appletonN/FYP/documents/Final Report/Gloss.tex

\usepackage{glossaries}

\glstoctrue
\makenoidxglossaries

\newglossaryentry{BlueLight}
{
    name=blue light,
    description={Short wavelength, high-energy - usually below 550nm}
}

\newglossaryentry{flux}
{
	name=luminous flux,
	description={the perceived power of a light source, measured in lumen}
}

\newglossaryentry{lux}
{
	name=lux,
	description={the SI unit of illuminance, measured by \gls{flux} per unit area. Equivalent to $lumens/m^2$}
}

\newglossaryentry{solar}
{
	name=solar irradiance spectrum,
	description={the spectrum output by the sun as measured from the surface of the earth}
}

\newacronym{pcbs}{PCBs}{Printed Circuit Boards} 

\newacronym{cfl}{CFL}{Compact Fluorescent Lamp} 

\newacronym{morning}{DY}{Daytime}

\newacronym{afternoon}{ST}{Sunset}

\newacronym{evening}{TW}{Twilight}

\newacronym{night}{NX}{Night}

\newacronym{spd}{SPD}{Spectral Power Density}

\newacronym{sam}{SAM}{Spectral Angle Mapper}

\newacronym{cri}{CRI}{Colour Rendering Index}

\newacronym{s}{S}{Short-Wavelength}

\newacronym{m}{M}{Medium-Wavelength}

\newacronym{l}{L}{Long-Wavelength}

\newacronym{iprgc}{ipRGC}{intrinsically photosensitive Retinal Ganglion Cells}

\newacronym{rtc}{RTC}{Real Time Clock}

\newacronym{ic}{IC}{Integrated Circuit}

\newacronym{esd}{ESD}{Electro-static Discharge}

\newacronym{cct}{CCT}{Correlated Colour Temperature}

\newacronym{car}{CAR}{Cortisol Awakening Response}

\newacronym{sad}{SAD}{Seasonal Affective Disorder}
