appletonN/FYP/documents/Final Report/PDFs/VI2.pdf

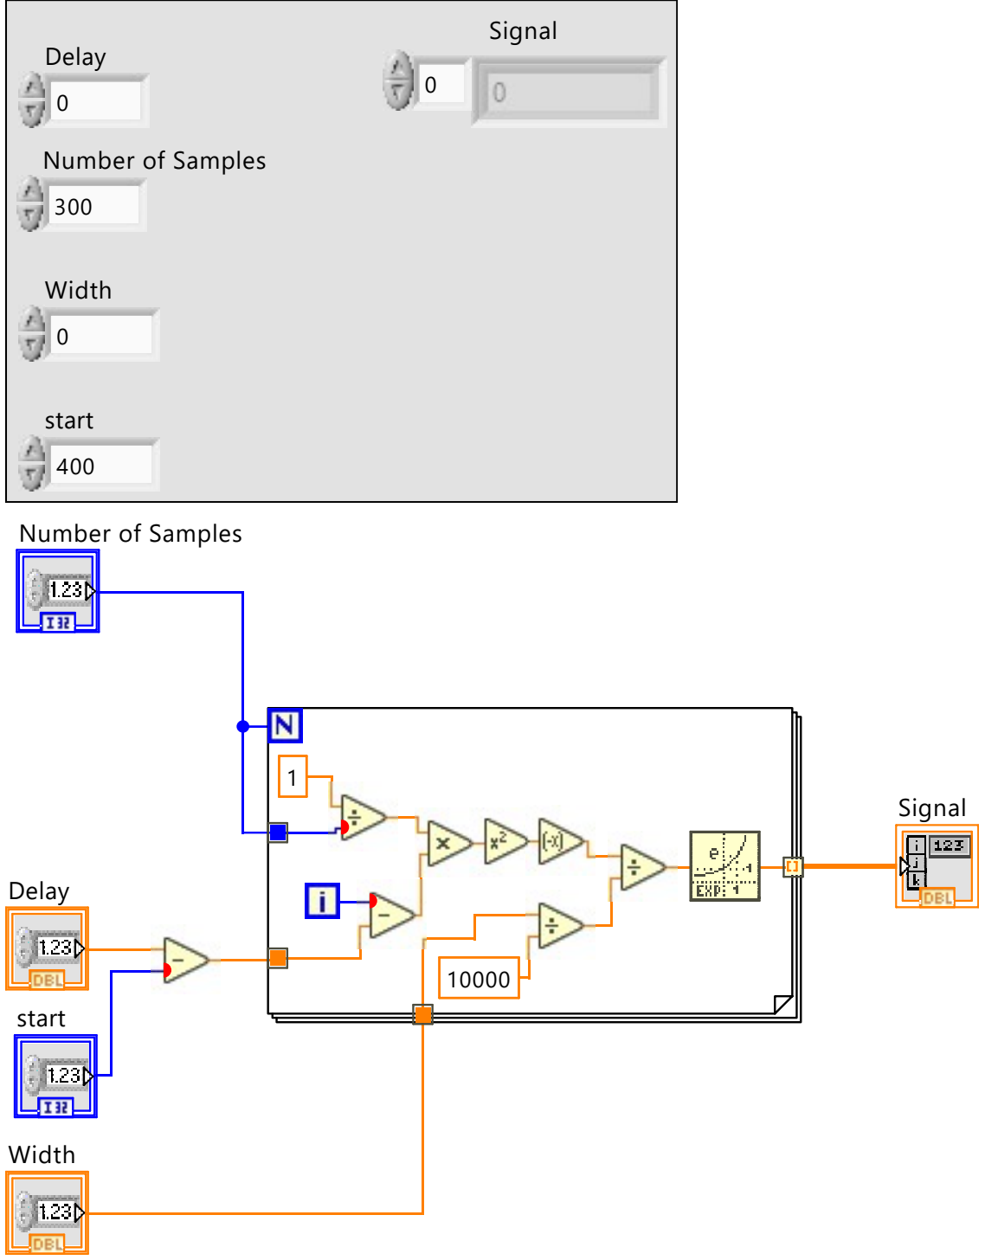
[picture p1: figure]
Delay; Signal; Number of Samples; Width; start
