appletonN/FYP/documents/Final Report/PDFs/VI3.pdf

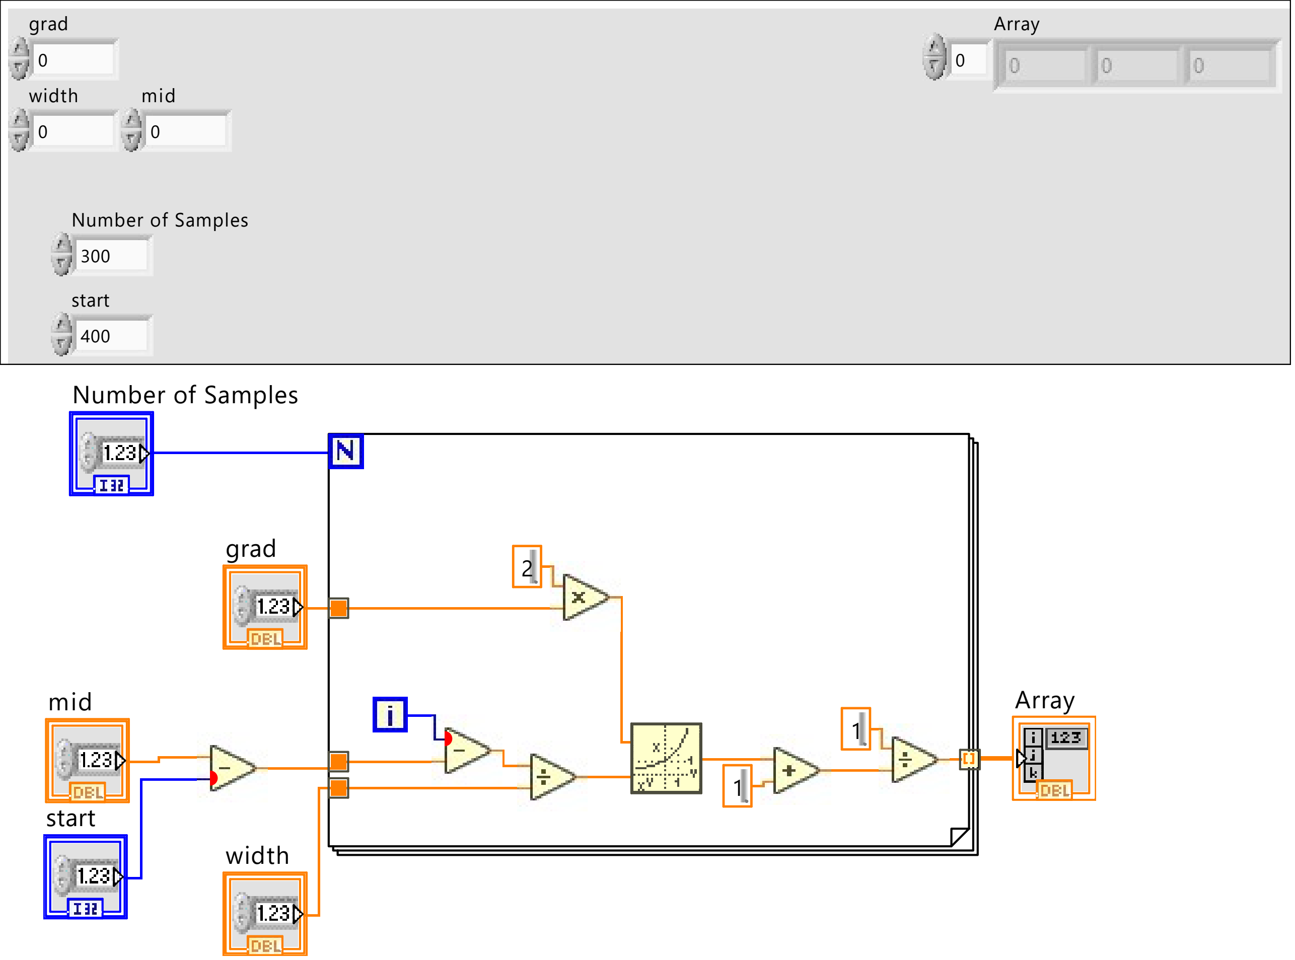
[picture p2: figure]
grad; width; mid; Number of Samples; Array; start
