appletonN/FYP/documents/Interim Proposal/Main/Interim Preposal.pdf

# Parting the Clouds: working towards an affordable natural-lighting solution

N. Appleton

16019243
nicholas2.appleton@live.uwe.ac.uk

### December 8, 2020

I. Introduction and Aims
F

or the past 100 years, the primary use of artificial light has been to allow people to operate beyond the scope of daylight hours. The foremost consideration, therefore, has been directed at the visual (Webb, 2006). However, since the turn of the 21st century, we have known that there are many non-visual effects of light, including the fact that it plays a central role in the sleep-wake cycle (or circadian rhythm) (Provencio et al., 2000; Berson et al., 2002). There is an extensive body of research showing that bright light can delay sleep onset and have negative ramifications on sleep quality. Not only does light affect our sleep, but it also affects our waking experience: mood is affected largely by light exposure, as are focus, attentiveness and even cognitive performance. All these factors are influenced by the environmental light conditions to which most people don not give a second thought. We can find the optimal light exposure for any time of day simply by looking outside: our bodies are naturally and precisely tuned to the cycles of the sun, and only in the past few hundred years have we forsaken these rhythms with large-scale artificial lighting.
The aims of this project are twofold: ’To produce a device that can replicate the visual output of the sun as closely as possible’ and ’To validate the design by measuring the spectral output and validating the efficacy’. Further aims would be to develop the device as a product: improving the user interface and expanding its functionality. The production of the device will be split between me and Vojtˇech Halenka. The completion of these goals will be made against a Product Requirements document (see appendix D).
The objectives of the project, which will help achieve the aims, are to work with Vojtˇech to produce a schematic that can be tested and turned into a PCB that we can get printed. With these first PCBs we can fully test our design, make any relevant changes and produce a second design from that. Once we know we have a working unit, I will be able to test the spectral output and assess the effect of the device on sleep (the research phase will be conducted independent of Vojtˇech). If This is completed in a timely manner, I would also like to implement an improved UI and extra features to make the device more complete and user-friendly.

II. Justification

The device we are producing will have the fundamental purpose of improving the health of its users. There is a wealth of knowledge demonstrating how important exposure to natural lighting patterns is on our well-being, but none of the devices currently on the market are appropriate for the problem we are trying to solve. Through a competitor review (Appleton, 2020), I found that the majority of

1

Interim Report • December 8, 2020• 16019243

circadian lighting is for industrial (office and warehouse) use, rendering it almost pointless if the workers go home to a house equipped with standard LED lighting technologies. The few consumer grade circadian lights on the market are extortionately expensive: upwards of $200 for a single bulb. Moreover, these can only be used in places with existing bulb fittings and therefore are not feasible for many environments. There are other devices on the market that claim to respect circadian rhythms, but many of these devices are designed either for use at specific times of day, or for ‘mood lighting’ with circadian regulation as an option only if you “hack” them - ‘entertainment, not entrainment’ as I like to say - therefore they are not equipped with appropriate lighting for the evening hours. By creating a standalone, 12-Volt, expandable and affordable solution, we will be bringing this essential technology to many more people to whom it is not currently available.
If we look at the United Nations’ Sustainable Development Goals (UN-DESA, 2016), we can see that ‘Ensuring healthy lives and promoting well-being for all at all ages’ is one of the goals, as is ‘Making cities and human settlements inclusive, safe, resilient and sustainable’. My project will try to encompass both of these goals by creating a more healthpromoting, human-centric built environment that cares for the health of those exposed to its outputs. It will also be helping to reduce energy consumption by replacing outdated technologies such as incandescent and fluorescent bulbs that are both inefficient and polluting to produce and dispose of.
By making the device modular - consisting of many mix-and-match components - the user will be able to customise their device to fit their space, requiring fewer unique module designs to be produced, while still providing a scalable solution to the problem.

### III. Scope

This project aims to deliver a works-like prototype that can be used to assess the validity of the design for use as an all-day lighting system. The design considerations for a final product, as well as user safety, will be observed throughout the design process. Ideally, the final outcome will be a looks-like, works-like prototype in the form of a demonstrable unit. There are 3 main milestones for the development: completion of a functional unit, testing and validation of said unit, and furthering the design and usability once the functionality has been validated.
Doing a human trial of the effects on sleep is Out-Of-Scope of this project, both due to the ethical and resource requirements of a sleep study and due to the current pandemic. However, the effects on sleep will be assessed via observation of the output spectra of the device. The current global situation of Covid-19 will have significant impacts on the completion of this project. Delivery times for components could be affected and access to equipment will be severely limited. Throughout the project, government guidance will always be followed and contingency plans put in place for each part of the project. While we are awaiting the delivery of components and PCBs, I will develop a simulator that can be used to calculate the output of the device, ensuring that I can complete the research, even if no demonstrable unit can be fabricated. The Gantt chart will also reflect this situation by allowing more time for delivery and development.
The device will be an autonomous system that requires user-input only to set parameters of the time-scale events. It will be developed from ‘cradle to grave’ with an emphasis on giving me a broader understanding of the tools and techniques used to design and develop systems like this to a given requirement. I hope this project will offer me a more practical experience of the design cycle and processes involved with creation of automated systems.

IV. Proposed Research Questions

The main question that will be researched through this project will be “Can we can develop a device that is suitable to use through-

2

out the day and night without negatively impacting the human cycles that we are aware of, namely the circadian rhythm?” An additional question that will be considered throughout the project will be “Would this device be a viable product that appeals to consumers?” Further questions would include how people respond to using the product and whether to implement more natural variations such as ‘clouds’ and flickering ‘firelight’ to observe the effect this might have on users. However, it is unlikely that the scope of this project will allow for these questions to be answered - perhaps in future research.

V. Initial Research

Electric lighting plays a large role in modern life: extending our day beyond the natural boundaries of sunset and sunrise. Our primary concern for lighting has become to provide us with accurate visual performance beyond the scope of the day - however, in recent years it has become more and more obvious that this is not optimal for human health, or even performance for that matter.
All animals have a built in circadian rhythm that regulates their day/night cycle. This rhythm is fundamental to allow the body to effectively rest - in humans - overnight (Senthilnathan and Sathiyasegar, 2019). The circadian clock controls melatonin production in the brain, an important factor in the generation and quality of sleep (Arendt, 2003). There are many peripheral clocks that help to set the central clock every day and keep it running on-time (Mohawk et al., 2012; Richards and Gumz, 2012). One of the most important of these cues comes from light exposure (Czeisler et al., 1986; Laakso et al., 1993), especially blue, short-wavelength light (Thapan et al., 2001; Figueiro et al., 2013). However, this is one of the most overlooked areas in modern built environments (Webb, 2006).
There are some solutions to counter this pervasive problem, for example wearing amber tinted glasses to block out the shortest wavelengths of light was shown by Kimberly and

Phelps (2009) to improve sleep quality. Not everyone wants to have to wear amber glasses after dark every night, especially in their own home! Furthermore, it greatly affect one’s ability to see colours accurately when wearing such glasses. Other methods include ‘Smart Lighting’ which can be set to fade into different colours at different times, but while this may improve mood (McCloughan et al., 1999), it will not have a hugely positive effect on sleep as RGB LEDs are used to achieve the desired colour. This means the colour will almost certainly have a harmful blue component, while according to Gilewski (2018), RGB LEDs are a wholly harmful form of lighting (although this study is lax in its sources and its referencing, so perhaps should be taken with a pinch of salt).
Older technologies, such as incandescent bulbs, produce a spectrum much closer to that of firelight (f.lux Software LLC, n.d.). However, they are so inefficient that they are banned from being sold in the EU (2012). The replacements for these technologies - Fluorescent bulbs and LEDs - have been shown to produce harmful light (Ueda et al., 2009; Kuse et al., 2014; Niwano et al., 2014; Marek et al., 2018; Nakamura et al., 2018), and many traditional bulbs of this type contain hazardous materials such as lead (Lim et al., 2013). However, there is huge potential for LEDs to save much power in the built environment (Montoya et al., 2017), but this shouldn’t come at the expense of human (circadian) health.
Another surprising impact the circadian rhythm has on our lives is in the realm of cancer; a powerful link has been demonstrated between circadian suppression and breast cancer in rats (Mhatre et al., 1984; Otálora et al., 2008; van den Heiligenberg et al., 1999) and in humans - mostly observed in shift workers and flight attendants (Hansen, 2001; Davis et al., 2001; Schernhammer et al., 2001, 2006; Lie et al., 2006; Tokumaru et al., 2006; O’Leary et al., 2006; Kolstad, 2008; Stevens, 2009; Stevens et al., 2014).
It’s not all bad for blue light, though. It is widely accepted that bright light is an effec-

3

tive treatment for Seasonal Affective Disorder (SAD) (Eastman et al., 1998; Magnusson and Kritbjarnarson, 1991) and lee et al. (1997) found in their meta-analysis that shorter (blue) wavelengths appear to have a greater effect. Furthermore, many studies have shown a positive correlation between blue light and attentiveness, cognitive performance and visual tasks throughout the day (Sun-Young, 2005; Mills et al., 2007; Lehrl et al., 2007; Hawes et al., 2012). This also has been shown to be linked directly back to the circadian rhythm (Hawes et al., 2012).
From the evidence presented here, I hope it is clear why a product that can produce a spectrum close to that of the sun would be beneficial to people’s health and well-being throughout the day, and therefore why we have decided to develop and test one.

VI. Methodology

The word methodology is defined by Collins English Dictionary (2014) as “a system of methods and principles for doing something, for example for teaching or for carrying out research”. An example of this would be the the Scientific Method which is a method in which knowledge is acquired through experimentation and analysis to confirm or deny a hypothesis.
In section IV, I discussed the proposed research questions in which I laid out my primary research question, which can be made into the hypothesis H1: “We can produce a device that can effectively be used throughout the day while avoiding a circadian phase-shift of more than 30 minutes”. This hypothesis can be tested with various tools and techniques provided by the literature and can be easily falsified, too. This hypothesis will be investigated using quantitative methods: collecting empirical data that will be analysed to determine if the null or alternative hypothesis can be accepted. However there are other peripheral hypotheses relating to the development of the device as a viable product. Some qualitative research would ideally take place to assess how people react to various aspects of the device which will lead to a discussion about how further development could take place, but this may be out of scope of this project due to the pandemic situation.
A more top-down view of the falsifiable points that will be used to determine whether we have succeeded in the project are laid out in the Requirements document (See appendix D).
While the term ‘method’ can easily be confused with a methodology, it refers to how the data will be collected, or how the subject will be observed. For the hypothesis H1, experiments will be the method used to obtain the data; I will use a hyper-spectral camera to capture the spectra of the device alongside the spectra of other, similar devices. The outputs of these devices can then be compared and calibrated to more absolute values by comparing to a known source. These data will then be used to assess the efficacy of the device as a night-time light. Another method of secondary data can be used to compare the results with a broader catalogue of results gathered by others.
For any qualitative research that were to take place, I would ideally use a participant observation and survey methods to discover people’s opinions on the given research topic, but it is more feasible to just use a survey in these times.

VII. Project Management and

Planning

The project management software ClickUpTM Project Management (2020) software will be used as the primary project management tool: it will contain the open, in progress and closed tasks; the Gantt chart and due dates of each deliverable, milestone and task; and documents such as my logbook and meeting minutes will be stored there.
Weekly meetings are taking place between my supervisor and me, and minutes are being kept for these meetings in my logbook. I am also having weekly meetings with V. Halenka to discuss the progress of the development

4

phase, delegate tasks, make design decisions and consolidate new knowledge in the subject. The time-scale of the project has been heavily influenced by the supply chain and potential delays that may occur. As can be seen in the Gantt chart (See appendix ), we have allocated up until February for the final prototype to be ready. Work towards the research goals will happen alongside the development of the prototype - especially during the periods allocated for delivery.
The project will require more resources than some, as it involves the design and production of hardware; we will be sure to keep our minds on the sustainability of the solution by ensuring that all electronic components used are RoHS compliant. The design of the device is also modular which not only will make it more accessible, but will reduce the obsolescence of the product, as individual modules can be replaced when needed, rather than having to replace the whole unit. Another environmental implication will be the shipping of the PCBs from the factory in China to us in the UK. This is difficult to avoid as any UK-based PCB companies are well out of our budget. However, as this is a very limited production run, this could be re-assessed in the event of larger-scale production. Other resources include a hyperspectral camera (already sourced) which does not have any upfront environmental hazard as it is already at the university. The only other identified resource that I require is software such as Matlab and LABview that are already provided by the university (See Appendix C). As there are not going to be any observations made on humans, the ethical considerations will be very limited. An Ethics checklist has been completed with my supervisor to ensure that the project is ethically valid. If qualitative data is required at the later stages of the project then I will re-consider the ethical implications, as this will require thought on data-handling and management and respect of the participant’s privacy and right to withdraw. If this does happen, then I will collect no personal data from the participants and all responses will be anonymised with an identification number that can be used to withdraw from the research.
This project definitely has some limitations to it: the budget is very limited for a project such as this and £75 is not enough to design and build a working prototype. Fortunately, as there are 2 of us working on the hardware, we will be able to double this budget, which should be enough to make at least a couple of demonstrable units. This project is also very limited in time: we have only 6 months to create, test, and research a working prototype
- alongside all of our other modules; we will have to manage our time well to be able to complete the task. Further, due to Covid-19, we have very limited access to facilities, which will make it harder to do effective testing and production. To mitigate this, we will be using strategies to maximise the efficiency of any lab time we get: we will get the PCBs populated at the factory so we can spend as little time as possible doing production ourselves, and we will ensure that any lab time we get we carefully plan a strategy for how we will use that time.
Throughout the project I will adopt a security-minded approach: all correspondences made will be done so with consideration to the sensitivity of the information being shared. When sensitive data is being shared, I will ensure its security by way of agreement of all relevant parties understanding said sensitivity and signing a security form to ensure that they will not share the information with any outside parties.

VIII. Activities and Results to

Date

To begin the project I conducted a series of interviews with Natural Movement and Lifestyle practitioners to discuss my initial ideas. After 5 interviews I determined that the direction of the project was not what was needed in their field, so I pivoted into circadian lighting, as that is something that all of the interviewees had expressed an interest in. From there I have read through a large amount of the literature

5

relevant to the topic, while concurrently completing the administrative setup of the project; I have set up the project management software ClickUpTM Project Management (2020) and populated it with the overall aims, objectives, milestones and tasks that are required to complete the project. From this, I produced the Gantt chart which is synced to the task list for autoupdating for future ease. The risk assessment and security forms, as well as the resources form, have also been completed (See appendices A, B & C).
To date, V. Halenka and I have a completed initial schematic that is ready to be laid-out onto a PCB and sent off for printing and populating. We have conducted some tests to ensure that some sub-circuits will work as intended and we have conducted a design review of our schematics. We are minimising the risk of slow deliveries by extending the time allocated to them on the Gantt chart, which will be assessed and updated every 2 weeks.
A hyperspectral camera has been sourced from the university and I am in ongoing talks to relocate it to somewhere where I will have access to it. I have also drafted a simulator in LABview for the output of the device to complete some tests before we receive the PCBs and to mitigate the risk of not having access to the hyperspectral camera due to Covid or other unforeseen issues.
A logbook is being kept to record the work that is being done and has been shared with my supervisor.

References

Appleton, N. (2020), Competitor Analysis, https://doc.clickup.com/d/h/2fg5t-890/135795402bf68e8, UWE.

Arendt, J. (2003), ‘Importance and Relevance of Melatonin to Human Biological Rhythms: Melatonin and human rhythms’, Journal of Neuroendocrinology 15(4), 427–431.

Berson, D. M., Dunn, F. A. and Takao, M. (2002), ‘Phototransduction by retinal ganglion cells that set the circadian clock’, Science (New York, N.Y.) 295(5557), 1070–1073.

ClickUpTM | Project | Management | (2020),
https://clickup.com/.

Collins English Dictionary (2014), twelfth edn, Collinns Dictionaries.

Czeisler, C. A., Allan, J. S., Strogatz, S. H., Ronda, J. M., Sanchez, R., Rios, C. D., Freitag,
W. O., Richardson, G. S. and Kronauer, R. E. (1986), ‘Bright light resets the human circadian pacemaker independent of the timing of the sleep-wake cycle’, Science 233(4764), 667– 671.

Davis, S., Mirick, D. K. and Stevens, R. G. (2001), ‘Night Shift Work, Light at Night, and Risk of Breast Cancer’, JNCI: Journal of the National Cancer Institute 93(20), 1557–1562.

Eastman, C. I., Young, M. A., Fogg, L. F., Liu,
L. and Meaden, P. M. (1998), ‘Bright Light Treatment of Winter Depression: A Placebo-Controlled Trial’, Archives of General Psychiatry 55(10), 883.

EU (2012), ‘Directive 2012/27/EU of the European Parliament and of the Council of 25 October 2012 on energy efficiency, amending Directives 2009/125/EC and 2010/30/EU
and repealing Directives 2004/8/EC and 2006/32/EC (Text with EEA relevance)’, https://www.legislation.gov.uk/eudr/2012/27/2020-01-01.

Figueiro, M. G., Bierman, A. and Rea, M. S. (2013), ‘A train of blue light pulses delivered
through closed eyelids suppresses melatonin and phase shifts the human circadian system’, Nature and Science of Sleep 5, 133–141.

f.lux Software LLC (n.d.), ‘F.luxometer’, https://fluxometer.com/rainbow/.

Gilewski, M. (2018), ‘The Ecological Harmfulness of RGB LED Light’, DEStech Transactions on Environment, Energy and Earth Sciences 1(epeee), 89–93.

6

Hansen, J. (2001), ‘Increased Breast Cancer Risk among Women Who Work Predominantly at Night’, Epidemiology 12(1), 74–77.

Hawes, B. K., Brunyé, T. T., Mahoney, C. R., Sullivan, J. M. and Aall, C. D. (2012), ‘Effects of four workplace lighting technologies on perception, cognition and affective state’, International Journal of Industrial Ergonomics 42(1), 122–128.

Kimberly, B. and Phelps, J. R. (2009), ‘Amber Lenses to Block Blue Light and Improve Sleep: A Randomized Trial’, Chronobiology International 26(8), 1602–1612.

Kolstad, H. A. (2008), ‘Nightshift work and risk of breast cancer and other cancers—a critical review of the epidemiologic evidence’, Scandinavian Journal of Work, Environment & Health 34(1), 5–22.

Kuse, Y., Ogawa, K., Tsuruma, K., Shimazawa, M. and Hara, H. (2014), ‘Damage of photoreceptor-derived cells in culture induced by light emitting diode-derived blue light’, Scientific Reports 4(1), 5223.

Laakso, M.-L., Hätönen, T., Stenberg, D., Alila,
A. and Smith, S. (1993), ‘One-hour exposure to moderate illuminance (500 lux) shifts the human melatonin rhythm’, Journal of Pineal Research 15(1), 21–26.

lee, T. M. C., Chan, C. C. H., Paterson, J. G., Janzen, H. L. and Blashko, C. A. (1997), ‘Spectral properties of phototherapy for seasonal affective disorder: A meta-analvsis’, Acta Psychiatrica Scandinavica 96(2), 117–121.

Lehrl, S., Gerstmeyer, K., Jacob, J. H., Frieling, H., Henkel, A. W., Meyrer, R., Wiltfang, J., Kornhuber, J. and Bleich, S. (2007), ‘Blue light improves cognitive performance’, Journal of Neural Transmission 114(4), 457–460.

Lie, J.-A. S., Roessink, J. and Kjærheim, K. (2006), ‘Breast Cancer and Night Work among Norwegian Nurses’, Cancer Causes & Control 17(1), 39–44.

Lim, S.-R., Kang, D., Ogunseitan, O. A. and Schoenung, J. M. (2013), ‘Potential Environmental Impacts from the Metals in Incandescent, Compact Fluorescent Lamp (CFL), and Light-Emitting Diode (LED) Bulbs’, Environmental Science & Technology 47(2), 1040–1047.

Magnusson, A. and Kritbjarnarson, H. (1991), ‘Treatment of seasonal affective disorder with high-intensity light: A phototherapy study with an icelandic group of patients’, Journal of Affective Disorders 21(2), 141–147.

Marek, V., Mélik-Parsadaniantz, S., Villette, T., Montoya, F., Baudouin, C., Brignole-Baudouin, F. and Denoyer, A. (2018), ‘Blue light phototoxicity toward human corneal and conjunctival epithelial cells in basal and hyperosmolar conditions’, Free Radical Biology and Medicine 126, 27–40.

McCloughan, C. L. B., Aspinall, P. and Webb,
R. (1999), ‘The impact of lighting on mood’, Lighting Research and Technology 31(3), 81–88.

Mhatre, M. C., Shah, P. N. and Juneja, H. S. (1984), ‘Effect of varying photoperiods on mammary morphology, DNA synthesis, and hormone profile in female rats’, Journal of the National Cancer Institute 72(6), 1411–1416.

Mills, P. R., Tomkins, S. C. and Schlangen, L. J. (2007), ‘The effect of high correlated colour temperature office lighting on employee well-being and work performance’, Journal of Circadian Rhythms 5(1), 2.

Mohawk, J. A., Green, C. B. and Takahashi,
J. S. (2012), ‘Central and Peripheral Circadian Clocks in Mammals’, Annual Review of Neuroscience 35(1), 445–462.

Montoya, F. G., Peña-García, A., Juaidi, A. and Manzano-Agugliaro, F. (2017), ‘Indoor lighting techniques: An overview of evolution and new trends for energy saving’, Energy and Buildings 140, 50–60.

Nakamura, M., Yako, T., Kuse, Y., Inoue, Y., Nishinaka, A., Nakamura, S., Shimazawa, M. and Hara, H. (2018), ‘Exposure to excessive

7

blue LED light damages retinal pigment epithelium and photoreceptors of pigmented mice’, Experimental Eye Research 177, 1–11.

Niwano, Y., Kanno, T., Iwasawa, A., Ayaki,
M. and Tsubota, K. (2014), ‘Blue light injures corneal epithelial cells in the mitotic phase in vitro’, British Journal of Ophthalmology 98(7), 990–992.

O’Leary, E. S., Schoenfeld, E. R., Stevens, R. G., Kabat, G. C., Henderson, K., Grimson, R., Gammon, M. D. and Leske, M. C. (2006), ‘Shift Work, Light at Night, and Breast Cancer on Long Island, New York’, American Journal of Epidemiology 164(4), 358–366.

Otálora, B. B., Madrid, J. A., Alvarez, N., Vicente, V. and Rol, M. A. (2008), ‘Effects of exogenous melatonin and circadian synchronization on tumor progression in melanomabearing C57BL6 mice’, Journal of Pineal Research 44(3), 307–315.

Provencio, I., Rodriguez, I. R., Jiang, G., Hayes,
W. P., Moreira, E. F. and Rollag, M. D. (2000), ‘A Novel Human Opsin in the Inner Retina’, The Journal of Neuroscience 20(2), 600–605.

Richards, J. and Gumz, M. L. (2012), ‘Advances in understanding the peripheral circadian clocks’, The FASEB Journal 26(9), 3602–3613.

Schernhammer, E. S., Kroenke, C. H., Laden, F. and Hankinson, S. E. (2006), ‘Night Work and Risk of Breast Cancer’, Epidemiology 17(1), 108–111.

Schernhammer, E. S., Laden, F., Speizer, F. E., Willett, W. C., Hunter, D. J., Kawachi, I. and Colditz, G. A. (2001), ‘Rotating Night Shifts and Risk of Breast Cancer in Women Participating in the Nurses’ Health Study’, JNCI: Journal of the National Cancer Institute 93(20), 1563–1568.

Senthilnathan, S. and Sathiyasegar, K. (2019), Circadian Rhythm and Its Importance in Human Life, SSRN Scholarly Paper ID 3441495, Social Science Research Network, Rochester, NY.

Stevens, R. G. (2009), ‘Light-at-night, circadian disruption and breast cancer: Assessment of existing evidence’, International Journal of Epidemiology 38(4), 963–970.

Stevens, R. G., Brainard, G. C., Blask, D. E., Lockley, S. W. and Motta, M. E. (2014), ‘Breast cancer and circadian disruption from electric lighting in the modern world’, CA: A Cancer Journal for Clinicians 64(3), 207–218.

Sun-Young, L. (2005), ‘An Experiment on Lighting Environment for some Behavior in Housing’, Journal of the Korean housing association 16(4), 65–71.

Thapan, K., Arendt, J. and Skene, D. J. (2001), ‘An action spectrum for melatonin suppression: Evidence for a novel non-rod, non-cone photoreceptor system in humans’, The Journal of Physiology 535(1), 261–267.

Tokumaru, O., Haruki, K., Bacal, K., Katagiri, T., Yamamoto, T. and Sakurai, Y. (2006), ‘Incidence of Cancer Among Female Flight Attendants: A Meta-Analysis’, Journal of Travel Medicine 13(3), 127–132.

Ueda, T., Nakanishi-Ueda, T., Yasuhara, H., Koide, R. and Dawson, W. W. (2009), ‘Eye damage control by reduced blue illumination’, Experimental Eye Research 89(6), 863– 868.

UN-DESA (2016), ‘The Sustainable Development Goals Report 2016’, UN .

van den Heiligenberg, S., Deprés-Brummer, P., Barbason, H., Claustrat, B., Reynes, M. and Lévi, F. (1999), ‘The tumor promoting effect of constant light exposure on diethylnitrosamine-induced hepatocarcinogenesis in rats’, Life Sciences 64(26), 2523– 2534.

Webb, A. R. (2006), ‘Considerations for lighting in the built environment: Non-visual effects of light’, Energy and Buildings 38(7), 721–727.

8

Page 1 of 1

Describe the activity being assessed: Producing a natural-cycle based lighting system | Assessed by: Matthew Studley | Endorsed by:
Who might be harmed: Nick Appleton (NA) 1 How many exposed to risk: | Date of Assessment: 03/11/20 | Review date(s):
Hazards Identified (state the potential harm) | Level | | Level | By whom and by when | Date completed
Potential use of Lab equipment | | equipment is used properly and switched off when not in use | | | consistently | Ongoing
Covid-19 Risk from face-to-face meetings | | and where this is not possible, ensuring to meet in appropriate, well-ventilated spaces with 3-layered face coverings and keeping at least 1.5m distance | | | meeting | Ongoing
Soldering: very high temperature, hand-held iron | | it is not being used. Minimise the number of sessions spent soldering, while not allowing any rushing to occur. | | | soldering | Ongoing
High-power electronics pose an electrocution risk | | grounding bracelet connected to an anti-static mat and earthing point to discharge any potentially harmful electrical surges | | | whenever handling electronics | Ongoing
Isolation from working from home and related stress | | that overworking doesn’t occur by time-boxing various tasks and implementing effective project-management strategies | | | under evaluation | Ongoing
Existing Control Measures | S | L | Risk
Additional Control Measures | S | L | Risk
Existing risk assessment including mitigations | 3 | 2 | 6 | Keeping a clean workspace and ensuring that
3 | 1 | 3 | NA -
Government and University rules and guidance | 3 | 3 | 9 | Conducting all meetings online where possible,
3 | 1 | 3 | NA – Every
2 | 3 | 6 | Make sure to store the iron in the holder when
2 | 2 | 4 | NA – all
4 | 2 | 8 | Whenever handling electronics, wearing a
3 | 1 | 3 | NA –
3 | 3 | 6 | Implement stress-relief measures and ensure
2 | 1 | 2 | NA – Always

RISK MATRIX: (To generate the risk level).

Very likely 5

Likely 4

Possible 3

Unlikely 2

Extremely unlikely 1

Likelihood (L) Severity (S) | Minor injury – No first aid treatment required 1 | Minor injury – Requires First Aid Treatment 2 | Injury - requires GP treatment or Hospital attendance 3 | Major Injury 4 | Fatality 5

ACTION LEVEL: (To identify what action needs to be taken).

POINTS: | RISK LEVEL: | ACTION:
1 – 2 | NEGLIGIBLE | No further action is necessary.
3 – 5 | TOLERABLE | Where possible, reduce the risk further
6 - 12 | MODERATE | Additional control measures are required
15 – 16 | HIGH | Immediate action is necessary
20 - 25 | INTOLERABLE | Stop the activity/ do not start the activity

## GENERAL RISK ASSESSMENT FORM

A. Risk Assessment

Engineering Design and Mathematics
- UK Engineering Council Guidance on Security

Security is an important consideration for any project and in any workplace. UK SPEC provides guidance on security and outlines how it expects professional engineers to conduct themselves with respect to security. This guidance is split into six key principles. Your task is to visit the UK SPEC security page and read through the tips provided for each principle.
Using the tips on the webpage provide at least one example for each of the six principles that you can directly link to your project or that should be considered in the role of Professional Engineer. Then summarise your findings in the comments box below.
The link is https://www.engc.org.uk/security
- How would you adopt a security-minded approach to your project?
- be responsive to changes in the operating environment, including the impact of changes in use of the asset or system, its wider connectivity and emerging threats and vulnerabilities. With the current situation with working from home and potential changes to the working environment, this will be relevant to how I consider security.
- remember that security risk assessment is an aid to professional judgement, not a substitute for it. I will continue to assess any and all security risks throughout the project to ensure that any risks are neutralised as quickly as possible.
- What should you consider in order to apply responsible judgement and take a leadership role?
- working with other professionals to ensure informed, proportionate, holistic judgements. When I am working with other professionals – eg. When using equipment like a hyper-spectral camera – I will strive to ensure that we both are remining security minded throughout the work
- being prepared to challenge assumptions and proposals. If when working with one of these professionals, they do something that could potentially cause a security risk, I will certainly be prepared to challenge them and stop them from presenting those risks.
- How will you ensure that your project complies with legislation and codes, while understanding intent and prepared to seek further improvements?
- be aware of, and comply with, the security-related laws in countries where they operate or where their products or services will be used. As I will be developing a prototype product, I will ensure that I am aware of the relevant laws and will comply with them entirely when developing my product.
- be open-minded and avoid using regulations to facilitate complacency. By constantly evaluating the security risks, I will ensure that I am constantly staying on the ball, and not becoming complacent.
- How do you ensure good security-minded communications?
- adopt appropriate measures to protect sensitive information when it is communicated, used and stored, both within and beyond their organisation. Whenever sharing information, I will ensure that it is done in a secure way, and I will communicate when it needs to remain secure.
- recognise the persistent nature and accessibility of information published on the internet or otherwise made publicly available. Before making any information publicly available on the internet, I will ensure to conduct a thorough review of the content and redact or not publish any sensitive information.
- recognise that indiscriminate publication of project, technical or personal information can aid reconnaissance and enable security breaches through social media. No personal, technical or project information will be shared on social media.
- ensure responsible use of social media use for both personal
and professional purposes. I will avoid using social media for ANY professional or personal uses throughout the year.
- How would you go about understanding, complying with and seeking to improve lasting systems for security governance?
- ensure that there are appropriate mechanisms for reporting and feedback on security incidents and issues. Security discussions will occur often with my supervisor to ensure that any security issues can be reported as quickly as possible.
- contribute to the development and review of relevant security management frameworks, particularly about aspects which may not be well understood. All the security frameworks used for this project will be made by me with the specifics of this project in mind
- What do you need to consider when contributing to public and professional awareness of security?
- be security-minded during public discussion. When publicly discussing the project, I will ensure not to share any sensitive information about any part of the project.
- contribute to public and professional awareness of security by sharing and promoting knowledge of effective solutions. When I come across useful security resources, I will share them with my supervisor and ask that he can share them to more people that that resource will be relevant to.

Summarise how you will address security in your project (max 200 words)
By avoiding sharing any information about my project publicly, I will be able to reduce a large portion of the security risks involved. If I do speak about my project with others, I will make sure to only share with them information that has been labelled as safe. If it is required for me to share sensitive information with any other party, I will ensure that they are aware of the sensitivity of the data and that they have signed a form to ensure they do not share this data without my consent, which will be withheld unless the sharing of said data is strictly necessary.
As I do not plan to use human subjects in my project, I hope to minimise the amount of sensitive information that is collected for the project. However, I will still scrutinise every piece of information gathered and generated for the project to ensure that it doesn’t pose a security risk.
B. Security Form

# Dissertation Project Resources Form

Name: Nicholas Appleton | Student ID: 16019243

### Supervisor: Matthew Studley

[If you are carrying out a desk-based study and/or are only using the library or ITS facilities available at UWE, the faculty’s risk assessment procedures will sufficiently cover your activities. In these circumstances, you should identify this on your risk assessment form, which you should attach -

### along with this form - to your Interim Research Proposal.]

Please sign below to confirm your request for resources.

### Student: | 02/12/20

### Supervisor: |

### Further Resources – what else will you need?

R-Block workshop | □
N-Block workshop | ⊠
3D printing | □
Laser cutting | □
Large format printing | □
Miscellaneous | □

### Labs:

Structures | □
Materials | □
Composites | □
Hydraulics | □
Wind tunnel/aero | □
Car/flight simulator | □
Engine test bays | □
Robotics | □
Dynamics | □

If you have ticked any of the above, please fill out a risk assessment of your activities.

Have you spoken to a technician? | Yes | x | Not yet | □

### Materials - outline the materials required for your project:

Electronic components
- Resistors and Capacitors
- LEDs
- USB Circuits
- Transistors
- SD card
- Alphanumeric Display
- Power regulation
- Input and Output ports
- PCBs (printed and placed)
- Optical Encoder
- RTC module

University Resources
- Electronics Lab
- Hyperspectral Camera and Software
- Matlab & Labview Software
C. Resources Form

Context for Use

ID | CX
1 | Users must be able to use this light as their main light source throughout the day
2 | Should be able to light spaces of any size (scalable solution)

Key Features

Sleep

ID | SL1
1 | Should not affect users sleep in any meaningful way by only exposing them to appropriate spectra after dark

High-Level Requirements

Cycles

ID | CY
1 | Should expose users to as natural light-patterns as possible throughout the day and night

Morning and Daytime

ID | DY1
1 | Must provide a wide range of wavelengths during the day
2 | Output spectra should vary throughout the daytime to match the sun's rhythms

Modularity

ID | MD1
1 | Device will have a modular design consisting of multiple different module
2 | One module will be used to control the device, the others will be varying types of LED collections

Usability

ID | US1
1 | Users should be able to work for extended periods under lighting provided solely by this light
2 | the produced light should be bright and accurate in its reproduction of colour
Brightness | p
ID | DY3
1 | Each LED module must be able to
produce a brightness of at least 250 lumens

2 Brightness should be configurable onthe-fly by the user

3 | The time for all events such as sunrise and sunset can be set by the user
4 | The event times of the users location should be collected from the internet if the user so chooses
5 | The device will keep track of time even if mains power is lost

Brightness Calculation

ID | DY4
1 | The calculated spectral output should include an intensity that varies throughout the day
2 | If the user overwrites the brightness, this should not affect the morphology of the spectral output.
3 | When the user overrides the brightness, all spectra up to and including the next predefined point will be edited proportionally to the users
| input
4 | The highest and lowest brightness levels that are output should be configurable by the user

Functional Requirements

3 Evening/night Module will contain amber and red colours for use after dark

LED Modules

ID | MD2
1 | There will be at least 3 types of LED module:
2 | Daytime Module will contain only white lights, for use in the morning and dyatime
4 | All-day Module will have all a configurable spectrum in which all the colours' intensities can be edited

Compatibility

ID | MD3
1 | Any combination of LEDs should be able to be used with one controller
2 | LED modules output spectra should be accurate within their remit of wavelengths
3 | Multiple controllers should be able to be connected and work in tandem to control 1 light system

Circadian Effects

ID SL2

1

Device must be able to cause no circadian phase shift by having an option to produce light of less than 5 Equivalent Daylight Lux (EDL)

Control Modules

ID | MD4
1 | Control must have minimal user input and output to allow for ease of use in
| all conditions
2 | All user inputs should be expandable by adding more of those features (eg. an extra on/off switch for the other side
| of the room)

Spectral outputs

ID | DY2
1 | Spectral Outputs should be calculated based on a set of given spectra, each with an associated time

2

The Spectrum will be calculated based on the previous and next pre-defined spectrum, scaled by the temporal distance from each

Colourimetry

ID | US2
1 | All LED modules should have a Colour Rendering Index of at leas 80%

Time Setting

ID | SL3
1 | The user can set the time manually
2 | The Device should be able to automatically ascertain the time via a WiFi connection to the internet

Implementation Options
Data storage

ID DT1

1

There could be an SD interface to allow the user to upload custom data onto the device without requiring technicalt knowledge

WiFi Credentials

ID | DT2
1 | WiFi credentials such as SSID and
passwords could be stored on the SD card and read by the device when it needs to connect to the internet

Spectral Data

ID DT2

1

An SD card could be used to upload custom spectra to the device so that users can edit their own exposure

throughout the course of the day

2

Default spectra should be hard-coded onto the device so that no external features are required for the device to function

Brightness Calculation

ID | DY4
1 | A single push knob for navigating the interface could be used to minimise the number of inputs

2

Using a single knob, all 4 directions of navigation can be achieved: up and

down by turning, select by pressing the knob and back by double-tapping or long pressing it.

3 A capacitive touch pad can be used as an on off switch that can be of any size

- improving ease of use in the dark for example

4 The highest and lowest brightness levels that are output should be configurable by the user

Power

ID | PW1
1 | Device should consume as little power as necessary for it to fulfil its function
2 | Device should be compatible with a wide range of possible sources to allow for broad use-cases

Maximum Power Consumption

ID | PW2
1 | Device should use a 12V supply as this is very common and would make the device usable from mains supplies to car batteries
2 | A controller module should consume no more than 500mA of continuous current draw during operation
3 | The average consumption of a controller unit over the course of one hour should be no more than 50mA
4 | An LED module should consume no more than 1500mA to produce
| continuous lighting of 1500 lumens

Low-Power / Mobile considerations

ID | PW3
1 | A small internal battery can be used to prevent the device from losing its time data in the event of a power-failure with the use of a RTC
2 | There should be a low-power mode that the device can always return to for minimising power consumption where required

## Requirements Document

N. Appleton
19.11.20
Rev: 2.0
D. Requirements Documentation

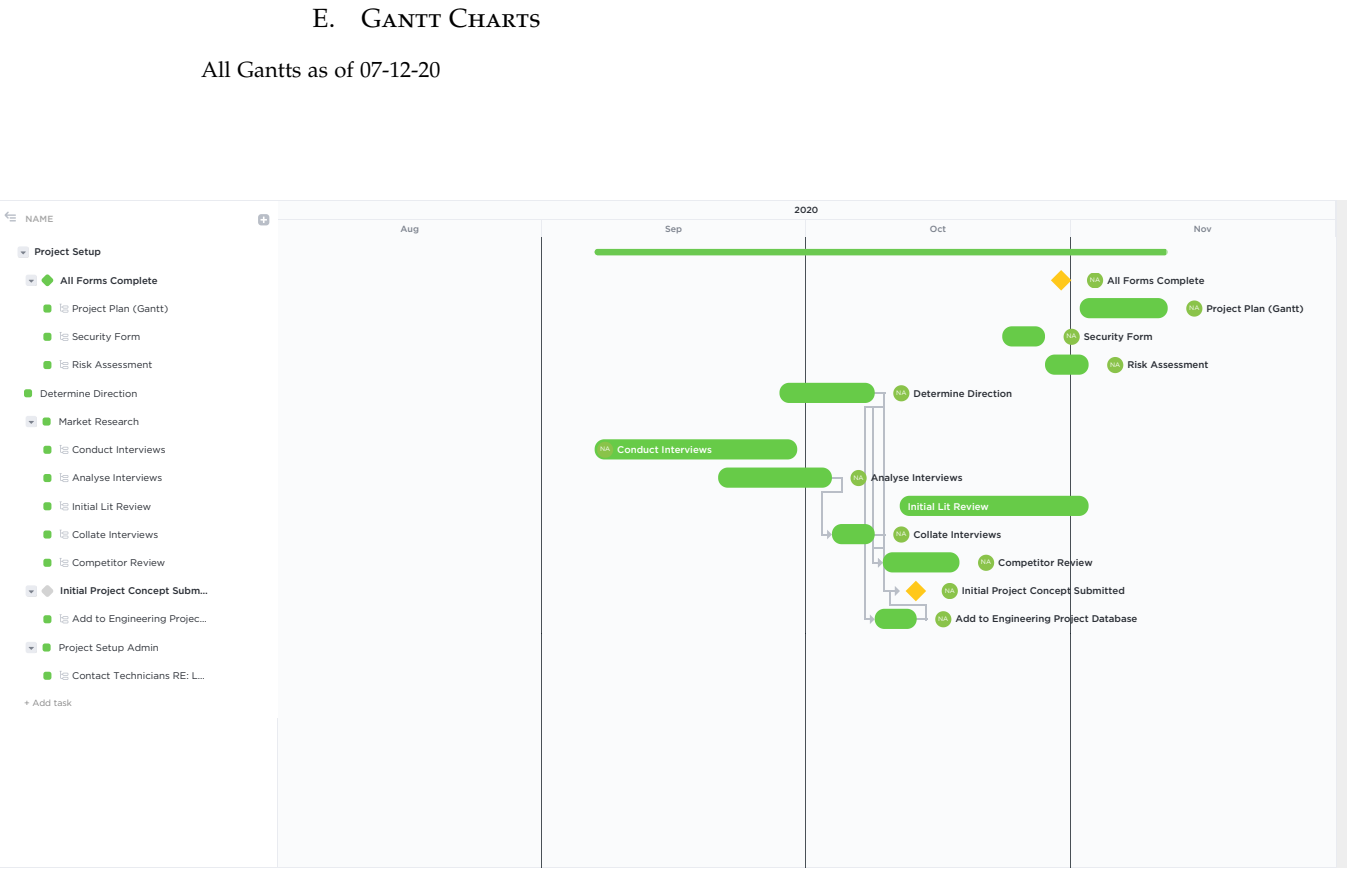
[picture p3: page 13]
___ NAME; Project Setup; Security Form; Risk Assessment; Determine Direction; Market Research; Conduct Interviews; Analyse Interviews; Collate Interviews; Competitor Review; + Add task; Aug; Sep; Oct; Nov; E. Gantt Charts

All Gantts as of 07-12-20

All Forms Complete

NA All Forms Complete

Project Plan (Gantt)

NA Project Plan (Gantt)

NA Security Form

NA Risk Assessment

NA Determine Direction

NA Conduct Interviews

Initial Lit Review

NA Collate Interviews

NA Competitor Review

Initial Project Concept Subm…

NA Initial Project Concept Submitted

Add to Engineering Projec…

NA Add to Engineering Project Database

Project Setup Admin

Contact Technicians RE: L…

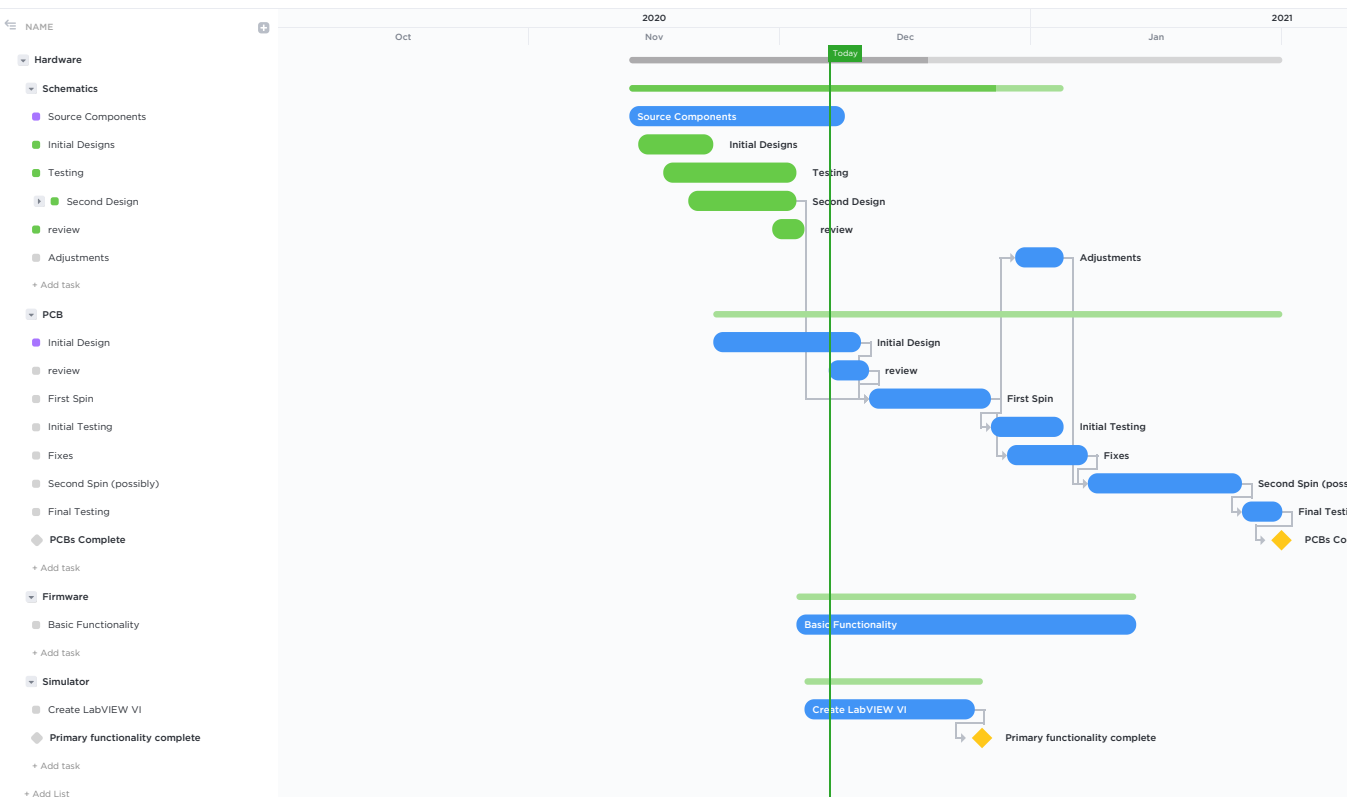
[picture p4: page 14]
___ NAME; Hardware; Schematics; Source Components; Initial Designs; Testing; Second Design; review; Adjustments; + Add task; PCB; Initial Design; First Spin; Initial Testing; Fixes; Final Testing; PCBs Complete; Firmware; Basic Functionality; Simulator; + Add List; Oct; Nov; Dec; Jan; Final Testi; PCBs Co; Today

Second Spin (possibly)

Second Spin (poss

Create LabVIEW VI

Primary functionality complete

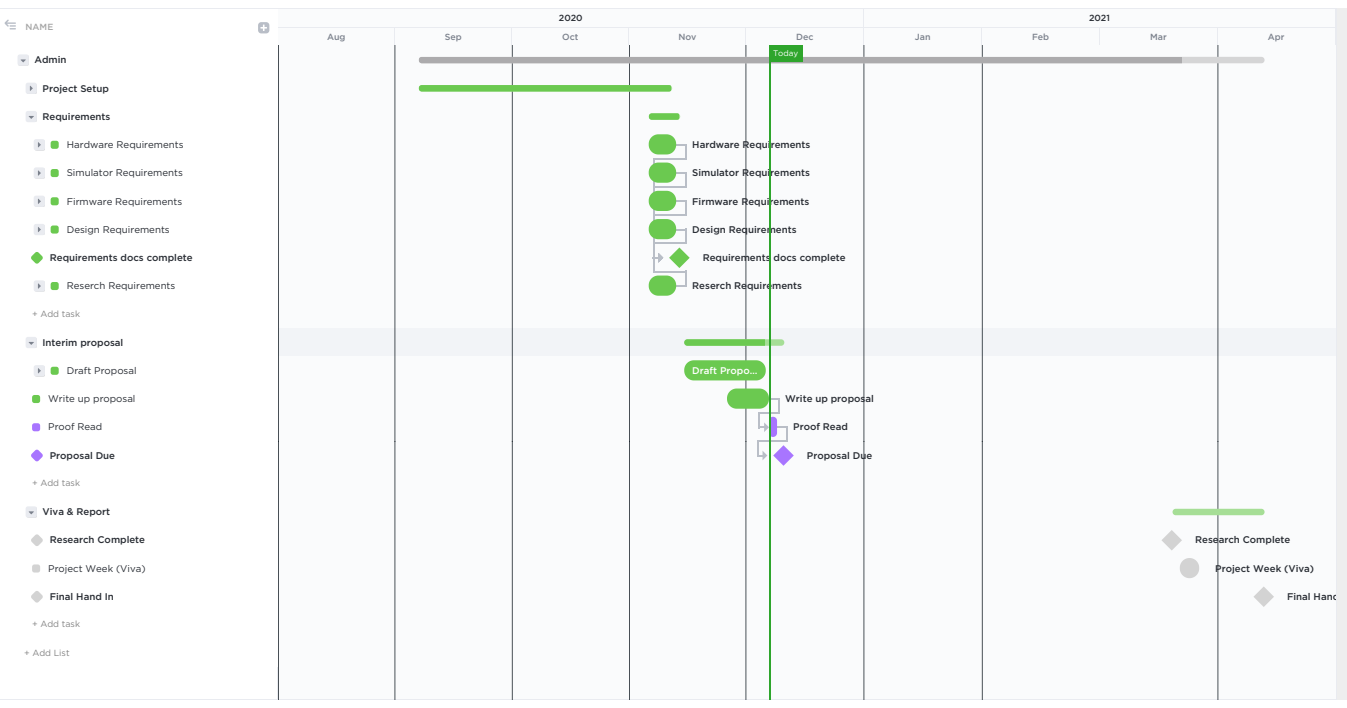
[picture p5: page 15]
___ NAME; Admin; Project Setup; Requirements; Hardware Requirements; Simulator Requirements; Firmware Requirements; Design Requirements; Reserch Requirements; + Add task; Interim proposal; Draft Proposal; Proof Read; Proposal Due; Viva & Report; Research Complete; + Add List; Aug; Sep; Oct; Nov; Dec; Jan; Feb; Mar; Apr; Draft Propo…; Final Hand; Today

Requirements docs complete

Write up proposal

Project Week (Viva)

Final Hand In

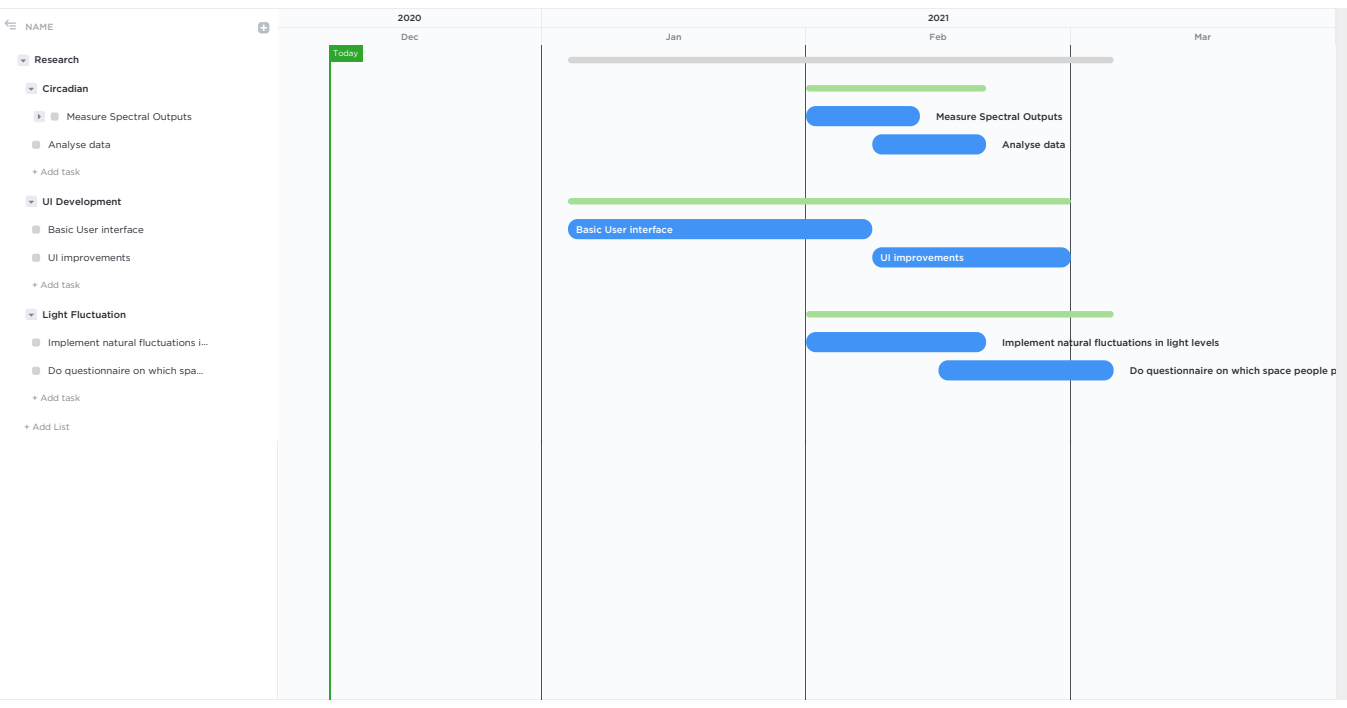
[picture p6: page 16]
___ NAME; Research; Circadian; Analyse data; + Add task; UI Development; UI improvements; Light Fluctuation; + Add List; Dec; Jan; Feb; Mar; Today

Measure Spectral Outputs

Basic User interface

Implement natural fluctuations i…

Implement natural fluctuations in light levels

Do questionnaire on which spa…

Do questionnaire on which space people p
