appletonN/FYP/documents/Final Report/Appendicies.tex

\clearpage
\newpage

\printbibliography[title={References},category=cited, heading=bibintoc]% default title for `article` class: "References"

\printbibliography[notcategory=cited, heading=bibintoc]

\clearpage

\printnoidxglossaries

\appendix

\chapter{Project Documents}
\label{App:Docs}

\clearpage

\section{Device Requirements}
\label{App:Req}

\includepdf[angle=90, width=.75\textheight, offset=0 -2cm]{PDFs/requirements.pdf}

\section{Gantt Charts}
\label{App:Gantt}

\subsection{Nov $15^{th}$ 2020 (initial)}
\label{App:initialGantt}

\includepdfmerge[nup=2x2]{PDFs/Gantts/nov15/ProjectSetup.pdf, PDFs/Gantts/nov15/Documents.pdf, PDFs/Gantts/nov15/Hardware.pdf, PDFs/Gantts/nov15/Research.pdf}

\subsection{Dec $12^{th}$ 2020}

\includepdfmerge[nup=2x2]{PDFs/Gantts/dec12/Setup.pdf, PDFs/Gantts/dec12/Docs.pdf, PDFs/Gantts/dec12/Hardware.pdf, PDFs/Gantts/dec12/Research.pdf}

\subsection{Jan $26^{th}$ 2021}

\includepdfmerge[nup=2x2]{PDFs/Gantts/jan26/Admin.pdf, PDFs/Gantts/jan26/Hardware.pdf, PDFs/Gantts/jan26/Hardware(upcoming).pdf, PDFs/Gantts/jan26/Research.pdf}

\subsection{Feb $17^{th}$ 2021}

\includepdfmerge[nup=2x2]{PDFs/Gantts/feb17/Admin.pdf, PDFs/Gantts/feb17/Hardware.pdf, PDFs/Gantts/feb17/Research.pdf}

\subsection{Apr $2^{nd}$ 2021}

\includepdfmerge[nup=2x2]{PDFs/Gantts/apr2/Admin.pdf, PDFs/Gantts/apr2/Hardware.pdf, PDFs/Gantts/apr2/Research.pdf}

\section{Risk Assessment}
\label{App:Risk}

\includepdf[width=.75\textheight, offset=0 -2cm]{PDFs/RiskAssessment.pdf}

\section{Resources}
\label{App:Resources}

\includepdf[width=.75\textheight, offset=0 -2cm]{PDFs/resources.pdf}

\section{Security}
\label{App:Security}

\includepdf[width=.75\textheight, offset=0 -2cm]{PDFs/security.pdf}

\section{Interview Documents}
\label{App:Consent}

\includepdf[page=-,nup=2x2]{PDFs/Consent.pdf}

% ----------------------

\chapter{Electronic Designs}
\label{App:Electronics}

\section{schematics}

\includepdf[pages=-, nup=1x2, scale=0.8, offset=0 -2cm]{PDFs/sch.pdf}

\section{\acrshort{pcbs}}

\includepdfmerge[nup=1x2]{PDFs/front.pdf, PDFs/back.pdf}

% ----------------------

\chapter{LabVIEW Code}
\label{App:VI}

\clearpage

\section{Simulator}
\label{App:Sim}

\includepdf[pages=2, offset=0 -2cm, scale = 0.8]{PDFs/VI1.pdf}

\includepdfmerge[pages=-, nup=2x1, offset=0 -2cm]{PDFs/VI2.pdf, PDFs/VI3.pdf}

\section{Spectrum Extractor}
\label{App:Analyse}

\includepdf[pages=-, offset=0 -2cm]{PDFs/VI4.pdf}

% ----------------------

\chapter{Results}

\clearpage

\section{Spectral Comparisons}
\label{App:Comp}

\begin{figure}[hbt]
\centering
\begin{subfigure}[h]{0.4\textwidth}
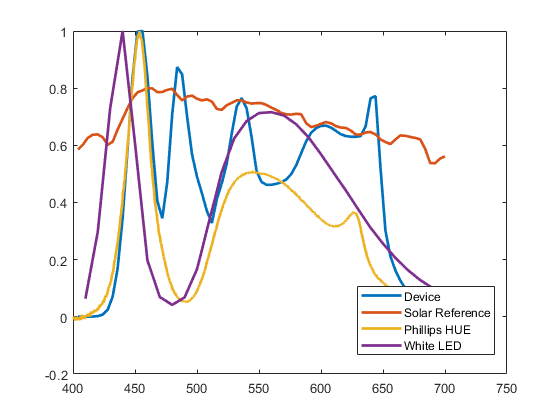
[picture p7: documents/Final Report/Images/Spectra/Morning.png]
	
	\caption{Morning Spectrum}
\end{subfigure}
\begin{subfigure}[h]{0.4\textwidth}
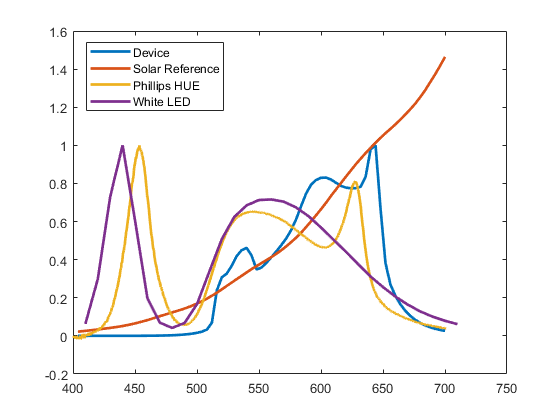
[picture p8: documents/Final Report/Images/Spectra/Afternoon.png]
	
	\caption{Afternoon Spectrum}
\end{subfigure}

\begin{subfigure}[h]{0.4\textwidth}
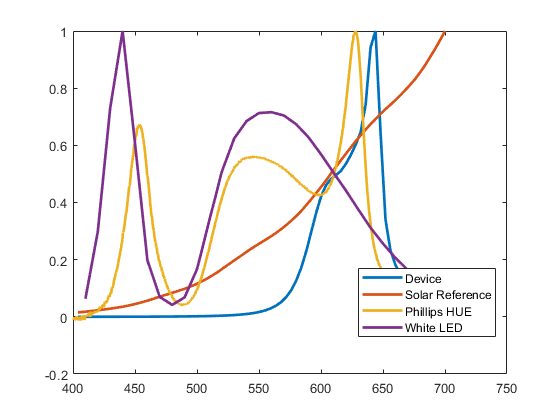
[picture p9: documents/Final Report/Images/Spectra/Evening.png]
	
	\caption{Evening Spectrum}
\end{subfigure}
\begin{subfigure}[h]{0.4\textwidth}
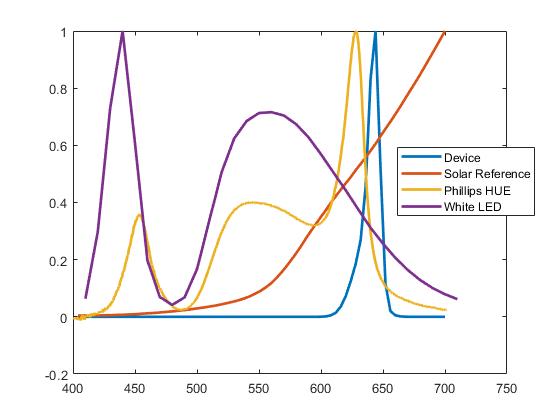
[picture p10: documents/Final Report/Images/Spectra/Night.png]
	
	\caption{Night Spectrum}
\end{subfigure}
\caption{The 4 collections of spectra: one for each time of day. }
\label{Fig:Spectra}
\end{figure}
\clearpage

\onecolumn
\begin{landscape}\small
\section{Data Used}

\begin{longtable}{c||c|c|c|c|c|c|c|c|c|c}
    \centering
    \multirow{2}{*}{Wavelength} & \multicolumn{4}{l}{Device} & \multicolumn{4}{l}{Philips HUE} & \multicolumn{2}{l}{Other} \\ \cline{2-11}
        	& morning & afternoon & evening & night & morning & afternoon & evening & night & CFL & LED \\ \hline\hline
        400 & 1.50E-03 & 7.00E-04 & 7.00E-04 & 0.00E+00 & -6.14E-04 & -3.86E-04 & -8.47E-04 & -9.18E-04 & 2.20E-03 & 4.47E-04 \\ \hline 
        404 & 2.00E-03 & 7.00E-04 & 7.00E-04 & 0.00E+00 & 1.39E-03 & 1.07E-03 & 6.96E-04 & 5.66E-04 & 1.29E-03 & 5.78E-04 \\ \hline
        408 & 2.90E-03 & 8.00E-04 & 8.00E-04 & 0.00E+00 & 3.03E-03 & 2.13E-03 & 1.83E-03 & 1.28E-03 & 2.89E-04 & 8.69E-04 \\ \hline
        412 & 5.40E-03 & 9.00E-04 & 9.00E-04 & 0.00E+00 & 6.48E-03 & 5.49E-03 & 4.97E-03 & 3.39E-03 & 1.89E-04 & 1.35E-03 \\ \hline
        416 & 1.43E-02 & 9.00E-04 & 9.00E-04 & 0.00E+00 & 1.05E-02 & 8.51E-03 & 7.30E-03 & 5.02E-03 & 1.68E-04 & 2.21E-03 \\ \hline
        420 & 4.60E-02 & 1.00E-03 & 1.00E-03 & 0.00E+00 & 1.77E-02 & 1.39E-02 & 1.10E-02 & 7.22E-03 & 1.50E-04 & 3.61E-03 \\ \hline
        424 & 1.46E-01 & 1.10E-03 & 1.10E-03 & 0.00E+00 & 3.10E-02 & 2.43E-02 & 1.93E-02 & 1.26E-02 & 3.12E-04 & 5.93E-03 \\ \hline
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
        696 & 5.54E-01 & 1.42E+00 & 9.68E-01 & 9.69E-01 \\ \hline
        700 & 5.61E-01 & 1.46E+00 & 1.00E+00 & 1.00E+00 \\
\end{longtable}

\twocolumn

\chapter{UK-SPEC}
\clearpage
\includepdf[scale=1.1, landscape=true]{PDFs/UK-SPEC.pdf}
