appletonN/FYP/documents/Final Report/main.tex

%----------------------------------------------------------------------------------------
%	PACKAGES AND OTHER DOCUMENT CONFIGURATIONS
%----------------------------------------------------------------------------------------

\documentclass[twoside,twocolumn]{report}

\usepackage{blindtext} % Package to generate dummy text throughout this template 

\usepackage[sc]{mathpazo} % Use the Palatino font
\usepackage[T1]{fontenc} % Use 8-bit encoding that has 256 glyphs
\linespread{1.05} % Line spacing - Palatino needs more space between lines
\usepackage{microtype} % Slightly tweak font spacing for aesthetics

\usepackage[english]{babel} % Language hyphenation and typographical rules

\usepackage[hmarginratio=1:1,top=32mm,columnsep=20pt]{geometry} % Document margins
\usepackage[hang, small,labelfont=bf,up,textfont=it,up]{caption} % Custom captions under/above floats in tables or figures
\usepackage{booktabs} % Horizontal rules in tables

\usepackage{lettrine} % The lettrine is the first enlarged letter at the beginning of the text

\usepackage{enumitem} % Customized lists
\setlist[itemize]{noitemsep} % Make itemize lists more compact

\usepackage{titlesec} % Allows customization of titles
%\renewcommand\thesection{\Roman{section}} % Roman numerals for the sections
%\renewcommand\thesubsection{\roman{subsection}} % roman numerals for subsections
\titleformat{\section}[block]{\large\scshape\centering}{\thesection.}{1em}{} % Change the look of the section titles
\titleformat{\subsection}[block]{\large}{\thesubsection.}{1em}{} % Change the look of the section titles

\usepackage{fancyhdr} % Headers and footers
\pagestyle{fancy} % All pages have headers and footers
\fancyhead{} % Blank out the default header
\fancyfoot{} % Blank out the default footer
\fancyhead[C]{\today $\bullet$ Parting the Clouds $\bullet$ 16019243} % Custom header text
\fancyfoot[RO,LE]{\thepage} % Custom footer text

\usepackage{titling} % Customizing the title section

\usepackage{pdflscape}

\usepackage{hyperref} % For hyperlinks in the PDF

\usepackage{pdfpages}

\usepackage{csquotes}

\usepackage{caption}
\usepackage{subcaption}

\usepackage[backend=biber, style=authoryear, maxnames=999, maxcitenames=3, urldate=long, natbib=true]{biblatex}
%\DeclareNameAlias{sortname}{last-first}
\DeclareFieldFormat{edition}{%
  \ifinteger{#1}
    {\ifnumequal{#1}{1}%
     {}%
     {\mkbibordedition{#1}~\bibstring{edition}}%
    }
    {#1\isdot}}

\DeclareFieldFormat[article,inbook,incollection]{title}{#1\isdot}
\DeclareFieldFormat[article,inbook,incollection]{citetitle}{#1\isdot}

\newrobustcmd{\MakeTitleCase}[1]{%
  \ifboolexpr{test {\ifentrytype{article}} or test {\ifentrytype{inbook}} or test {\ifentrytype{incollection}}}
    {#1}
    {\MakeSentenceCase{#1}}}

\DeclareFieldFormat{urldate}{\bibsentence\mkbibbrackets{\bibstring{urlseen}\space#1}}
\DeclareFieldFormat{url}{\bibstring{urlfrom}\addcolon\space\url{#1}}

\renewbibmacro*{volume+number+eid}{%
  \printfield{volume}%
%  \setunit*{\adddot}% DELETED
  \setunit*{\addnbspace}% NEW (optional); there's also \addnbthinspace
  \printfield{number}%
  \setunit{\addcomma\space}%
  \printfield{eid}}
\DeclareFieldFormat[article]{number}{\mkbibparens{#1}}

\renewbibmacro*{journal}{%
  \iffieldundef{journaltitle}
    {}
    {\printtext[journaltitle]{%
       \printfield[titlecase]{journaltitle}%
       \setunit{\subtitlepunct}%
       \printfield[titlecase]{journalsubtitle}}
       \ifboolexpr{
         not test {\iffieldundef{url}}
         or
         not test {\iffieldundef{urldate}}
         or
         not test {\iffieldundef{doi}}
         or
         not test {\iffieldundef{eprint}}
       }
         {\nopunct\bibstring[\mkbibbrackets]{online}}%
         {}}}

\renewbibmacro*{journal+issuetitle}{%
  \usebibmacro{journal}%
  \setunit*{\addspace}%
  \iffieldundef{series}
    {}
    {\newunit
     \printfield{series}%
     \setunit{\addspace}}%
  \newunit
  \usebibmacro{volume+number+eid}%
  \setunit{\addspace}%
  \usebibmacro{issue+date}%
  \setunit{\addcolon\space}%
  \usebibmacro{issue}%
  \newunit}

\NewBibliographyString{online}
\DefineBibliographyStrings{english}{%
  urlseen    = {accessed},
  online     = {online},
}
%\addbibresource{example.bib}
\renewcommand*{\nameyeardelim}{\addcomma\addspace}
\renewbibmacro{in:}{%
  \ifentrytype{article}{}{\printtext{\bibstring{in}\intitlepunct}}} % removes "In" preceding journal title

%\section*{Bibliography}
%\bibliography{biblio.bib}
%\end{document}

\DeclareBibliographyCategory{cited}
\AtEveryCitekey{\addtocategory{cited}{\thefield{entrykey}}}

\addbibresource{FYP.bib}
\nocite{*}

\newcommand{\citefirstlastauthor}{\AtNextCite{\DeclareNameAlias{labelname}{given-family}}\citeauthor}

\usepackage{multirow}

\linespread{1.25}

%----------------------------------------------------------------------------------------
%	TITLE SECTION
%----------------------------------------------------------------------------------------

\input{Gloss}

\begin{document}

\pagenumbering{roman}

\begin{titlepage}

    \begin{center}
        \vspace*{1cm}
            
        \Huge
        \textbf{Parting the Clouds: Moving Towards an Affordable Natural-Lighting Solution}
            
        \vspace{0.5cm}
        \LARGE
        16019243
            
        \vspace{1.5cm}
            
        \textbf{N. Appleton}
        
        \vspace{0.5cm}
        Supervisor: Matthew Studley
        
        BEng Robotics
            
        \vfill
            
        Designing a modular, human-centric lighting system   
        
        \pageref{Lastpage} pages; 
        \input{WordCount.sum}words \\ (main text only)
            
        \vspace{0.8cm}
            
        \Large
        Faculty of Environment and Technology\\
        UWE\\
        UFMFX8-30-3 \\
        \today
            
    \end{center}
\end{titlepage}

\begin{titlepage}
\centering
~
\vfill

\textbf{Disclaimer:}

All of the work contained in this document is solely the work of N. Appleton.

\vfill
~ \vfill
\end{titlepage}

\setcounter{tocdepth}{1}
\tableofcontents 
\clearpage \newpage

%----------------------------------------------------------------------------------------

%----------------------------------------------------------------------------------------
%	ARTICLE CONTENTS
%----------------------------------------------------------------------------------------
\pagenumbering{arabic}

\input{Intro}

\input{LitReview}

\input{Method}

\input{Results}

\input{Analysis}

%----------------------------------------------------------------------------------------
\label{Lastpage}

\input{Appendicies}

\end{document}
