appletonN/FYP/documents/Final Report/PDFs/VI4.pdf

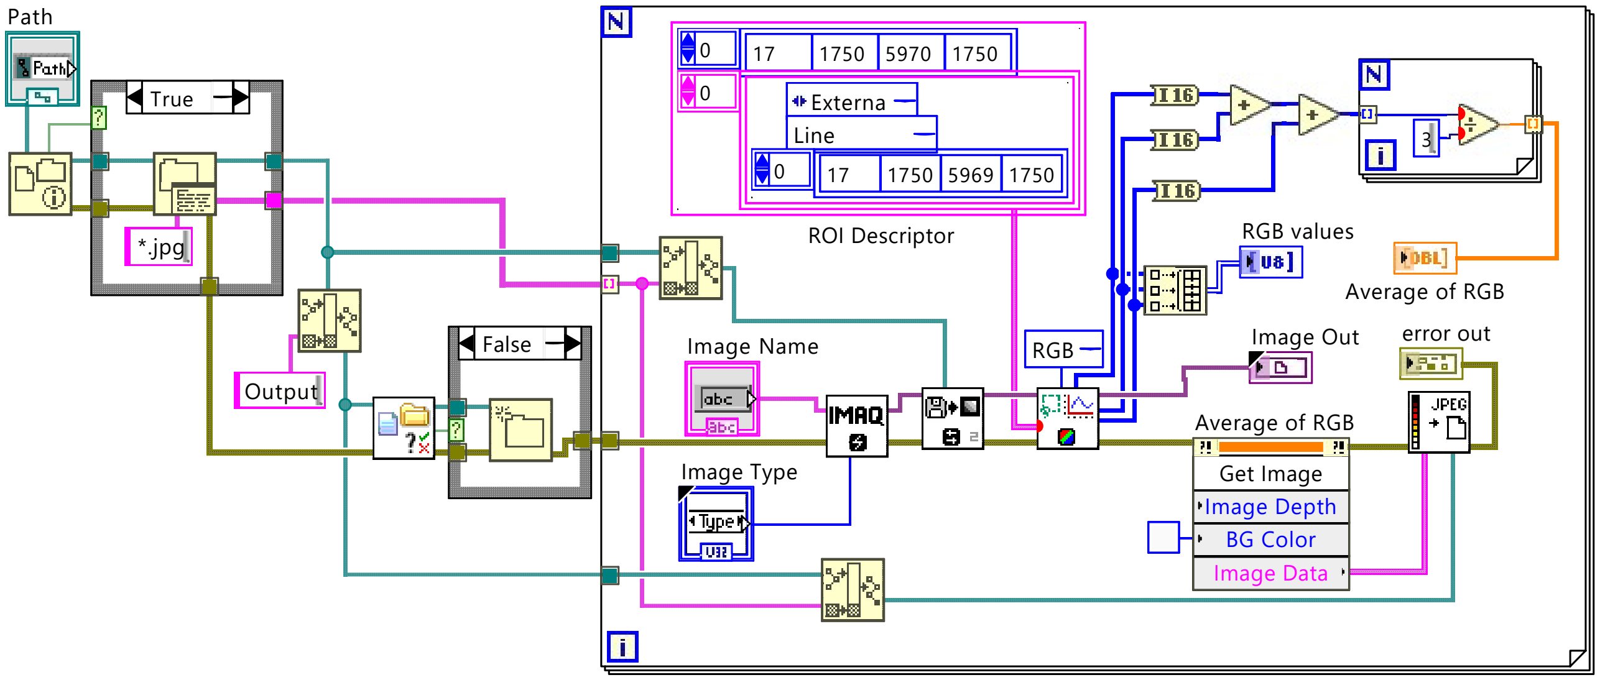
[picture p18: figure]
Path; Externa Line; ROI Descriptor; error out; RGB values; Image Out Image Name; RGB; Image Type; Average of RGB; Image Data; BG Color; Image Depth; Get Image; Output; False; *.jpg; True
