appletonN/FYP/documents/Interim Proposal/Interim Research Proposal Marking Scheme-2021(3).xlsx

Sheet: IRP Marking Scheme
 | Individual Engineering Project |  |  | Module Code: |  |  |  |  | UG | X8: UFMFX8-30-3 BEng /BSc
 | INTERIM REPORT PROPOSAL (Component B1) |  |  |  |  |  |  |  |  | Y8: UFMFY8-30-3 MEng A
 | Student Number: |  |  | Supervisor:
 | Student Name:
 | Project Title:
 |  |  | Supervisors; for each section, in the Mark (%) column, enter your mark out of 100. The Weighted Mark column will adjust accordingly and your mark at the bottom will be out of 100.
1 | Project Goals (15%) |  | Goals ill-defined | 0 | 10 | 20 | 30 | 40 | 50 | 60 | 70 | 80 | 90 | 100 | Clear statement of project goals | Mark (%) | Weighted Mark
15% | Module Learning Outcome: LO1 Identify the main issues to be examined and the problems to be solved in the execution of an engineering-discipline-related technical project | * Aims: Clear aims identified * Objectives: Explain how you will achieve your aims * Reason for the project: Justify the project * Scope: Meets learning outcomes of discipline/degree * Research questions: Identify those specific to the project |  |  |  |  |  |  |  |  |  |  |  |  |  | 100.0 | 15
2 | Required Forms (10%) |  | No forms submitted | 0 | 10 | 20 | 30 | 40 | 50 | 60 | 70 | 80 | 90 | 100 | High quality and relevant information provided | Mark (%) | Weighted Mark
10% | Module Learning Outcome: LO2 Undertake management of technical projects | * Gantt Chart * Resource form * Ethics checklist (completed online) * Risk Assessment Form * Security Form |  |  |  |  |  |  |  |  |  |  |  |  |  | 100.0 | 10
3 | Project Management / Planning / Methodology (25%) |  | No evidence | 0 | 10 | 20 | 30 | 40 | 50 | 60 | 70 | 80 | 90 | 100 | Careful consideration to all aspects | Mark (%) | Weighted Mark
25% | Module Learning Outcome: LO2 Undertake management of technical projects | * Relevant methods developed based on proposed research questions * Methods Approach (e.g. quantitative/qualitative) * Timescales * Resources, the environment and sustainability * Risk management and mitigation (e.g. pandemic contingencies) * Ethical implications addressed * Limitations addressed |  |  |  |  |  |  |  |  |  |  |  |  |  | 100.0 | 25
4 | Research / Literature Review (20%) |  | No knowledge of previous work | 0 | 10 | 20 | 30 | 40 | 50 | 60 | 70 | 80 | 90 | 100 | Comprehensive summary of prior work and literature | Mark (%) | Weighted Mark
20% | Module Learning Outcome: LO2 Select appropriate knowledge sources to guide execution | * Subject background summarised through literature * Expanded knowledge of topic demonstrated * Identify gaps in knowledge where relevant * Project in relation to state of the art |  |  |  |  |  |  |  |  |  |  |  |  |  | 100.0 | 20
5 | References / Citations (10%) |  | No evidence of referencing or citations | 0 | 10 | 20 | 30 | 40 | 50 | 60 | 70 | 80 | 90 | 100 | Citations throughout. Accurately presented, thorough reference list. | Mark (%) | Weighted Mark
10% | Module Learning Outcome: LO2 Select appropriate knowledge sources to guide execution | * Comprehensive reference list * All references accurately presented in UWE Harvard style * Rich source of references (i.e. journals, books) * Citations correctly positioned in body of text * Where appropriate Bibliography list after references |  |  |  |  |  |  |  |  |  |  |  |  |  | 100.0 | 10
6 | Activities undertaken so far (20%) |  | No evidence of any work to date | 0 | 10 | 20 | 30 | 40 | 50 | 60 | 70 | 80 | 90 | 100 | Project work under way. Logbook up to date and shared | Mark (%) | Weighted Mark
20% | Module Learning Outcome: LO3 Demonstrating initial design, experimentation, analysis and progress | * Describe the activities undertaken to date * Demonstrate that the project has commenced and work is ongoing * Has logbook been used and shown to supervisor? Does it illustrate project progress to date? |  |  |  |  |  |  |  |  |  |  |  |  |  | 100.0 | 20
 |  |  |  |  |  |  |  |  |  |  | Interim Report Mark |  |  |  |  | 100 |  | %

Sheet: Guidance
 | Guidance: Interim Research Proposal
 | Proposal Format: | A4, Double-sided, font: Tahoma 11 point, Space 1.15
 |  | The interim submission on 10th December is expected to be between 3 - 6 pages (sides) in total length.
 |  | Remember: this is just a short report and so the requested information only needs to be touched upon briefly.
 | Module Learning Outcomes | Required | Expectation within Submission | Advice/tips/suggestions
PROJECT GOALS | LO1 - Identify the main issues to be examined and the problems to be solved in the execution of an engineering-discipline-related technical project (15%) | Aims | Clear aims | Identify the project
 |  | Objectives | Explain how you will achieve your aims | Identify a list of steps you need to take to reach the goal
 |  | Reason for the project | Justify the project | Explain your motivation for the project, justify it and its potential impact and value within society, including environmental and ethical considerations, sustainable development goals (SDGs)
 |  | Scope | Ensure project meets learning outcomes of discipline / degree programme | Ensure relevance of your project within your discipline - do not be too ambitious or too restrictive
 |  | Proposed research questions | Identify the proposed questions relating to the project | A short section identifying the proposed questions within the project remit
REQUIRED FORMS | LO2 - Undertake management of technical projects (10%) | Required Forms | - Gantt Chart - Ethics Checklist and discussion - Resource Requirements - Risk Assessment Form - Security Form | - Your project Plan from initiation to completion. Marks are awarded relating quality and relevance of information. - The ethics checklist should have been completed online (check with your supervisor), also discuss the implications of ethics for projects (see next section). - Resources needed: lab time, equipment, technical support, costs - Risk Assessment Form: identification (product, process or technology), analysis, prioritisation, mitigation. Risk can also be to project success i.e. competing deadlines - Security and responsibility issues of the project
PROJECT MANAGEMENT PLANNING METHODOLOGY | LO2 - Undertake management of technical projects (25%) | Project Management / Planning / Methodology | Turning research questions into methods required for data collection and analysis | Explain your assumptions to develop the research questions that address a particular gap, and advance your knowledge in that field. Identify the activities you need to do to answer the research question(s) you have proposed - use your Gantt Chart to help you
 |  |  | Designing of research: methods of data collection | Based on what has been learnt from the literature review and nature of the research, identify the methods of investigation for your project
 |  |  | Approach | Qualitative, Quantitative, Combination
 |  |  | Timescales | Refer to your Gantt Chart
 |  |  | Resources required | Explain resource requirements - this may be covered in your justification section (as above)
 |  |  | Risk Assessment and mitigation | Explain your assessment's conclusions. Discuss the contingencies in place for unexpected pandemic induced scenarios.
 |  |  | Environment and Sustainability | Paragraph explaining use of information, equipment and materials Potential impact of project, e.g. materials, obsolescence
 |  |  | Ethical implications | Discuss the implications of ethics for projects
 |  |  | Limitations | Specific to each individual student: time, budget, facilities, access to preferred samples, of researcher (e.g. language), new knowledge and skill development, etc.
RESEARCH LITERATURE REVIEW | LO2 - Select appropriate knowledge sources to guide execution (20%) | Research / Literature Review | Summarise/introduce background to the project using literature. | A section showing you have expanded your knowledge of the topic and/or the existing hypotheses in the field, and your own key learning obtained from your literature review/research. This will help you identify the gaps in your existing knowledge. Ensure you cite relevant literature - seek guidance from your supervisor if you are unsure where to start
REFERENCES / CITATIONS | LO2 - Select appropriate knowledge sources to guide execution (10%) | References Citations | Reference all literature you cite within the body of the research proposal | Ensure these are referenced correctly at the end of the document: UWE Harvard References do count within the page count. Don't ever use your University notes or Wikipedia as references - only use the latter to identify potential sources.
 |  | Bibliography | Identify sources you have read to develop your background knowledge, but which are not cited within the body of the proposal. | Bibliography do not count under page count. However, keep this to a maximum of a couple of pages: so an indicative list Use Wikipedia to direct you to academic and other relevant sources - but don't reference it directly.
ACTIVITIES UNDERTAKEN TO DATE | LO3 - demonstrating initial design, experimentation, analysis and progress (20%) | Description of activities undertaken so far | - Showing that the project has commenced and work is on-going. - Use of the logbook to discuss activities and demonstrate progress to date | Ensure your logbook is up to date, including any thoughts you have had, any discussions with supervisor and technicians, etc. Brief description of progress to project plan - show you have thought ahead, mitigated for your risks and have definitely started the work.

Sheet: Supporting activities
Research Proposal Guidance
Use this information to help you understand about how to conduct research.
Useful Links to Support your Learning
Recommended Supporting Activities | Links to helpful Library courses to prepare for the project process. [These courses are for guidance only, so do NOT count within your module marks]
* Research Design – Research skills support is available through the UWE Library Services. * Develop Project Aims – Useful tips and examples of developing your project hypothesis is available at the UWE Research Repository. * Effective Communication and Report Writing Skills – Planning, writing and editing support is available through the UWE Library Services: complete the "Improving your writing" activity. | UWE Library Services (http://www1.uwe.ac.uk/students/studysupport/studyskills/readingandwriting/writing.aspx)
 | "Improving your writing" activity (http://www.skills4studycampus.com/studentcontent.aspx?Section=18)
* Ensure you use all the information available to you on Blackboard/myUWE. * Your Interim Research Proposal submission allows you to identify how you are managing your project, so you need to ensure you keep thorough records as part of this process. These records, regularly updated, are key to managing a project and to identifying what you are learning as you do your project. | Blackboard Resources (https://blackboard.uwe.ac.uk/webapps/blackboard/content/listContentEditable.jsp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)
* Literature Survey – Research skills support is available through the UWE Library Services. * Complete the UWE Library's "conducting your research" activity. * Referencing – Ensure you read and understand the UWE Harvard referencing guide. * Complete the "referencing" activity. | UWE Library Services (http://www1.uwe.ac.uk/students/studysupport/studyskills/readingandwriting/writing.aspx)
 | UWE Harvard Referencing Guide (http://www1.uwe.ac.uk/students/studysupport/studyskills/referencing/introduction.aspx)
 | referencing module assessment (http://www.skills4studycampus.com/OrgLogin.aspx)
* Project Planning - Develop a Gantt Chart estimating the time required to complete different aspects of your project as well as project milestones. Although most Gantt charts are done in Excel, you may wish to use Microsoft Project: a tutorial developing gantt charts is available on-line. * Your "Experiment Design" requires all the information needed to allow the project activity to happen to plan: Concept, Equipment and Materials Design, Physical experiment requirements, Methodology | :
 | Gantt Chart Tutorial (https://support.office.com/en-gb/article/Basic-tasks-in-Project-8fdbf020-a9e1-45e4-bf15-23a8d2b6797d)
* Validation of Results - Useful tips and examples of how to you can analyse and validate your results is available at the UWE Research Repository. * Reporting your Findings - Research skills support is available through the UWE Library Services. * Complete the "how to report your research findings" activity.
 | UWE Library Services (http://www1.uwe.ac.uk/students/studysupport/studyskills/readingandwriting/writing.aspx)
For those of you planning to study at Level M, or simply to stretch yourselves further, consider: | conducting your research module assessment (http://www.skills4studycampus.com/OrgLogin.aspx)
 | how to report your research findings module (http://www.skills4studycampus.com/OrgLogin.aspx)
