appletonN/FYP/documents/Final Report/Documents/Final Report Marking Criteria 20-21(2).xlsx

Sheet: Marking Scheme
 | Individual Engineering Project |  |  | Module Code: |  |  | a |  | UG | X8: UFMFX8-30-3 BEng
 | COMPONENT B MARKING SCHEME |  |  |  |  |  |  |  |  | Y8: UFMFY8-30-3 MEng A
 | FINAL REPORT / DISSERTATION |  |  |  |  |  |  |  | PG | RY: UFMERY-30-M MEng B
 | Student Number: | b
 | Student Name: | c
 | Project Title: | d
 | PROJECT FINAL REPORT / DISSERTATION:
 | First Reader (Normally the Supervisor): | e
* Note: All points in red are suggestions for projects that have been restricted by the Pandemic. If students have been affected please see the 'Final Report Guidance 2021' document (section 9)
 | Markers: for each section, in the 'Element Mark %' column, enter your mark out of 100. The Weighted Mark column will adjust accordingly and your mark at the bottom will be out of 100.
1 | Aims and Objectives (5%) | Aims and objectives ill-defined | 0 | 10 | 20 | 30 | 40 | 50 | 60 | 70 | 80 | 90 | 100 | Clear statement of project goals | Element Mark % | Weighted Mark
 | * Identify relevant investigation / research topic * Realistic and challenging aims and objectives identified * Identification of depth and breadth of the project * Level of Technical Difficulty in Investigation (scope) * Discuss any changes enforced by the Pandemic | f |  |  |  |  |  |  |  |  |  |  |  |  | 55.0 | 2.75
2 | Project Management (10%) | Unable to work on own initiative, little effort | 0 | 10 | 20 | 30 | 40 | 50 | 60 | 70 | 80 | 90 | 100 | High motivation. Much effort | Element Mark % | Weighted Mark
 | * Evidence that student has led their own project (self-direction) * Evidence of project planning and appropriate use of supervision * Adherence to review and meeting dates, and all time constraints * Risk awareness and mitigation * Control of projects - resources, communication, demonstrated through regular interaction with UK-SPEC via logbook, etc. * Evidence that contingencies incorporated in attempt to address Pandemic * If project affected by Covid limitations, how did student adapt? | g |  |  |  |  |  |  |  |  |  |  |  |  | 68.0 | 6.8
3 | Context to the Work (10%) | No knowledge of previous work | 0 | 10 | 20 | 30 | 40 | 50 | 60 | 70 | 80 | 90 | 100 | In-depth under-standing of prior work and literature | Element Mark % | Weighted Mark
 | * Background literature review and research (breadth and depth) * Interpretation of previous work in the topic * Critical discussion of relevant published work * If required, suitable contact with outside bodies; e.g. data providers, sponsoring companies, etc (primary research) | h |  |  |  |  |  |  |  |  |  |  |  |  | 85.0 | 8.5
4 | Research Methodology (10%) | Little or no framework or research methodology is identified, explained and justified | 0 | 10 | 20 | 30 | 40 | 50 | 60 | 70 | 80 | 90 | 100 | Well-defined and justified research methodology, and related approach to conducting the research, data collection and analysis | Element Mark % | Weighted Mark
 | * Appropriate selection of research methods demonstrating an understanding of alternative approaches * Relevant technical depth and breadth * Identification, use and justification of appropriate techniques to gather and analyse data * Limitations: Ethical, Environmental, Financial, Time, Policies and Human Resources * How methodology and methods were adapted to ensure completion during Pandemic? | i |  |  |  |  |  |  |  |  |  |  |  |  | 70.0 | 7
5 | Results - Technical Content (15%) | Haphazard, unstructured approach | 0 | 10 | 20 | 30 | 40 | 50 | 60 | 70 | 80 | 90 | 100 | Well-planned and managed, systematic approach | Element Mark % | Weighted Mark
 | * Data collection and analysis based on justified methodology * Evaluation and interpretation of discoveries * Presentation of predicted results (if impacted by Pandemic) * Evidence of adaptability in face of Pandemic | j |  |  |  |  |  |  |  |  |  |  |  |  | 70.0 | 10.5
6 | Analysis and Scientific Argument (15%) | Little evidence of engaging with data analysis | 0 | 10 | 20 | 30 | 40 | 50 | 60 | 70 | 80 | 90 | 100 | Fully engaged with analysis, value judgments made, with self-reflection | Element Mark % | Weighted Mark
 | * Development and Coherence of Arguments from the literature * Comparative analysis between project findings (or expected findings) and literature review * Development and quality of the scientific argument * Evidence of the ability to evaluate information and synthesise conclusions * Critical appraisal of the research methods used * Innovation style: problem solving, or step-by-step learning through established techniques *If appropriate discuss the results you expected (but were not able to collect because of Coronavirus restrictions) | k |  |  |  |  |  |  |  |  |  |  |  |  | 70.0 | 10.5
7 | Evaluation and Accomplishment (15%) | Little or no accomplishment achieved | 0 | 10 | 20 | 30 | 40 | 50 | 60 | 70 | 80 | 90 | 100 | Good accomplishment Includes reflection and consideration of further work | Element Mark % | Weighted Mark
 | * Critical appraisal and evaluation of the project and process * Reflection of self-development whilst conducting the project - reflection of problem solving skills (especially in relation to the Pandemic) * Achievements and shortcomings of the project in relation to explicit aims and other criteria as appropriate * Relating the project to UK-SPEC competencies, with discussion about wider social / industrial implications, such as ethics, environment, finance, etc. * Further research, development and recommendations * If Pandemic stalled progress provide a comprehensive section on the sustainability/ethical/system engineering elements of your work. * If appropriate discuss the conclusions you hoped to reach (but were prevented by Coronavirus restrictions) * Consider risk management in relation to past and present 'Force Majeure' events | l |  |  |  |  |  |  |  |  |  |  |  |  | 70.0 | 10.5
8 | Citation (10%) | Little or no attempt at academic citation | 0 | 10 | 20 | 30 | 40 | 50 | 60 | 70 | 80 | 90 | 100 | Excellent citation and related referencing and bibliogprahy | Element Mark % | Weighted Mark
 | * UWE Harvard Referencing style used * Accuracy, Consistency and Completeness * Listing of References located at the end of the report or chapters * Possible use of a Bibliography - understanding distinction between referencing and bibliography | m |  |  |  |  |  |  |  |  |  |  |  |  | 70.0 | 7
9 | Report Presentation (10%) | Unstructured poor layout, grammar, spelling | 0 | 10 | 20 | 30 | 40 | 50 | 60 | 70 | 80 | 90 | 100 | Well written, detailed, informative | Element Mark % | Weighted Mark
 | * Logical structure of report and clarity of presentation * Conformity to style and layout requirements * Quality of writing, spelling, grammar, diagrams, figures and tables * Clarity of Expression and use of English * Appropriateness of Style to Audience * Summary of UK-SPEC Competencies acquired during project | n |  |  |  |  |  |  |  |  |  |  |  |  | 70.0 | 7
 |  |  |  |  |  |  |  |  |  |  |  |  |  | TOTAL |  | 70.55
 | First Reader's Mark: | 70.5 | %
 | **********************************************************************************************************************************************************************************
 | Second Reader: | o
1 | Aims and Objectives (5%) | Aims and objectives ill-defined | 0 | 10 | 20 | 30 | 40 | 50 | 60 | 70 | 80 | 90 | 100 | Clear statement of project goals | Element Mark % | Weighted Mark
 | * Identify relevant investigation / research topic * Realistic and challenging aims and objectives identified * Identification of depth and breadth of the project * Level of Technical Difficulty in Investigation (scope) * Discuss any changes enforced by the Pandemic | p |  |  |  |  |  |  |  |  |  |  |  |  | 100.0 | 5
2 | Project Management (10%) | Unable to work on own initiative, little effort | 0 | 10 | 20 | 30 | 40 | 50 | 60 | 70 | 80 | 90 | 100 | High motivation. Much effort | Element Mark % | Weighted Mark
 | * Evidence that student has led their own project (self-direction) * Evidence of project planning and appropriate use of supervision * Adherence to review and meeting dates, and all time constraints * Risk awareness and mitigation * Control of projects - resources, communication, demonstrated through regular interaction with UK-SPEC via logbook, etc. * Evidence that contingencies incorporated in attempt to address Pandemic * If project affected by Covid limitations, how did student adapt? | q |  |  |  |  |  |  |  |  |  |  |  |  | 100.0 | 10
3 | Context to the Work (10%) | No knowledge of previous work | 0 | 10 | 20 | 30 | 40 | 50 | 60 | 70 | 80 | 90 | 100 | In-depth under-standing of prior work and literature | Element Mark % | Weighted Mark
 | * Background literature review and research (breadth and depth) * Interpretation of previous work in the topic * Critical discussion of relevant published work * If required, suitable contact with outside bodies; e.g. data providers, sponsoring companies, etc (primary research) | r |  |  |  |  |  |  |  |  |  |  |  |  | 100.0 | 10
4 | Research Methodology (10%) | Little or no framework or research methodology is identified, explained and justified | 0 | 10 | 20 | 30 | 40 | 50 | 60 | 70 | 80 | 90 | 100 | Well-defined and justified research methodology, and related approach to conducting the research, data collection and analysis | Element Mark % | Weighted Mark
 | * Appropriate selection of research methods demonstrating an understanding of alternative approaches * Relevant technical depth and breadth * Identification, use and justification of appropriate techniques to gather and analyse data * Limitations: Ethical, Environmental, Financial, Time, Policies and Human Resources * How methodology and methods were adapted to ensure completion during Pandemic? | s |  |  |  |  |  |  |  |  |  |  |  |  | 100.0 | 10
5 | Results - Technical Content (15%) | Haphazard, unstructured approach | 0 | 10 | 20 | 30 | 40 | 50 | 60 | 70 | 80 | 90 | 100 | Well-planned and managed, systematic approach | Element Mark % | Weighted Mark
 | * Data collection and analysis based on justified methodology * Evaluation and interpretation of discoveries * Presentation of predicted results (if impacted by Pandemic) * Evidence of adaptability in face of Pandemic | t |  |  |  |  |  |  |  |  |  |  |  |  | 100.0 | 15
6 | Analysis and Scientific Argument (15%) | Little evidence of engaging with data analysis | 0 | 10 | 20 | 30 | 40 | 50 | 60 | 70 | 80 | 90 | 100 | Fully engaged with analysis, value judgments made, with self-reflection | Element Mark % | Weighted Mark
 | * Development and Coherence of Arguments from the literature * Comparative analysis between project findings (or expected findings) and literature review * Development and quality of the scientific argument * Evidence of the ability to evaluate information and synthesise conclusions * Critical appraisal of the research methods used * Innovation style: problem solving, or step-by-step learning through established techniques *If appropriate discuss the results you expected (but were not able to collect because of Coronavirus restrictions) | u |  |  |  |  |  |  |  |  |  |  |  |  | 100.0 | 15
7 | Evaluation and Accomplishment (15%) | Little or no accomplishment achieved | 0 | 10 | 20 | 30 | 40 | 50 | 60 | 70 | 80 | 90 | 100 | Good accomplishment Includes reflection and consideration of further work | Element Mark % | Weighted Mark
 | * Critical appraisal and evaluation of the project and process * Reflection of self-development whilst conducting the project - reflection of problem solving skills (especially in relation to the Pandemic) * Achievements and shortcomings of the project in relation to explicit aims and other criteria as appropriate * Relating the project to UK-SPEC competencies, with discussion about wider social / industrial implications, such as ethics, environment, finance, etc. * Further research, development and recommendations * If Pandemic stalled progress provide a comprehensive section on the sustainability/ethical/system engineering elements of your work. * If appropriate discuss the conclusions you hoped to reach (but were prevented by Coronavirus restrictions) * Consider risk management in relation to past and present 'Force Majeure' events | v |  |  |  |  |  |  |  |  |  |  |  |  | 100.0 | 15
8 | Citation (10%) | Little or no attempt at academic citation | 0 | 10 | 20 | 30 | 40 | 50 | 60 | 70 | 80 | 90 | 100 | Excellent citation and related referencing and bibliogprahy | Element Mark % | Weighted Mark
 | * UWE Harvard Referencing style used * Accuracy, Consistency and Completeness * Listing of References located at the end of the report or chapters * Possible use of a Bibliography - understanding distinction between referencing and bibliography | w |  |  |  |  |  |  |  |  |  |  |  |  | 100.0 | 10
9 | Report Presentation (10%) | Unstructured poor layout, grammar, spelling | 0 | 10 | 20 | 30 | 40 | 50 | 60 | 70 | 80 | 90 | 100 | Well written, detailed, informative | Element Mark % | Weighted Mark
 | * Logical structure of report and clarity of presentation * Conformity to style and layout requirements * Quality of writing, spelling, grammar, diagrams, figures and tables * Clarity of Expression and use of English * Appropriateness of Style to Audience * Summary of UK-SPEC Competencies acquired during project | x |  |  |  |  |  |  |  |  |  |  |  |  | 100.0 | 10
 |  |  |  |  |  |  |  |  |  |  |  |  |  | TOTAL |  | 100
 | Overall Summary: * Strengths * Areas for Improvement | y
 | Second Reader's Mark: | 100.0 | %
 | Final Report Mark: |  | %
 | (1st / 2nd Readers’ agreed)
 | MUST BE COMPLETED BY SUPERVISOR Final Mark Resolution Rationale Only to be completed where: * 1st & 2nd marks are 5% or more apart * If 1st & 2nd mark are either side of a grade boundary * If the marks are more than 10% apart, a third marker is required, using the 2nd marker spreadsheet * If the 1st & 2nd Markers cannot agree, a 3rd Marker is required | y

Sheet: Student Feedback
 | INDIVIDUAL PROJECT MODULE - FINAL REPORT / DISSERTATION FEEDBACK PROFORMA
Module Code: | a
Student Number: | b
Student Name: | c
Project Title: | d
Supervisor / 1st Marker: | e
2nd Marker: | o
Final Report Feedback
Criterion | 1st Marker's Comments | 2nd Marker's Comments
Aims and Objectives | f | p
Project Management | g | q
Context to the Work | h | r
Research Methodology | i | s
Scientific Method - Technical Content | j | t
Scientific Argument | k | u
Evaluation and Accomplishment | l | v
Citation | m | w
Report Presentation | n | x
Overall Summary: * Strengths * Areas for Improvement | y

Sheet: Marking Range Guidance
Marking Guidance
 |  |  |  | Note: A mark of 80%+ implies the final report is of publishable standard
 |  |  |  | Ensure the module learning outcomes are met
Percentage Mark | < 30% | 30 - 39% | 40 - 49% | 50 - 59% | 60 - 69% | 70 - 85% | 85 - 100% | Guidance
Overall Descriptor | Very poor | Poor / Inadequate | Adequate | Good | Very Good | Excellent | Outstanding
Aims and Objectives | Aims not specified, scope unclear, no suitable challenges and depth/breadth | Aims barely specified, scope unclear, lack of suitable challenges and depth/breadth | Aims stated but too general or too narrow, scope unclear or inappropriate, challenges lacking depth | Aims stated but quite general or unambitious, some consideration of scope and related challenges | Aims, objectives and scope clearly stated, appropriate and largely addressed, with challenges undertaken and discussed | Challenging aims and objectives clearly stated and addressed; clear and appropriate scope; difficult challenges undertaken and discussed | Challenging aims and objectives clearly stated and fully addressed; clear and appropriate scope; all challenges fully and successfully completed | * Comments on aims and objectives, and how these developed - Were they realistic? - Have they been achieved, or have they diverted; if the latter, is there an explanation? * Scope: - Breadth and Depth - Level of Difficulty - Curation - over two semesters? * Reflection on how the project evolved from the initial aims and objectives - Commentary of what was actually done - Discussion on what could have been done differently
* Identify relevant investigation / research topic * Realistic and challenging aims and objectives identified * Identification of depth and breadth of the project * Level of Technical Difficulty in Investigation (scope)
Project Management | Little or no evidence | Approach poor, proposal / progress review documents missing, little evidence of use of supervision | Approach adequate; some progress review document missing; some evidence of use of supervision | Approach sound but unimaginative; required documents and further evidence of planning and use of supervision present | Thoughtful approach, required documents and sound evidence of planning and use of supervision present | Approach rigorous and appropriate; required documents and strong evidence of planning and use of supervision present | Approach rigorous and appropriate; evidence of planning, management and use of supervision impeccable; all requirements met | * All forms updated - Is it clear what has changed? What has been completed? * Self-direction: Working with others (contact register and conversation with supervisor) * Project Planning: - Project plan update and contact register to demonstrate progress - Resource and Contingency planning -Prioritising experimentation requirements * Time Constraints: Meetings, Experimentation, Contact Register * Risk awareness / mitigation: - Project plan / Gantt Chart and Risk Assessment update, Updated Resources - What was the reality? What was learnt? * Reflection on how well they managed / controlled their projects
* Evidence that student has led their own project (self-direction) * Evidence of project planning and appropriate use of supervision * Adherence to review and meeting dates, and all time constraints * Risk awareness and mitigation * Control of projects - resources, communication, demonstrated through regular interaction with UK-SPEC via logbook, etc.
Context to the Work | Negligible | Minimal, low level, perhaps entirely reliant on internet sources | Limited, perhaps primarily reliant on material from taught modules, or muddled approach | Some sound academic content, but unchallenging or not understood | Sound academic content, very good breadth or depth, understood and applied | Very good breadth and depth of academic content, understood and applied | Exceptional breadth and depth of academic content understood and implemented | * Breadth and depth * Interpretation of previous work: - Academically published - Commercial investigation Policy and codes of Practice * Discussion of information available Reflection of how the thinking has been influenced by the literature / background research - how this affected the project's development
* Background literature review and research (breadth and depth) * Interpretation of previous work in the topic * Critical discussion of relevant published work * If required, suitable contact with outside bodies; e.g. data providers, sponsoring companies, etc (primary research)
Research Methodology | Minimal breadth and depth; poor grasp of the techniques used; limited discussion about the wider impact of their work | Inadequate breadth and depth; little or no understanding of the techniques used; no understanding or discussion about the wider impact of their work | Limited breadth and depth; description of the techniques minimal; some understanding or discussion about the wider impact of their work, perhaps confused or unclear | Sensible breadth and depth; description of the techniques unclear; some understanding or discussion about the wider impact of their work, perhaps uninspiring or unconvincing | Good breadth and depth; description of the techniques clear; good understanding and discussion about the wider impact of their work | Very good breadth and depth; detailed description of the techniques and evaluated; well-defined understanding and detailed discussion about the wider impact of their work | Very good breadth and depth; excellent description and evaluation of the techniques used; well-defined understanding and insightful discussion about the wider impact of their work | * Reflected on the research done to enable you to design and experiment suitably to collect suitable data to get the appropriate type and level of analysis to draw the necessary conclusions * Limitations: ensure everything relevant is covered, but not all need to be there if not relevant. Consider the implications long term of the work done, e.g. costing, manufacturing processes, recycling issues, sustainability, etc.
* Appropriate selection of research methods demonstrating an understanding of alternative approaches * Relevant Breadth * Relevant Technical Depth * Identification, Use and justification of Appropriate Techniques to Gather and Analyse Data * Limitations: Ethical, Environmental, Financial, Time, Policies and Human Resources
Scientific Method - Technical Content | Little or no analysis or evaluation of content | Content mainly descriptive and analysis weak; no real evaluative content | Content mainly descriptive and analysis confused or superficial | Largely descriptive but with some attempt at analysis and evaluation of evidence | Good range of evidence appropriately analysed and evaluated | Wide range of evidence analysed and evaluated from appropriate perspectives | Wide range of evidence, carefully analysed and critically evaluated; original insights revealed | * What did they actually collect and analyse: What was done and why, and the result * Appropriate material provided to enable detailed assessment of the modelling strategy employed (in main text, or appendices / accompanying material where required); e.g. for Mathematical or CFD modelling: - Quality and structure of supporting mathematical material - Clarity of explanation of modelling activity
* Data collection and analysis based on justified methodology * Evaluation and interpretation of discoveries
Analysis and Scientific Argument | Structure poor, no real argument discernible | Superficial only, no real argument considered | Some sense of development of ideas, but not well organised | Good structure and flow, but conclusions unconvincing or unsurprising | Very good structure and flow; well argued; conclusions justified | Structure and flow excellent; very clear argument(s); conclusions justified | Structure and flow excellent; very clear and strong argument(s); conclusions justified | * When assumptions made on background work done, any investigation of dissimilarities in own work to confirm the assumption are suitable * Reflection of experimental approaches, result and analysis done - Was it appropriate - What was learnt - Could it be done differently, if so why? * Review of activity, exploration of product through appropriate techniques - CFD, experimentation, etc. - and limitations of own or previous work
* Development and Coherence of Arguments from the literature * Comparative analysis between project findings and literature review * Development and quality of the scientific argument * Evidence of the ability to evaluate information and synthesise conclusions * Critical appraisal of the research methods used * Innovation style: problem solving, or step-by-step learning through established techniques
Evaluation and Accomplishment | Little or no evidence, missing or minimal critical appraisal | Little awareness of shortcoming of work through critical appraisal | Some awareness of shortcomings of the approach taken or work through critical appraisal | Good, if uncritical, appraisal of both process and final results/product | Thorough critical appraisal of process and product/final results, sound evidence of learning | Achievements, shortcomings and potential further developments all fully appraised | Thorough, insightful appraisal of achievements, shortcomings, and potential further developments | * Reflection on the project process, and learning achieved * Reflection on revised aims, objectives and scope * Development of suitable recommendations based on this reflection
* Critical appraisal and evaluation of the project and process * Reflection of self-development whilst conducting the project - reflection of problem solving skills * Achievements and shortcomings of the project in relation to explicit aims and other criteria as appropriate * Relating the project to UK-SPEC competencies, with discussion about wider social / industrial implications, such as ethics, environment, finance, etc. * Further research and development * Recommendations
Citation | No / few citations of source material; source details missing / incomplete | Limited citation of sources; some source details missing / incomplete | Some citation of sources, but some source details missing / incomplete | Most sources cited and listed; some details missing / incomplete | Sources largely cited and listed correctly; errors in style or detail only | All sources correctly cited and listed; errors in style or detail | All sources correctly cited with full details listed | * Mixture of books, on-line, journals, etc. * If room, a bibliography for non-cited material
* Accuracy, Consistency and Completeness * Listing of References located at the end of the report or chapters * Possible use of a Bibliography - understanding distinction between referencing and bibliography
Report Presentation | Layout poor; grammatical, spelling / punctuation errors throughout | Poorly laid out and let down by poor standard of writing and/or proof-reading | Layout very basic; readability marred by errors in use of English / proof-reading | Reasonably well-written and presented; scope to improve style or proof-reading | Very well-written and presented with only minor errors in typography or style | Very well-written and presented, negligible errors in typography or style | Exceptional style, standard of writing and presentation, may be publishable | * Abstract v. introduction: not the same! Abstract – brief summary of what was investigated, found out and concluded Introduction – where has the project come from and why * Layout as required: discuss with supervisor & read instructions
* Logical structure of report and clarity of presentation * Conformity to style and layout requirements * Quality of writing, spelling, grammar, diagrams, figures and tables * Clarity of Expression and use of English * Appropriateness of Style to Audience * Summary of UK-SPEC Competencies acquired during project

Sheet: Criteria and Weightings
Marking Criteria: Dissertation
Staff Only
(Use SafeAssign)
 | Criteria - Report | Criteria Weighting
 |  | UFMFX8-30-3 | UFMFY8-30-3 | UFMERY-30-M | UFMFTF-60-M | UFMFEH-120-M | UFMEYN-120-M
 |  | L3 30 credits | L3 30 credits | LM 30 credits | LM 60 credits | LM 120 credits | LM 120 credits
1 | Aims and Objectives
 | * Identify relevant investigation / research topic * Realistic and challenging aims and objectives identified * Identification of depth and breadth of the project * Level of Technical Difficulty in Investigation (scope) | 5% | 5% | 5% | 10% | 10% | 10%
2 | Project Management
 | * Evidence that student has led their own project (self-direction) * Evidence of project planning and appropriate use of supervision * Adherence to review and meeting dates, and all time constraints * Risk awareness and mitigation * Control of projects - resources, communication, demonstrated through regular interaction with UK-SPEC via logbook, etc. | 10% | 10% | 10% | 5% | 5% | 5%
3 | Context to the Work
 | * Background literature review and research (breadth and depth) * Interpretation of previous work in the topic * Critical discussion of relevant published work * If required, suitable contact with outside bodies; e.g. data providers, sponsoring companies, etc (primary research) | 10% | 10% | 10% | 15% | 15% | 15%
4 | Research Methodology
 | * Appropriate selection of research methods demonstrating an understanding of alternative approaches * Relevant Breadth * Relevant Technical Depth * Identification, Use and justification of Appropriate Techniques to Gather and Analyse Data * Limitations: Ethical, Environmental, Financial, Time, Policies and Human Resources | 10% | 10% | 10% | 15% | 15% | 15%
5 | Scientific Method - Technical Content
 | * Data collection and analysis based on justified methodology * Evaluation and interpretation of discoveries | 15% | 15% | 15% | 10% | 10% | 10%
6 | Analysis and Scientific Argument
 | * Development and Coherence of Arguments from the literature * Comparative analysis between project findings and literature review * Development and quality of the scientific argument * Evidence of the ability to evaluate information and synthesise conclusions * Critical appraisal of the research methods used * Innovation style: problem solving, or step-by-step learning through established techniques | 15% | 15% | 15% | 15% | 15% | 15%
7 | Evaluation and Accomplishment
 | * Critical appraisal and evaluation of the project and process * Reflection of self-development whilst conducting the project - reflection of problem solving skills * Achievements and shortcomings of the project in relation to explicit aims and other criteria as appropriate * Relating the project to UK-SPEC competencies, with discussion about wider social / industrial implications, such as ethics, environment, finance, etc. * Further research and development * Recommendations | 15% | 15% | 15% | 20% | 20% | 20%
8 | Citation
 | * Accuracy, Consistency and Completeness * Listing of References located at the end of the report or chapters * Possible use of a Bibliography - understanding distinction between referencing and bibliography | 10% | 10% | 10% | 5% | 5% | 5%
9 | Report Presentation
 | * Logical structure of report and clarity of presentation * Conformity to style and layout requirements * Quality of writing, spelling, grammar, diagrams, figures and tables * Clarity of Expression and use of English * Appropriateness of Style to Audience * Summary of UK-SPEC Competencies acquired during project | 10% | 10% | 5% | 5% | 5% | 5%
