appletonN/FYP/4146FDRG1WL._SL500_AC_SS350_.jpg

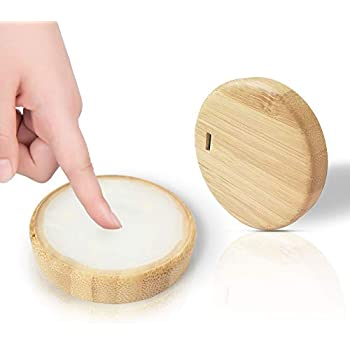
4146FDRG1WL._SL500_AC_SS350_.jpg
