appletonN/FYP/documents/Final Report/Images/SpectrometerDevice.jpg

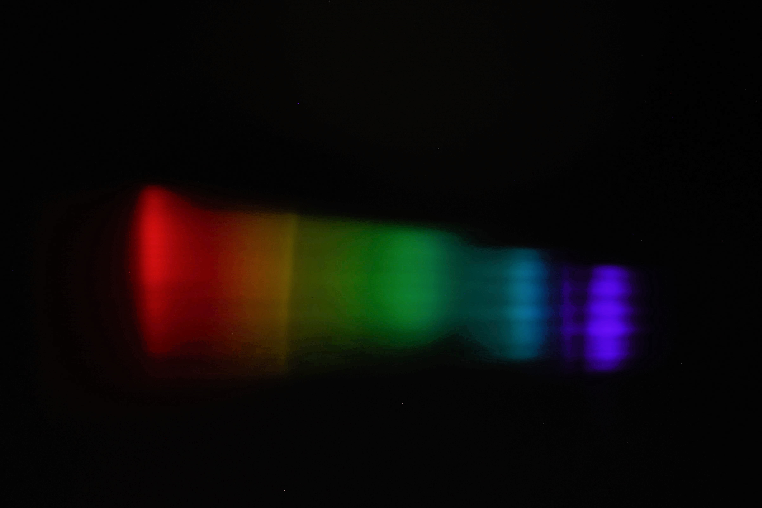
documents/Final Report/Images/SpectrometerDevice.jpg
