appletonN/FYP/documents/Final Report/PDFs/Gantts/apr2/AdminFirstHalf.png

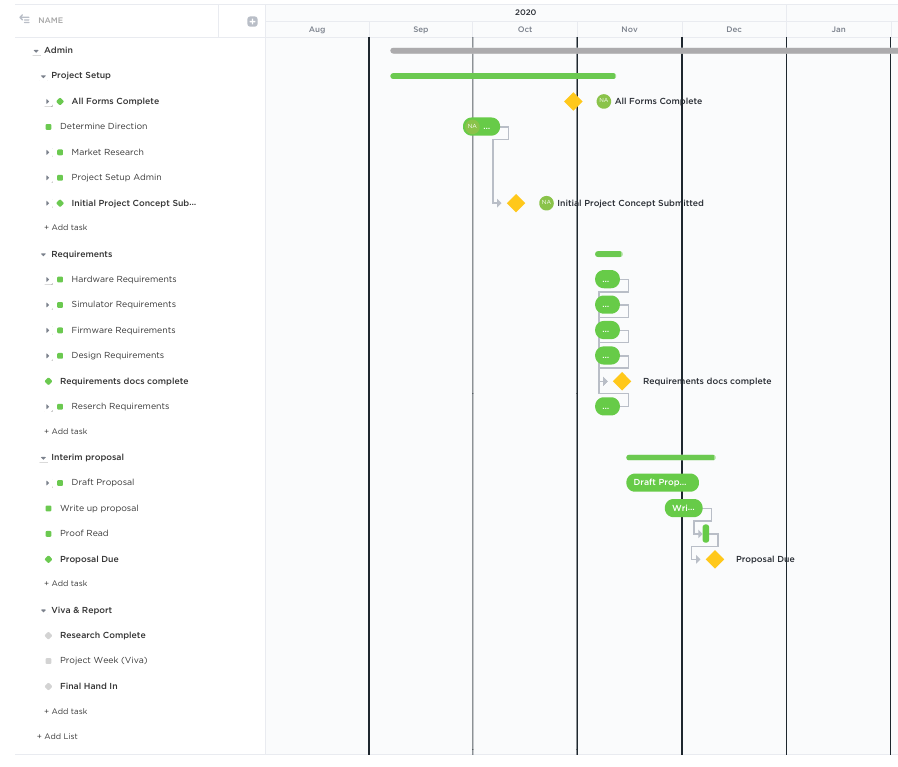
documents/Final Report/PDFs/Gantts/apr2/AdminFirstHalf.png
