appletonN/FYP/Hardware/pictures/pcb3d2.jpg

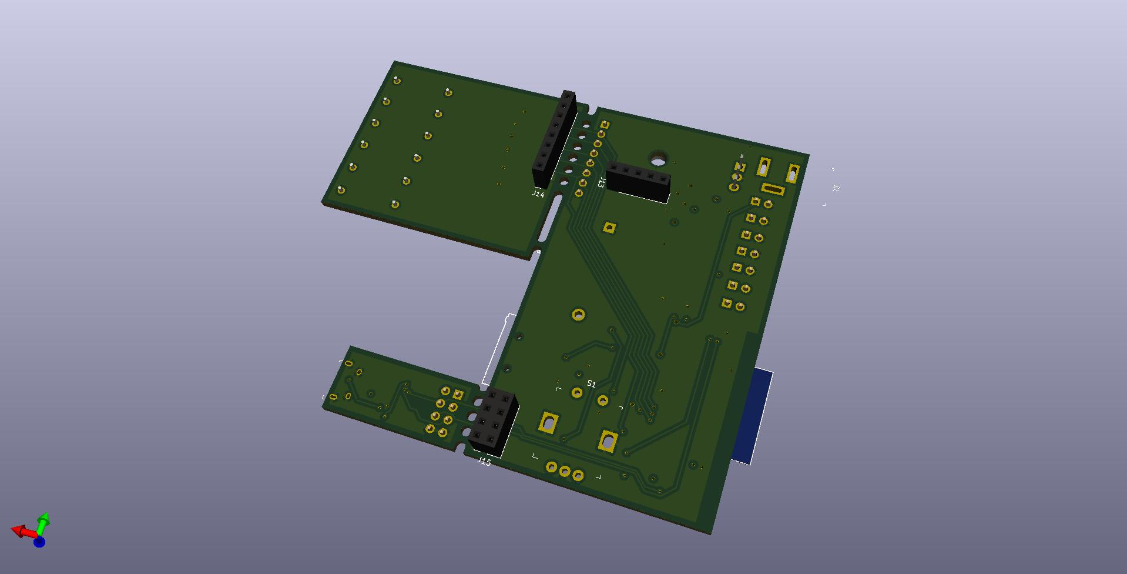
Hardware/pictures/pcb3d2.jpg
