appletonN/FYP/Hardware/V2/bottom.png

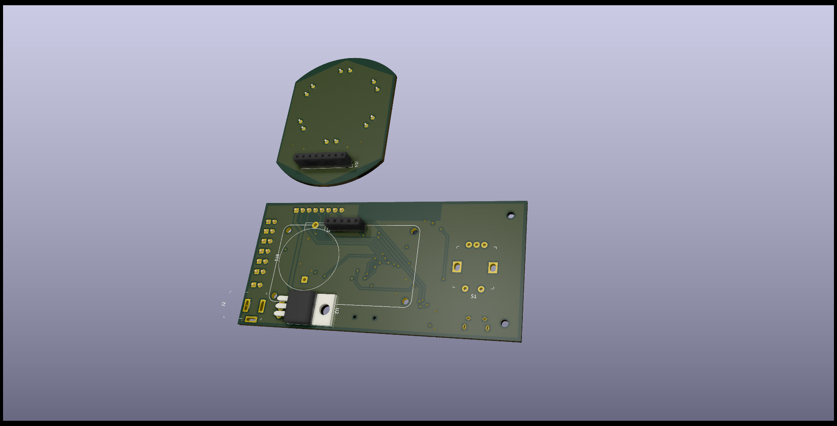
Hardware/V2/bottom.png
