appletonN/FYP/Hardware/V2/Top.png

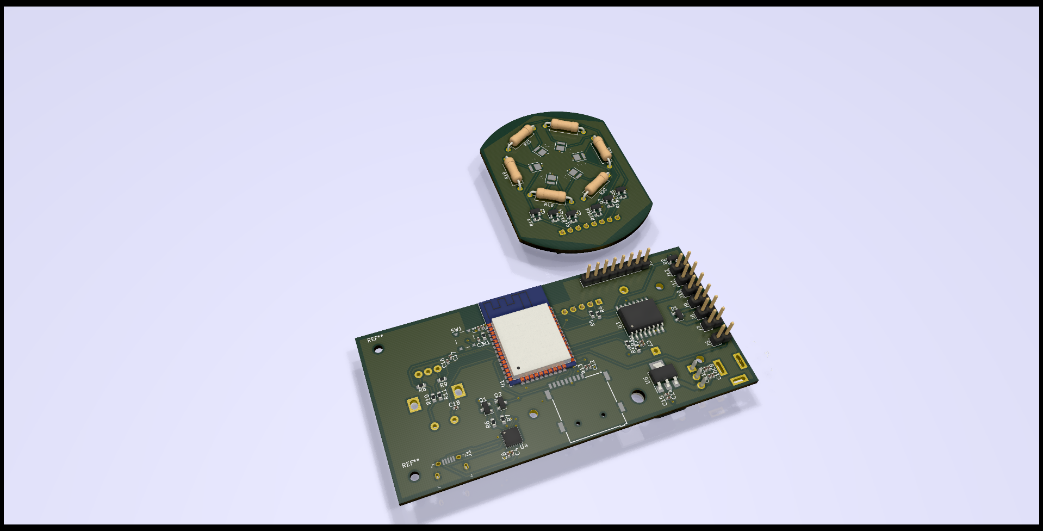
Hardware/V2/Top.png
