appletonN/FYP/Measurements/Fluorescent_spectrum_labelled.png

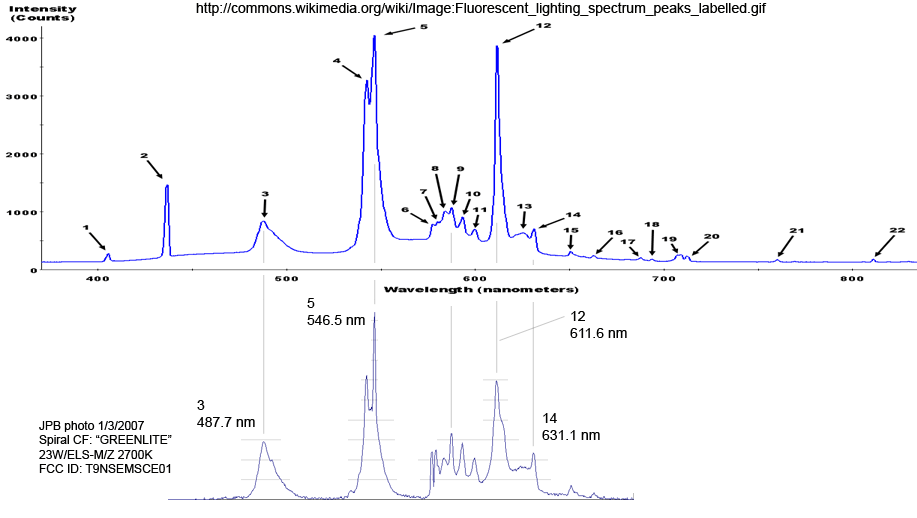
Measurements/Fluorescent_spectrum_labelled.png
