appletonN/FYP/Hardware/Project/BOM.xlsx

BT1 | Battery_Cell | digikey-footprints:Battery_Holder_Coin_2032_BS-7
C1 | 1n | Capacitor_SMD:C_0402_1005Metric
C2 | 100n | Capacitor_SMD:C_0402_1005Metric
C3 | 100n | Capacitor_SMD:C_0402_1005Metric
C4 | 1n | Capacitor_SMD:C_0402_1005Metric
C5 | 1n | Capacitor_SMD:C_0402_1005Metric
C6 | 100n | Capacitor_SMD:C_0402_1005Metric
C7 | 100n | Capacitor_SMD:C_0402_1005Metric
C8 | 4u7 | Capacitor_SMD:C_0402_1005Metric
C9 | 100n | Capacitor_SMD:C_0402_1005Metric
C10 | 4u7 | Capacitor_SMD:C_0402_1005Metric
C11 | 100n | Capacitor_SMD:C_0402_1005Metric
C12 | 1n | Capacitor_SMD:C_0402_1005Metric
C13 | 100n | Capacitor_SMD:C_0402_1005Metric
C14 | 4u7 | Capacitor_SMD:C_0402_1005Metric
C15 | 100n | Capacitor_SMD:C_0402_1005Metric
C16 | 10n | Capacitor_SMD:C_0402_1005Metric
C17 | 10n | Capacitor_SMD:C_0402_1005Metric
C18 | 10n | Capacitor_SMD:C_0402_1005Metric
D1 | PSM712-LF-T7 | Package_TO_SOT_SMD:SOT-23
D2 | PSM712-LF-T7 | Package_TO_SOT_SMD:SOT-23
D3 | LED | digikey-footprints:LED_L135-A589003500000
D4 | LED | digikey-footprints:LED_L135-A589003500000
D5 | LED | digikey-footprints:LED_L135-A589003500000
D6 | LED | digikey-footprints:LED_L135-A589003500000
D7 | LED | digikey-footprints:LED_L135-A589003500000
D8 | LED | digikey-footprints:LED_L135-A589003500000
D9 | LED | digikey-footprints:LED_L135-A589003500000
D10 | LED | digikey-footprints:LED_L135-A589003500000
D11 | LED | digikey-footprints:LED_L135-A589003500000
D12 | LED | digikey-footprints:LED_L135-A589003500000
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
U1 | ESP32-WROOM-32 | RF_Module:ESP32-WROOM-32
U2 | LM7812_TO220 | Package_TO_SOT_THT:TO-220-3_Horizontal_TabDown
U3 | DS3231M | Package_SO:SOIC-16W_7.5x10.3mm_P1.27mm
U4 | CP2104 | Package_DFN_QFN:QFN-24-1EP_4x4mm_P0.5mm_EP2.6x2.6mm
U5 | AMS1117-3.3 | Package_TO_SOT_SMD:SOT-223-3_TabPin2
