appletonN/FYP/documents/Final Report/Wordcount instructions.txt

texcount -inc -1 -sum main.tex > WordCount.sum
