appletonN/FYP/Measurements/Comparison/all.xlsx

Wavelength | morning | afternoon | evening | night | morning | afternoon | evening | night | CFL | LED
400 | 0.0015 | 0.0007 | 0.0007 | 0 | -0.00061377 | -0.00038551 | -0.00084711 | -0.00091812 | 0.0022 | 0.000447
404 | 0.002 | 0.0007 | 0.0007 | 0 | 0.0013917 | 0.0010702 | 0.00069584 | 0.00056627 | 0.001289 | 0.000578
408 | 0.0029 | 0.0008 | 0.0008 | 0 | 0.0030345 | 0.0021278 | 0.0018317 | 0.0012758 | 0.000289 | 0.000869
412 | 0.0054 | 0.0009 | 0.0009 | 0 | 0.0064793 | 0.0054909 | 0.0049727 | 0.0033877 | 0.000189 | 0.001348
416 | 0.0143 | 0.0009 | 0.0009 | 0 | 0.010514 | 0.0085118 | 0.0073029 | 0.0050166 | 0.000168 | 0.002214
420 | 0.046 | 0.001 | 0.001 | 0 | 0.017667 | 0.013883 | 0.01104 | 0.0072202 | 0.00015 | 0.003612
424 | 0.146 | 0.0011 | 0.0011 | 0 | 0.031022 | 0.0243 | 0.019288 | 0.012624 | 0.000312 | 0.005932
428 | 0.412 | 0.0012 | 0.0012 | 0 | 0.051758 | 0.040411 | 0.031303 | 0.021391 | 0.003288 | 0.009777
432 | 0.989 | 0.0014 | 0.0013 | 0 | 0.077778 | 0.060741 | 0.047194 | 0.031423 | 0.006161 | 0.01564
436 | 2 | 0.0015 | 0.0014 | 0 | 0.10953 | 0.085066 | 0.065683 | 0.0436 | 0.002317 | 0.02502
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
