appletonN/FYP/Measurements/Comparison/references.xlsx

Wavwelength | morning | afternoon | evening | night
404 | 0.5852941176 | 0.02251111344 | 0.01537539338 | 0.004224502112
408 | 0.6022875817 | 0.0249465263 | 0.01703881313 | 0.004526252263
412 | 0.6264705882 | 0.0278646336 | 0.01903191968 | 0.004375377188
416 | 0.6369281046 | 0.03058527499 | 0.02089015435 | 0.00528062764
420 | 0.6382352941 | 0.03348144163 | 0.02286827514 | 0.004828002414
424 | 0.6277777778 | 0.03692612468 | 0.02522104001 | 0.00528062764
428 | 0.6016339869 | 0.04021722314 | 0.02746890454 | 0.005582377791
432 | 0.612745098 | 0.04379355013 | 0.029911584 | 0.006035003018
436 | 0.6555555556 | 0.04743569909 | 0.03239922074 | 0.006789378395
440 | 0.6928104575 | 0.05191159299 | 0.0354563165 | 0.007242003621
444 | 0.7303921569 | 0.05691406264 | 0.03887307058 | 0.008147254074
448 | 0.7647058824 | 0.06239922673 | 0.04261951146 | 0.008901629451
452 | 0.7849673203 | 0.06871813577 | 0.04693541136 | 0.009806879903
456 | 0.7924836601 | 0.07560750187 | 0.05164094111 | 0.01116475558
460 | 0.8 | 0.08278209651 | 0.05654128578 | 0.01222088111
464 | 0.7990196078 | 0.09072461412 | 0.06196613217 | 0.01327700664
468 | 0.7859477124 | 0.09921564813 | 0.06776562266 | 0.01433313217
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
