appletonN/FYP/Measurements/Calibration/Calibration.xlsx

x value of peak | nm equivilent
-1471.5 | 436.6
-644.5 | 487.7
257.5 | 542.4
327.5 | 546.5
847.5 | 577.7
884.5 | 580.2
959.5 | 584
1018.5 | 587.6
1115.5 | 593.4
1221.5 | 599.7
1430.5 | 611.6
1664.5 | 625.7
1766.5 | 631.1
2108.5 | 650.8
