appletonN/FYP/Measurements/Comparison/Outdoors.csv

Wavelength | 10AM LA sunny | 4PM LA shade | 6AM LA November Twilight | 7AM LA foggy | Blue Sky LA 2PM | Green Grass 4PM | Roadway 4PM | Roadway Shady 4PM | Sidewalk 4PM | Sidewalk Shady 4PM | White House 4PM | White House Shady 4PM
380 | 0.5609 | 0.1127 | 0.000032 | 0.0162 | 0.04075 | 0.001862 | 0.005447 | 0.001397 | 0.01296 | 0.004251 | 0.0156 | 0.002866 |  | 1.524 | 0.368044619 | 0
384 | 0.5121 | 0.1013 | 0.000029 | 0.01471 | 0.03719 | 0.001834 | 0.0053 | 0.001319 | 0.01267 | 0.004077 | 0.01782 | 0.003086 |  | 52.698 | 0.336023622 | 0
388 | 0.5557 | 0.1086 | 0.000031 | 0.01562 | 0.03801 | 0.002031 | 0.005742 | 0.001389 | 0.01395 | 0.004374 | 0.02328 | 0.003809 |  |  | 0.364632546 | 0
392 | 0.5831 | 0.1127 | 0.000032 | 0.01613 | 0.03816 | 0.002231 | 0.006064 | 0.001436 | 0.01491 | 0.004584 | 0.03109 | 0.004785 |  |  | 0.382611549 | 0
396 | 0.6614 | 0.1259 | 0.000036 | 0.01816 | 0.04167 | 0.002738 | 0.007101 | 0.00163 | 0.01761 | 0.005297 | 0.04809 | 0.006966 |  |  | 0.433989501 | 0
400 | 0.8473 | 0.1601 | 0.000045 | 0.02263 | 0.05069 | 0.003728 | 0.009127 | 0.002038 | 0.02289 | 0.006733 | 0.07737 | 0.01073 | 0.014 |  | 0.555971129 | 0.000265665
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
