appletonN/FYP/Measurements/Comparison/Philips Hue.csv

Wavelength | 2700k-hue | 3400k-hue | 4100k-hue | 5000k-hue | 6500k-hue | blueLEDalmost | greenLEDalmost | redLED | This data is licensed from the f.luxometer project (https://fluxometer.com/) and f.lux Software LLC by CC-Attribution: https://creativecommons.org/licenses/by/4.0/
340.16 | 0 | 0 | 0 | 0 | 0 | 0 | 0 | 0
340.54 | 0 | 0 | 0 | 0 | 0 | 0 | 0 | 0
340.91 | 0 | 0 | 0 | 0 | 0 | 0 | 0 | 0
341.29 | 0 | 0 | 0 | 0 | 0 | 0 | 0 | 0
341.67 | 0 | 0 | 0 | 0 | 0 | 0 | 0 | 0
342.05 | 0 | 0 | 0 | 0 | 0 | 0 | 0 | 0
342.43 | 0 | 0 | 0 | 0 | 0 | 0 | 0 | 0
342.8 | 0 | 0 | 0 | 0 | 0 | 0 | 0 | 0
343.18 | 0 | 0 | 0 | 0 | 0 | 0 | 0 | 0
343.56 | 0 | 0 | 0 | 0 | 0 | 0 | 0 | 0
343.94 | 0 | 0 | 0 | 0 | 0 | 0 | 0 | 0
344.31 | 0 | 0 | 0 | 0 | 0 | 0 | 0 | 0
344.69 | 0 | 0 | 0 | 0 | 0 | 0 | 0 | 0
345.07 | 0 | 0 | 0 | 0 | 0 | 0 | 0 | 0
345.45 | 0 | 0 | 0 | 0 | 0 | 0 | 0 | 0
345.83 | 0 | 0 | 0 | 0 | 0 | 0 | 0 | 0
346.2 | 0 | 0 | 0 | 0 | 0 | 0 | 0 | 0
346.58 | 0 | 0 | 0 | 0 | 0 | 0 | 0 | 0
346.96 | 0 | 0 | 0 | 0 | 0 | 0 | 0 | 0
347.34 | 0 | 0 | 0 | 0 | 0 | 0 | 0 | 0
347.71 | 0 | 0 | 0 | 0 | 0 | 0 | 0 | 0
348.09 | 0 | 0 | 0 | 0 | 0 | 0 | 0 | 0
348.47 | 0 | 0 | 0 | 0 | 0 | 0 | 0 | 0
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
