appletonN/FYP/Measurements/calibration.png

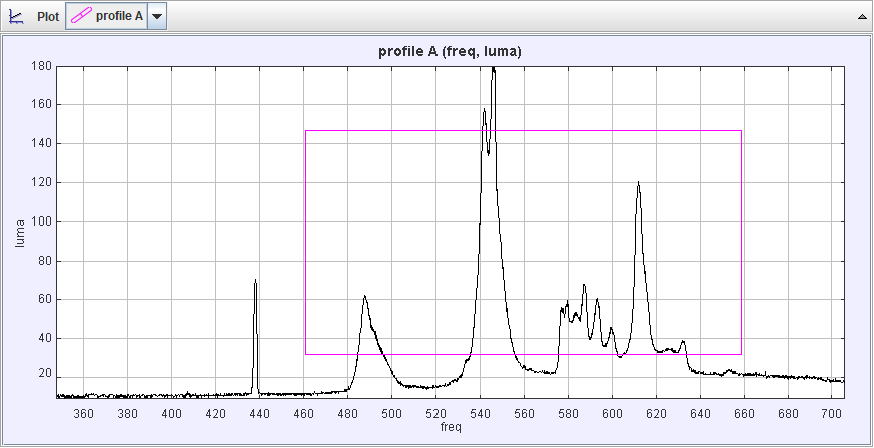
Measurements/calibration.png
