appletonN/FYP/Measurements/Calibration/Automated/output1.png.bmp

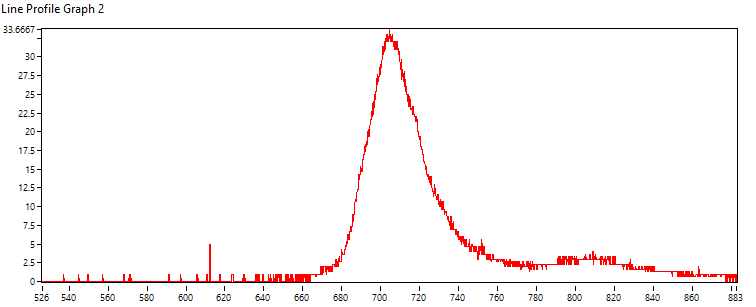
Measurements/Calibration/Automated/output1.png.bmp
