appletonN/FYP/Measurements/Calibration/CFL1.JPG

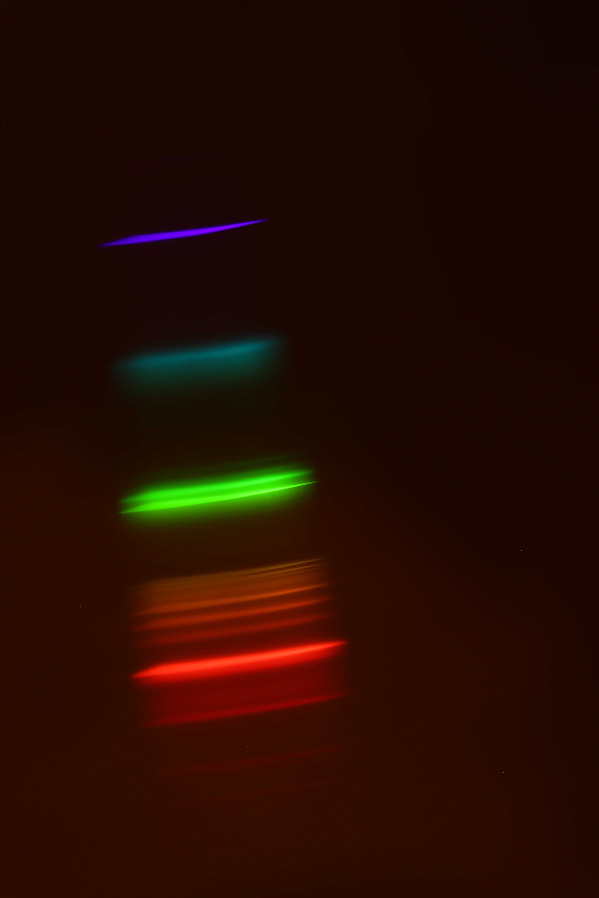
Measurements/Calibration/CFL1.JPG
