appletonN/FYP/Measurements/Calibration/CFL3.JPG

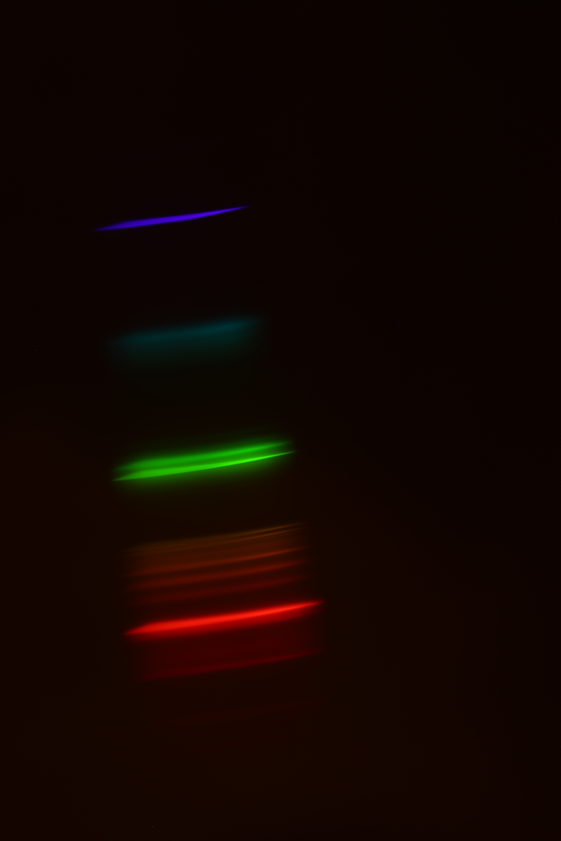
Measurements/Calibration/CFL3.JPG
