appletonN/FYP/Measurements/Calibration/CFL4.JPG

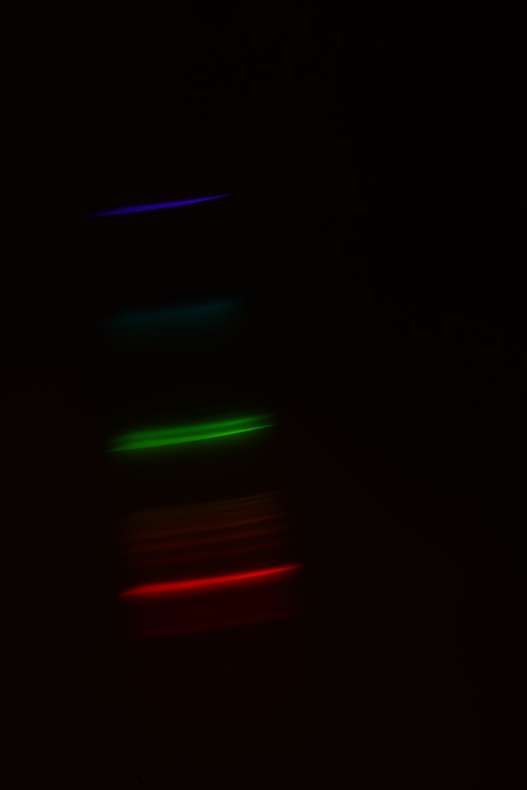
Measurements/Calibration/CFL4.JPG
