appletonN/FYP/Measurements/Calibration/Device/1Red.JPG

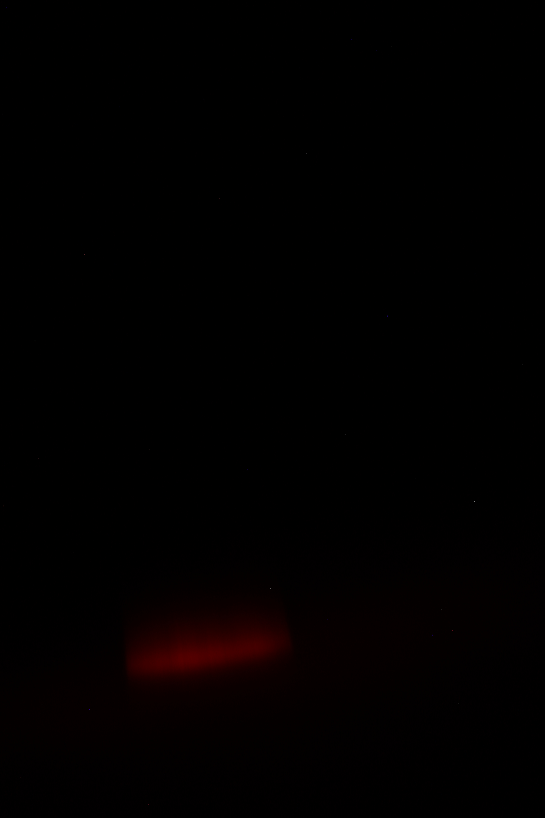
Measurements/Calibration/Device/1Red.JPG
