appletonN/FYP/Measurements/Calibration/Device/2Amber.JPG

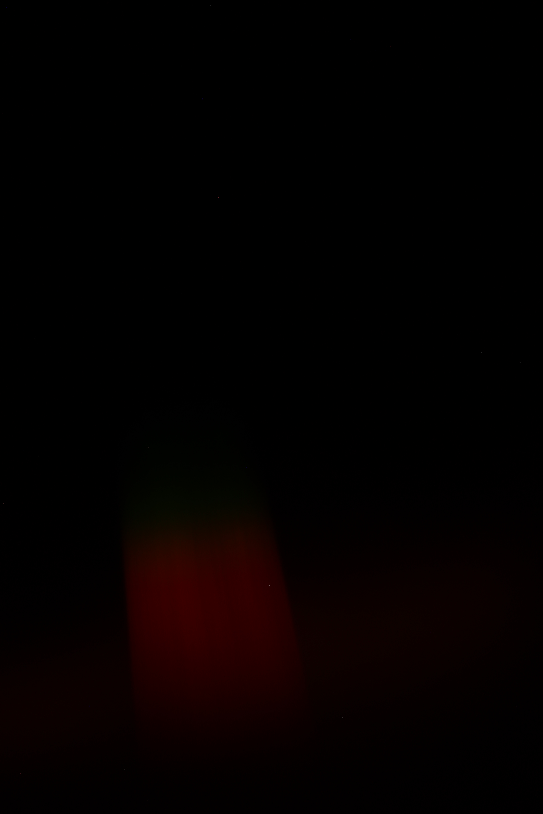
Measurements/Calibration/Device/2Amber.JPG
