appletonN/FYP/Measurements/Calibration/Device/3lime.JPG

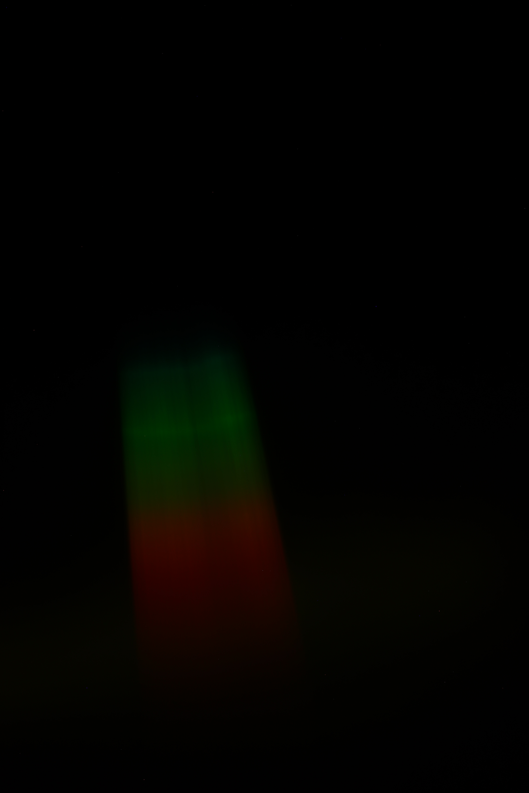
Measurements/Calibration/Device/3lime.JPG
