appletonN/FYP/Measurements/Calibration/Device/5blue.JPG

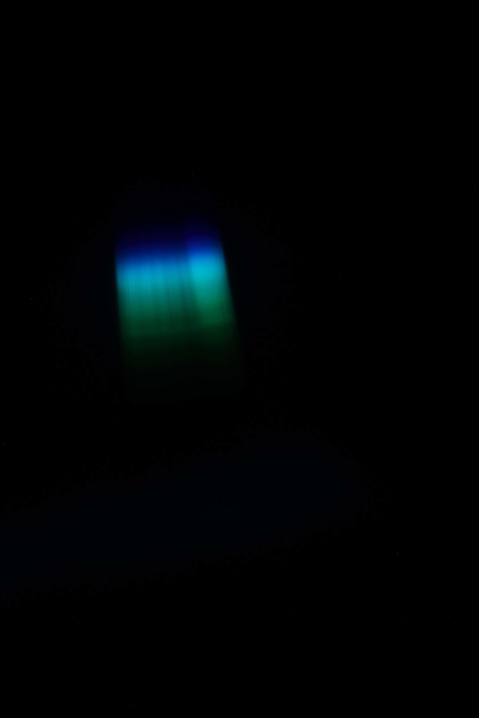
Measurements/Calibration/Device/5blue.JPG
