appletonN/FYP/Measurements/Calibration/Device/6Rblue.JPG

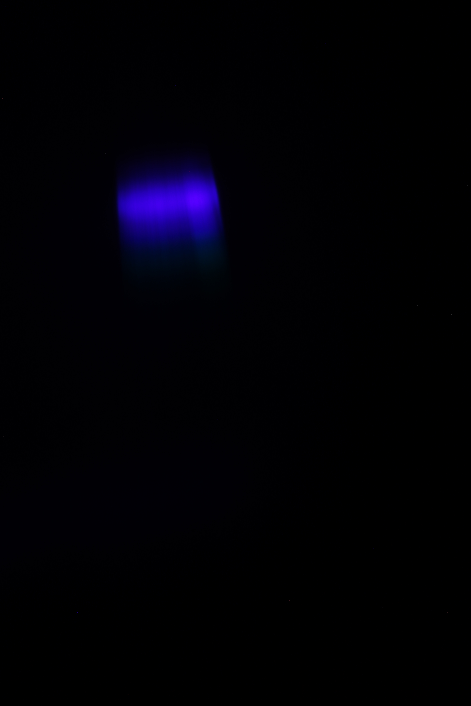
Measurements/Calibration/Device/6Rblue.JPG
