appletonN/FYP/Measurements/Calibration/Device/11green&blue.JPG

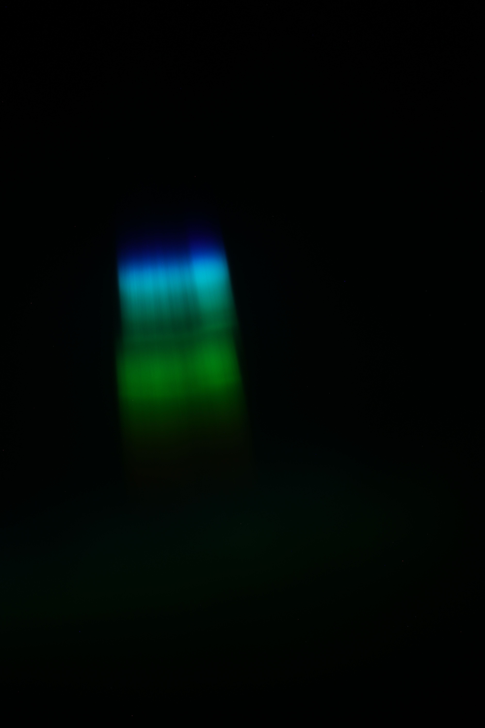
Measurements/Calibration/Device/11green&blue.JPG
