appletonN/FYP/Measurements/Calibration/Device/12blue&Rblue.JPG

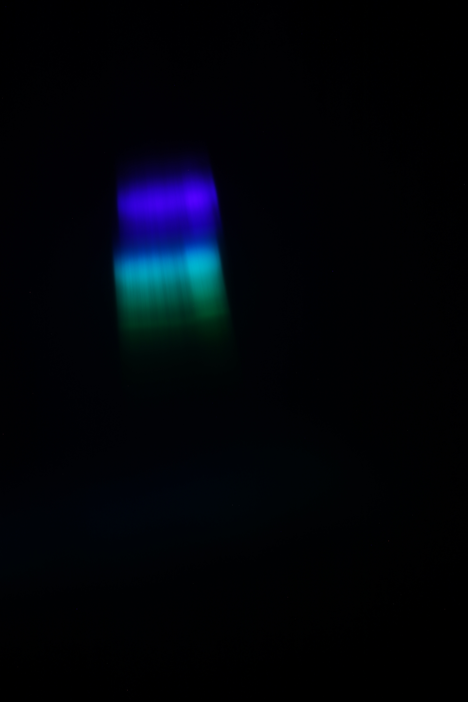
Measurements/Calibration/Device/12blue&Rblue.JPG
