appletonN/FYP/Measurements/Calibration/Device/16limeGreen&blue.JPG

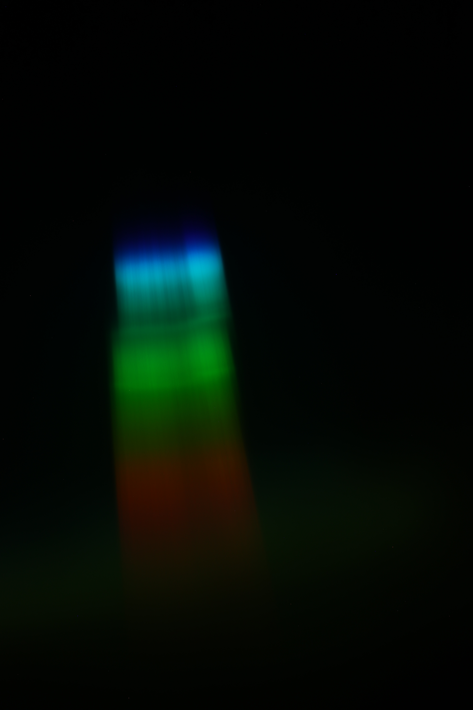
Measurements/Calibration/Device/16limeGreen&blue.JPG
