appletonN/FYP/Measurements/Calibration/Device/17greenBlue&Rblue.JPG

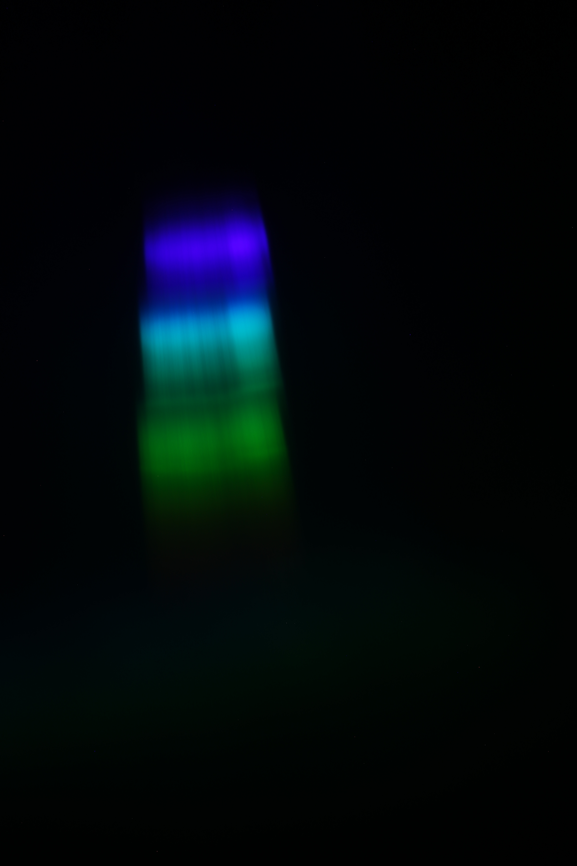
Measurements/Calibration/Device/17greenBlue&Rblue.JPG
