appletonN/FYP/Measurements/Calibration/Device/22halfsidesblue-Rblue.JPG

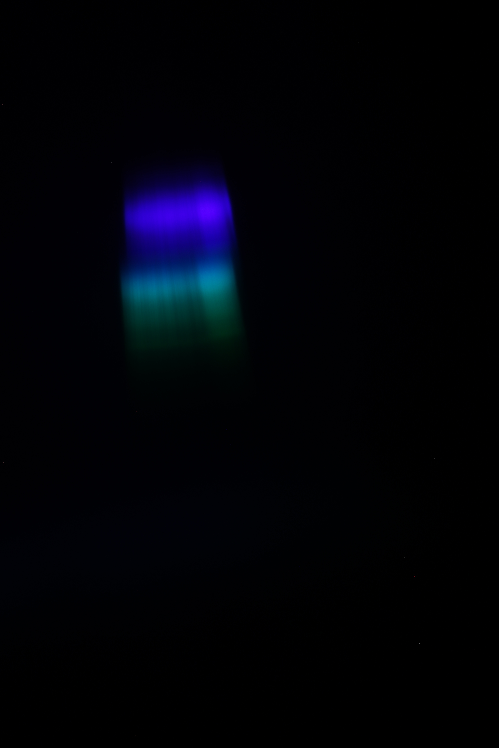
Measurements/Calibration/Device/22halfsidesblue-Rblue.JPG
