appletonN/FYP/Measurements/Calibration/Device/23halfmidFRed-amber.JPG

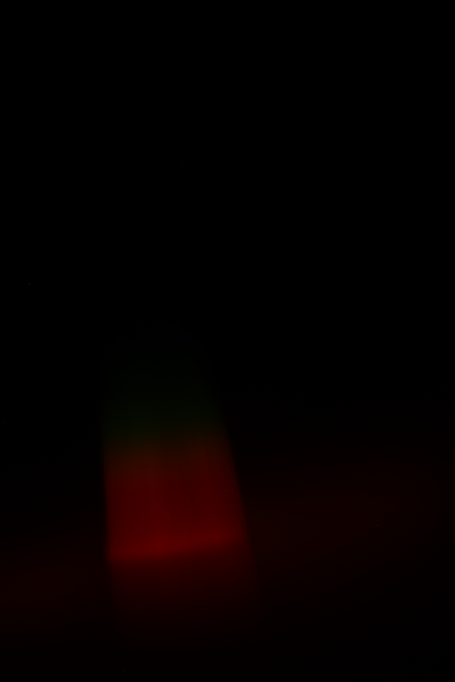
Measurements/Calibration/Device/23halfmidFRed-amber.JPG
