appletonN/FYP/Measurements/Calibration/Device/26halfMidGreen-Rblue.JPG

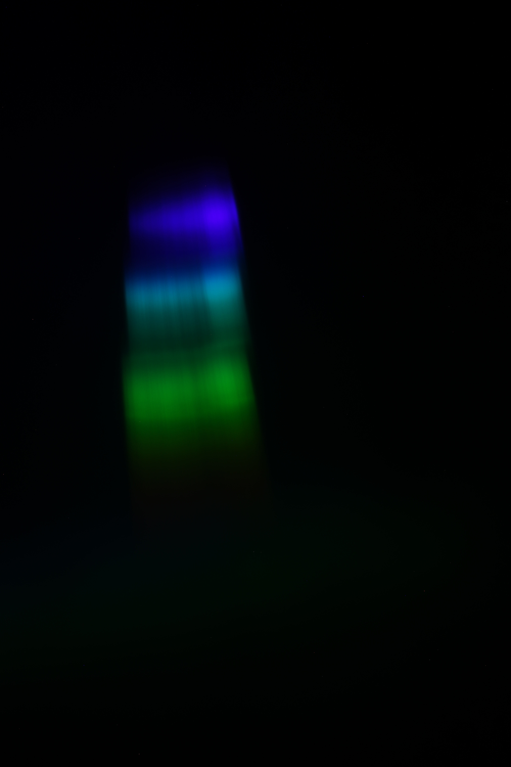
Measurements/Calibration/Device/26halfMidGreen-Rblue.JPG
