appletonN/FYP/Measurements/Calibration/Device/32Qsidesgreen-Rblue.JPG

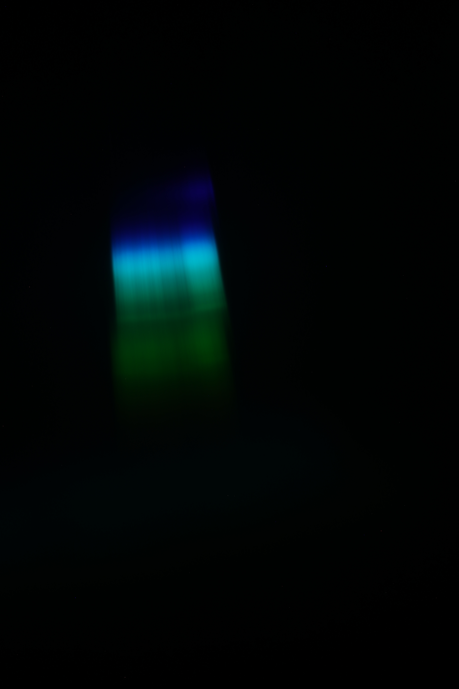
Measurements/Calibration/Device/32Qsidesgreen-Rblue.JPG
