appletonN/FYP/Measurements/Calibration/Device/34QmidFred-amber.JPG

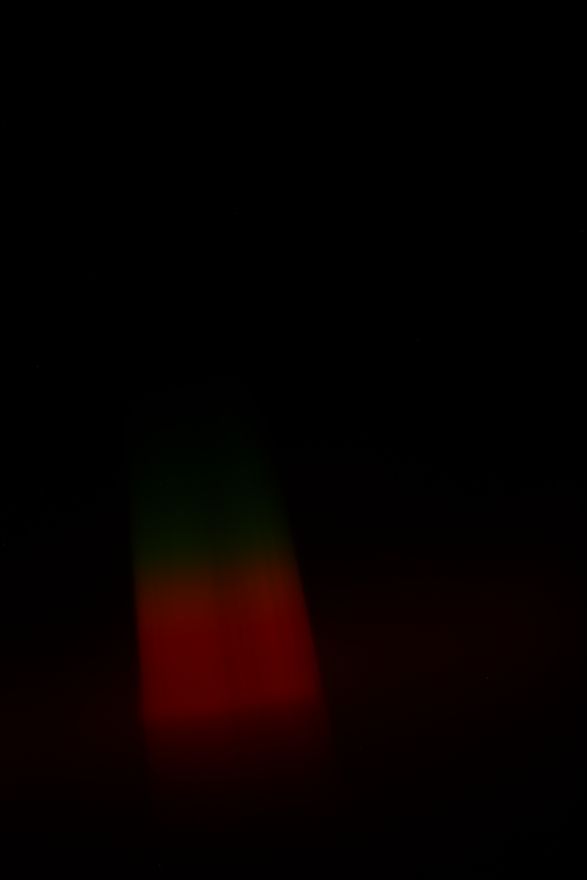
Measurements/Calibration/Device/34QmidFred-amber.JPG
