appletonN/FYP/Measurements/Calibration/Device/38Qmidgreen-Rblue.JPG

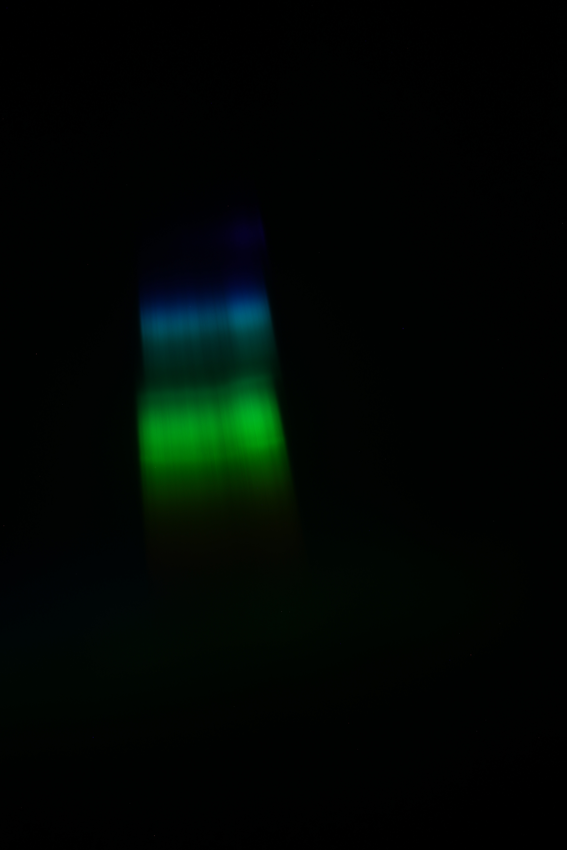
Measurements/Calibration/Device/38Qmidgreen-Rblue.JPG
