appletonN/FYP/Measurements/Calibration/Device/All1.JPG

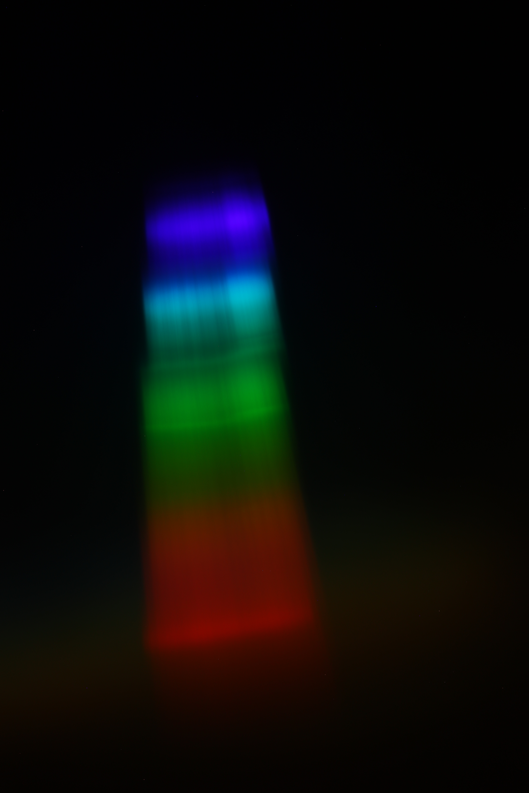
Measurements/Calibration/Device/All1.JPG
