appletonN/FYP/Measurements/Calibration/Device/Output/10Lime&green.JPG

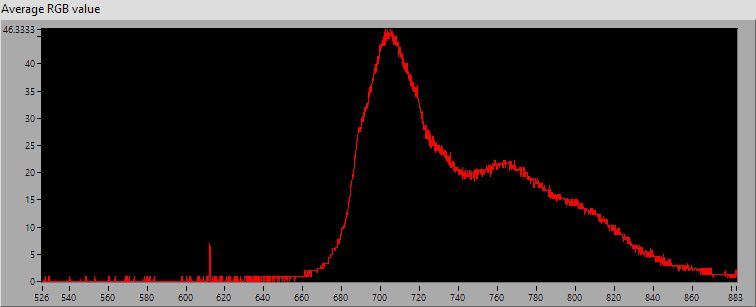
Measurements/Calibration/Device/Output/10Lime&green.JPG
