appletonN/FYP/Measurements/Calibration/Device/Output/11green&blue.JPG

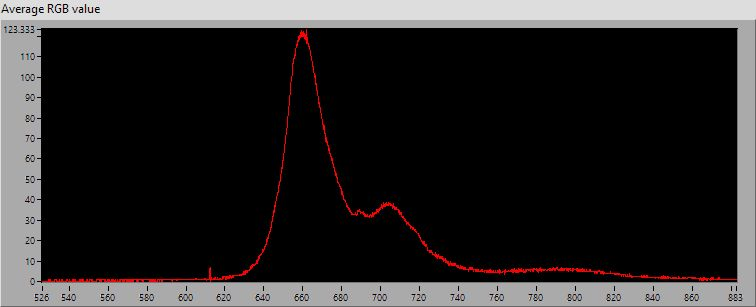
Measurements/Calibration/Device/Output/11green&blue.JPG
