appletonN/FYP/Measurements/Calibration/Device/Output/12blue&Rblue.JPG

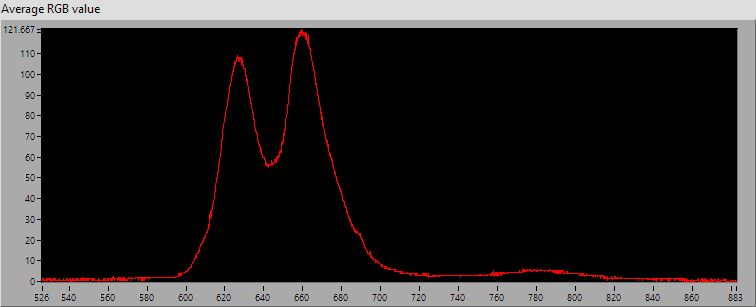
Measurements/Calibration/Device/Output/12blue&Rblue.JPG
