appletonN/FYP/Measurements/Calibration/Device/Output/13FredRed&amber.JPG

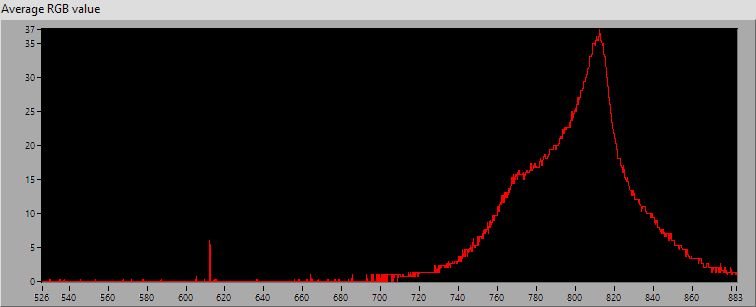
Measurements/Calibration/Device/Output/13FredRed&amber.JPG
