appletonN/FYP/Measurements/Calibration/Device/Output/14redAmber&lime.JPG

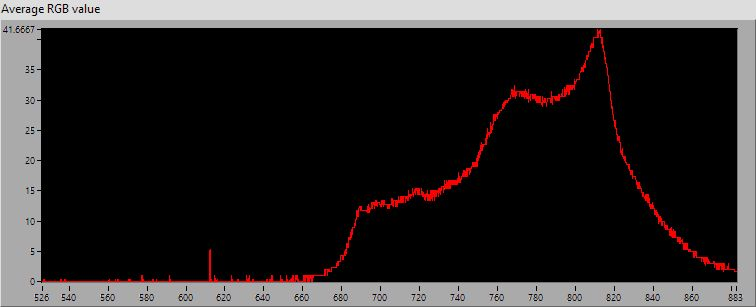
Measurements/Calibration/Device/Output/14redAmber&lime.JPG
