appletonN/FYP/Measurements/Calibration/Device/Output/All1.JPG

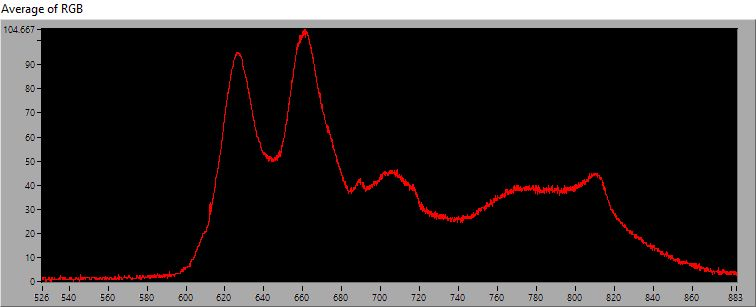
Measurements/Calibration/Device/Output/All1.JPG
