appletonN/FYP/Measurements/Calibration/outputs/Average/1R.png

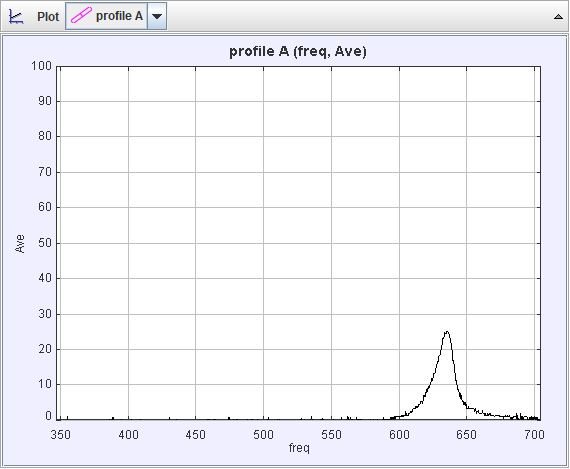
Measurements/Calibration/outputs/Average/1R.png
