appletonN/FYP/Measurements/Calibration/outputs/Average/2A.png

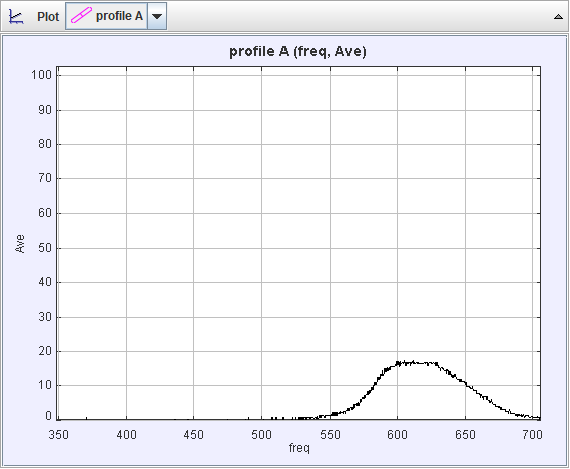
Measurements/Calibration/outputs/Average/2A.png
