appletonN/FYP/Measurements/Calibration/outputs/Average/4Green.png

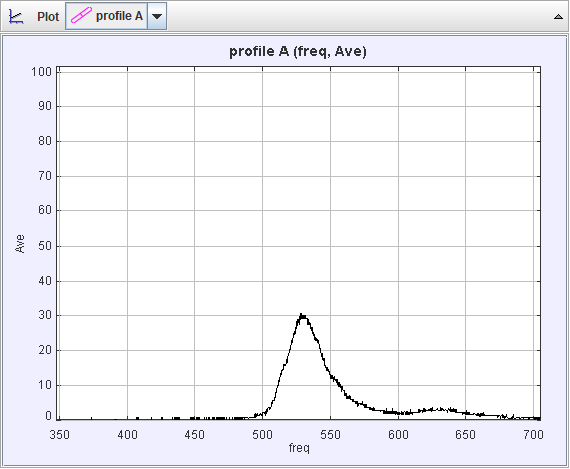
Measurements/Calibration/outputs/Average/4Green.png
