appletonN/FYP/Measurements/Calibration/outputs/Average/5B.png

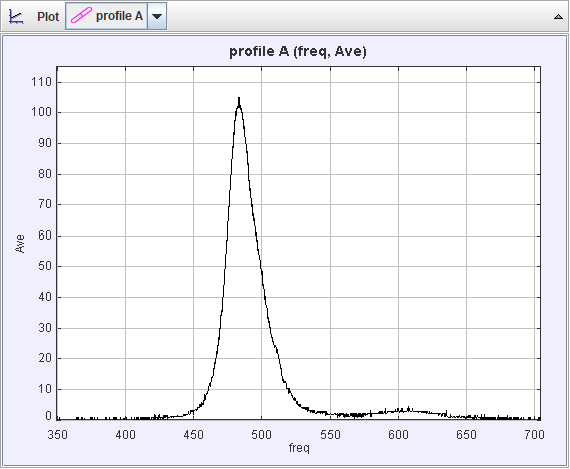
Measurements/Calibration/outputs/Average/5B.png
