appletonN/FYP/Measurements/Calibration/outputs/Average/6Rb.png

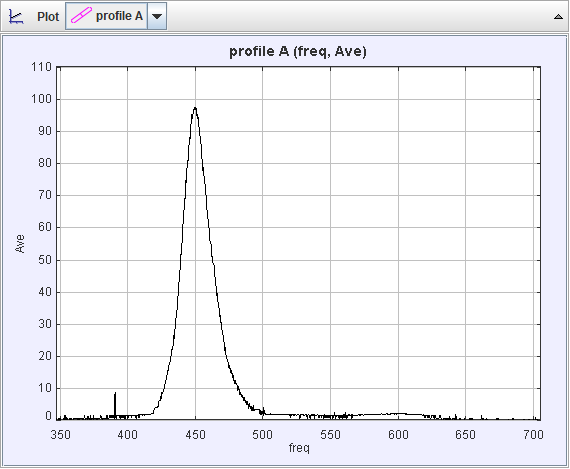
Measurements/Calibration/outputs/Average/6Rb.png
