appletonN/FYP/Measurements/Calibration/outputs/Average/7RA.png

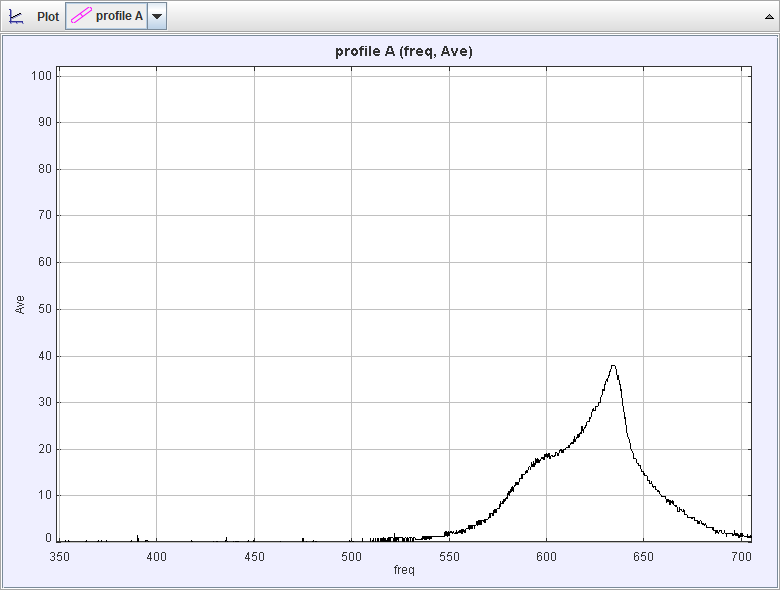
Measurements/Calibration/outputs/Average/7RA.png
