appletonN/FYP/Measurements/Calibration/outputs/Average/9LG.png

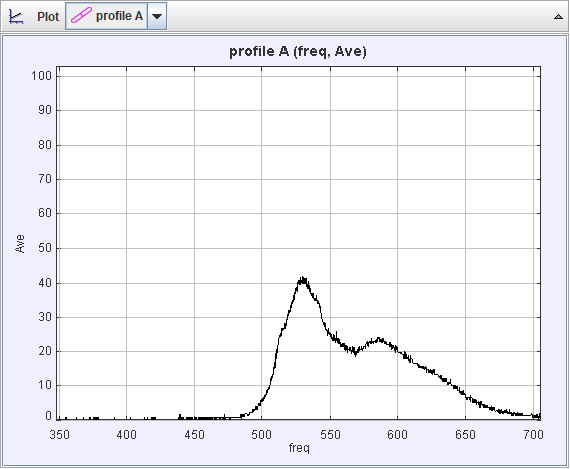
Measurements/Calibration/outputs/Average/9LG.png
