appletonN/FYP/Measurements/Calibration/outputs/Average/10gb.png

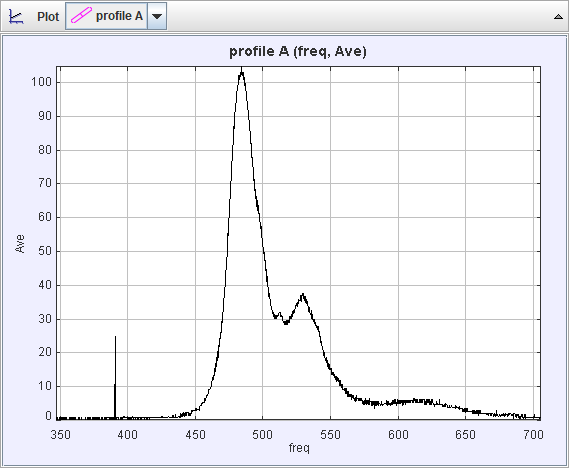
Measurements/Calibration/outputs/Average/10gb.png
