appletonN/FYP/Measurements/Calibration/outputs/Average/11BRb.png

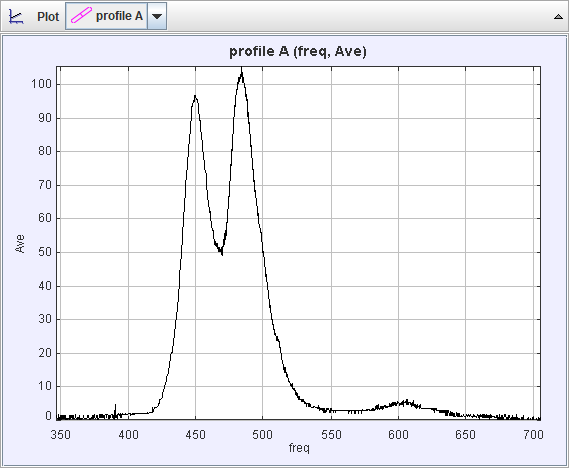
Measurements/Calibration/outputs/Average/11BRb.png
