appletonN/FYP/Measurements/Calibration/outputs/Average/All_RGB_Ave.png

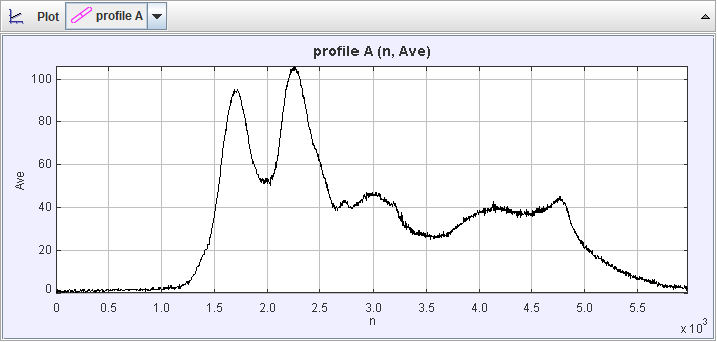
Measurements/Calibration/outputs/Average/All_RGB_Ave.png
