appletonN/FYP/Measurements/Calibration/outputs/luma/1Red.png

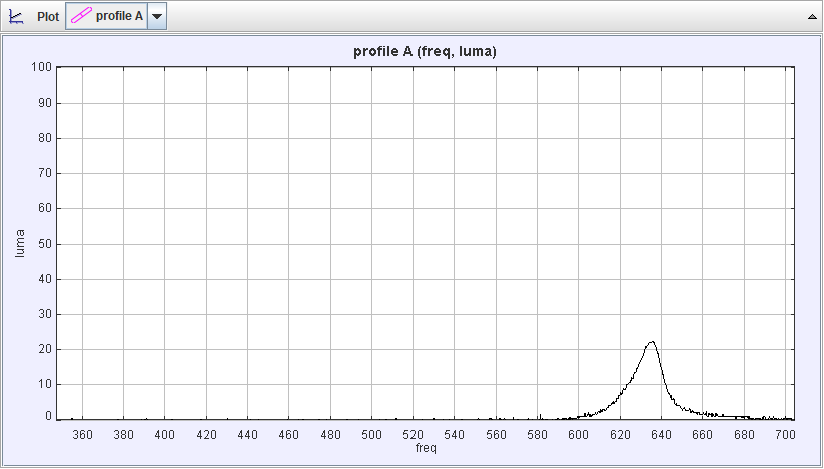
Measurements/Calibration/outputs/luma/1Red.png
