appletonN/FYP/Measurements/Calibration/outputs/luma/3Lime.png

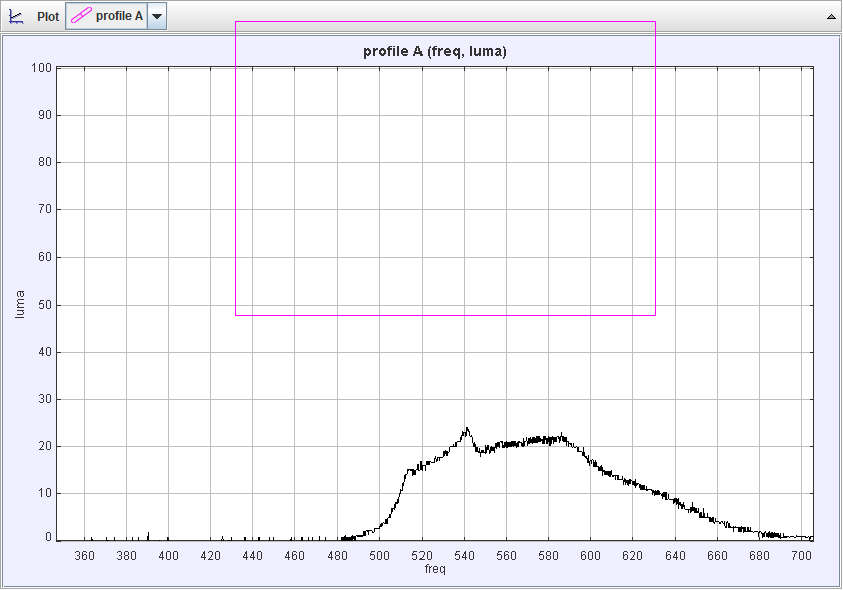
Measurements/Calibration/outputs/luma/3Lime.png
