appletonN/FYP/Measurements/Calibration/outputs/luma/4green.png

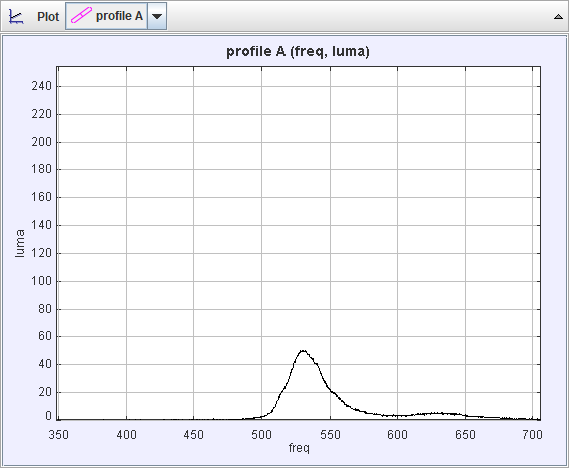
Measurements/Calibration/outputs/luma/4green.png
