appletonN/FYP/Measurements/Calibration/outputs/luma/6rblue.png

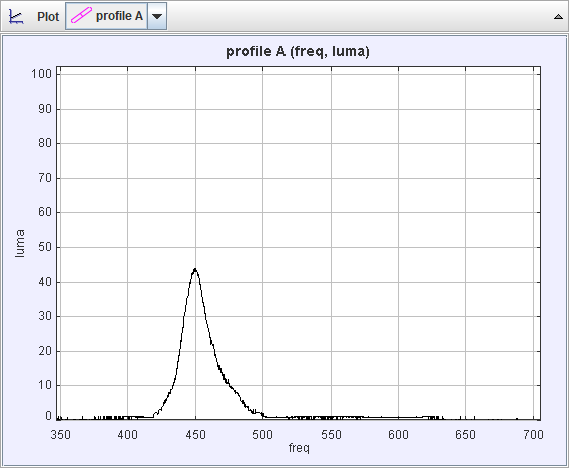
Measurements/Calibration/outputs/luma/6rblue.png
