appletonN/FYP/Measurements/Calibration/outputs/luma/8red&Amber.png

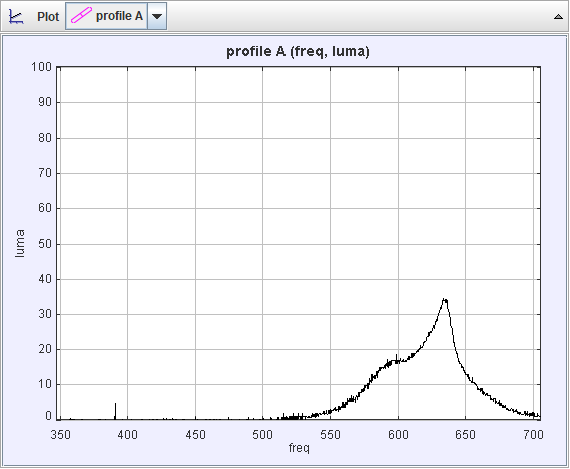
Measurements/Calibration/outputs/luma/8red&Amber.png
