appletonN/FYP/Measurements/Calibration/outputs/luma/10Lime&green.png

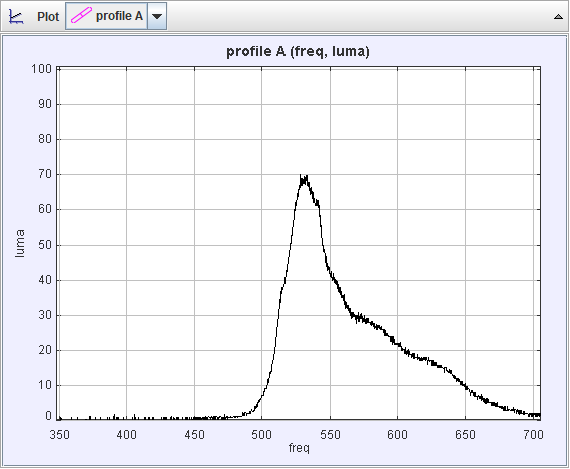
Measurements/Calibration/outputs/luma/10Lime&green.png
