appletonN/FYP/Measurements/Calibration/outputs/luma/11green&blue.png

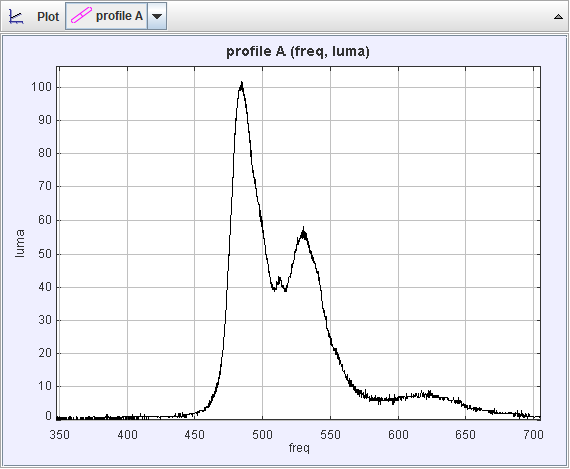
Measurements/Calibration/outputs/luma/11green&blue.png
