appletonN/FYP/Measurements/Calibration/outputs/luma/12blur&Rblue.png

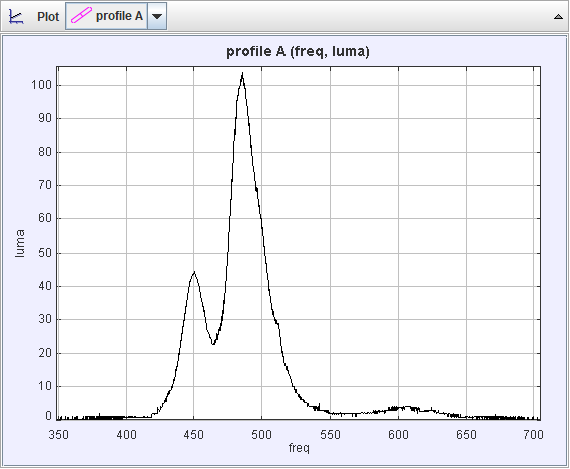
Measurements/Calibration/outputs/luma/12blur&Rblue.png
