appletonN/FYP/Measurements/Calibration/outputs/luma/14Red-lime.png

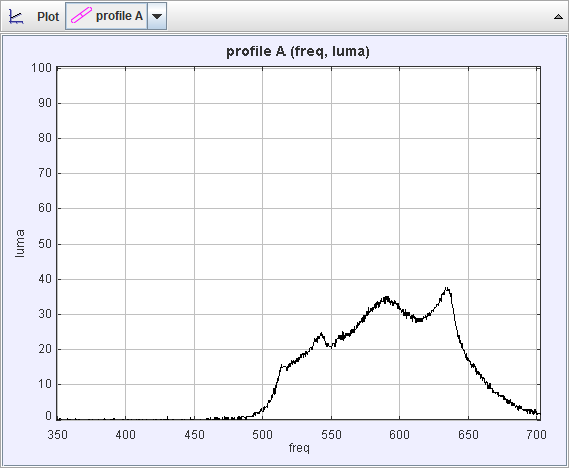
Measurements/Calibration/outputs/luma/14Red-lime.png
