appletonN/FYP/Measurements/Calibration/outputs/luma/16lime-blue.png

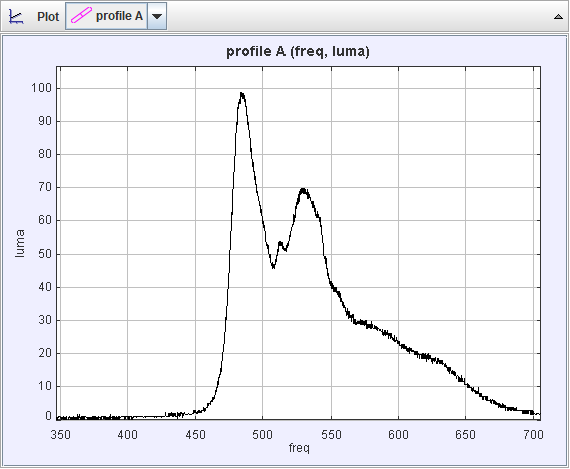
Measurements/Calibration/outputs/luma/16lime-blue.png
