appletonN/FYP/Measurements/Calibration/outputs/luma/17green-Rblue.png

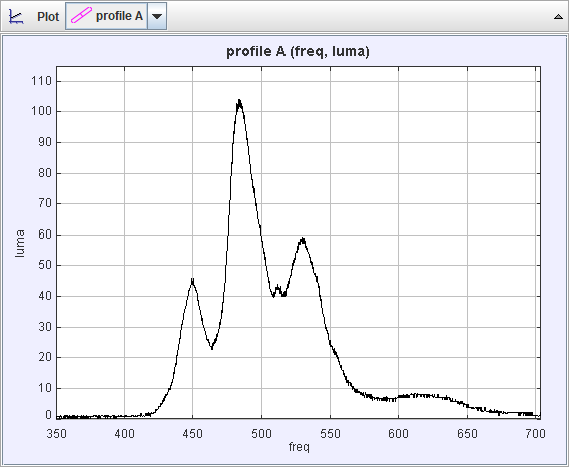
Measurements/Calibration/outputs/luma/17green-Rblue.png
