appletonN/FYP/Measurements/Calibration/outputs/luma/18HSFred-Amber.png

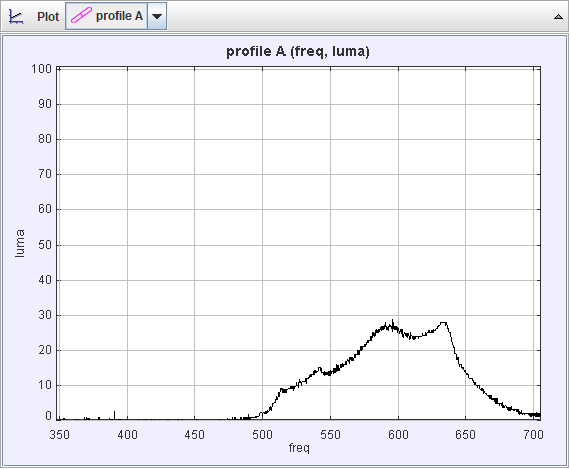
Measurements/Calibration/outputs/luma/18HSFred-Amber.png
