appletonN/FYP/Measurements/Calibration/outputs/luma/19HSRed-lime.png

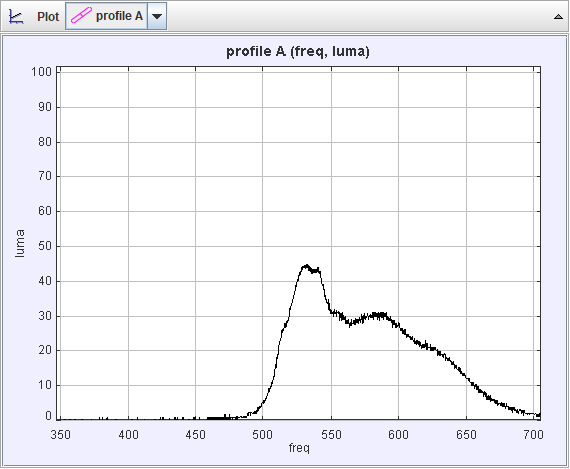
Measurements/Calibration/outputs/luma/19HSRed-lime.png
