appletonN/FYP/Measurements/Calibration/outputs/luma/20lime-Blue.png

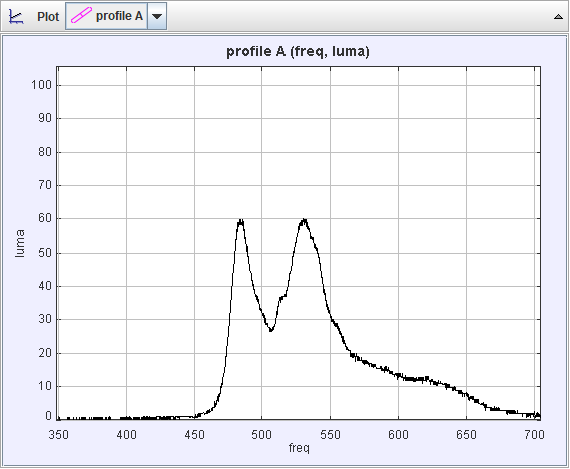
Measurements/Calibration/outputs/luma/20lime-Blue.png
