appletonN/FYP/Measurements/Calibration/outputs/luma/21green-Rblue.png

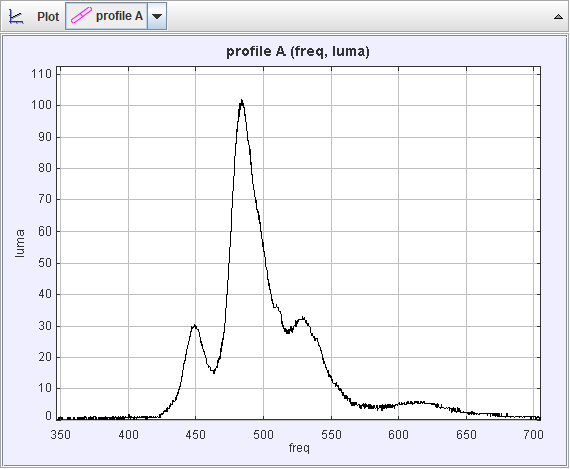
Measurements/Calibration/outputs/luma/21green-Rblue.png
