appletonN/FYP/Measurements/Calibration/outputs/luma/22blue-Rb.png

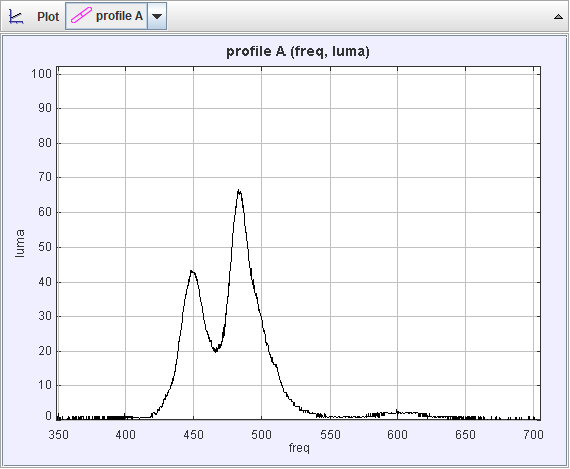
Measurements/Calibration/outputs/luma/22blue-Rb.png
