appletonN/FYP/Measurements/Calibration/outputs/luma/25HMamber-green.png

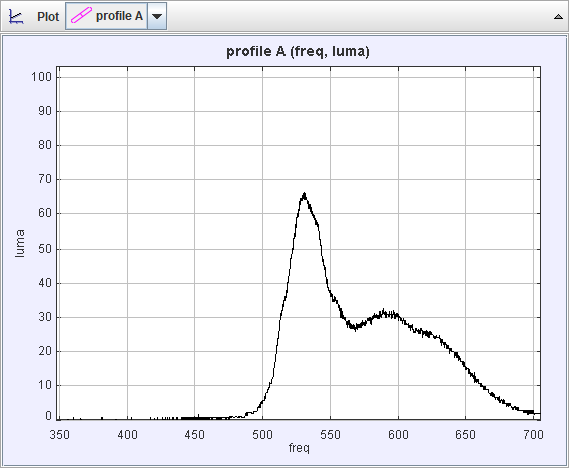
Measurements/Calibration/outputs/luma/25HMamber-green.png
