appletonN/FYP/Measurements/Calibration/outputs/luma/28blue-Rblue.png

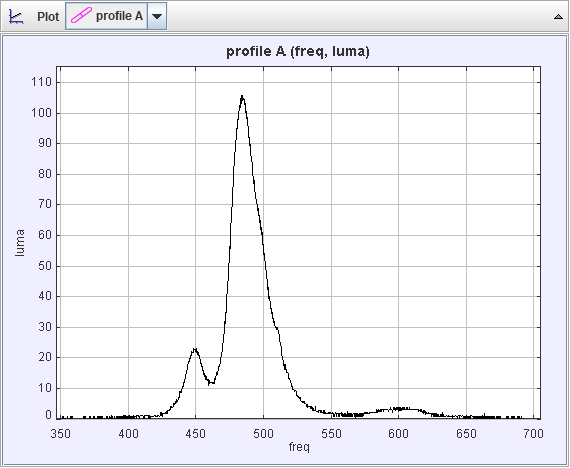
Measurements/Calibration/outputs/luma/28blue-Rblue.png
