appletonN/FYP/Measurements/Calibration/outputs/luma/32QSlime-blue.png

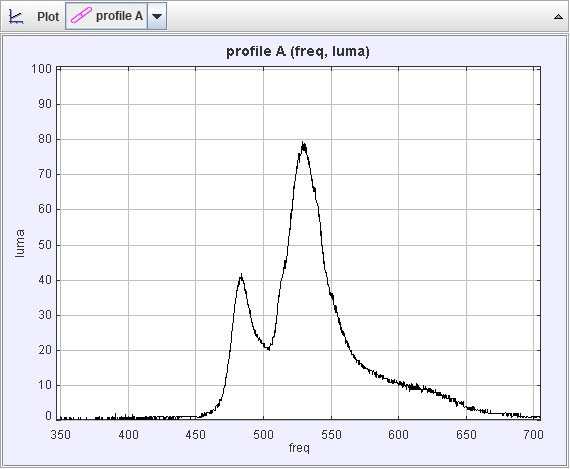
Measurements/Calibration/outputs/luma/32QSlime-blue.png
