appletonN/FYP/Measurements/Calibration/outputs/luma/33QSgreen-Rblue.png

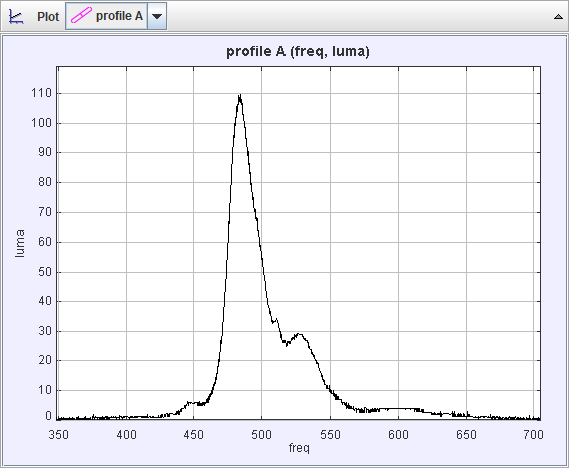
Measurements/Calibration/outputs/luma/33QSgreen-Rblue.png
