appletonN/FYP/Measurements/Calibration/outputs/luma/34QSblue-Rblue.png

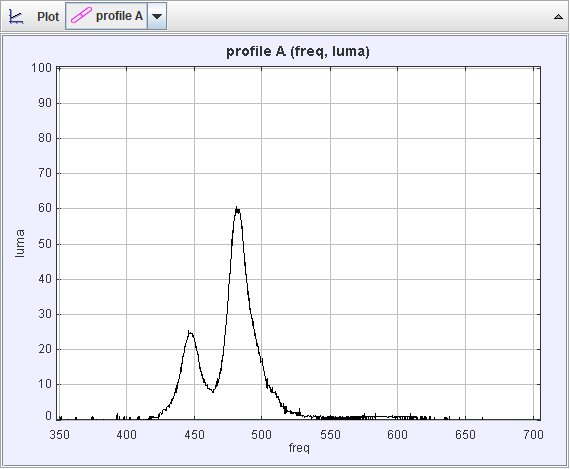
Measurements/Calibration/outputs/luma/34QSblue-Rblue.png
