appletonN/FYP/Measurements/Calibration/outputs/luma/35QSFred-amber.png

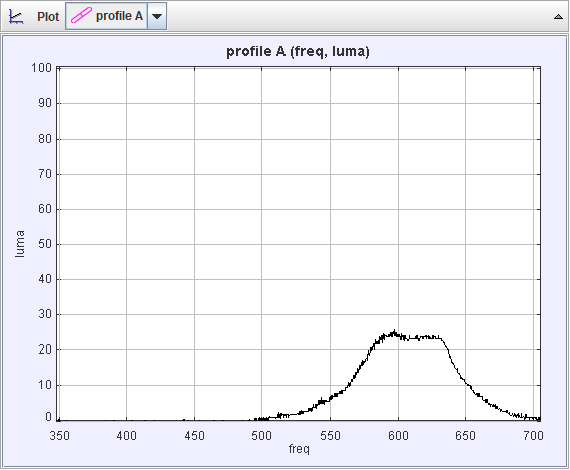
Measurements/Calibration/outputs/luma/35QSFred-amber.png
