appletonN/FYP/Measurements/Calibration/outputs/luma/37QMamber-green.png

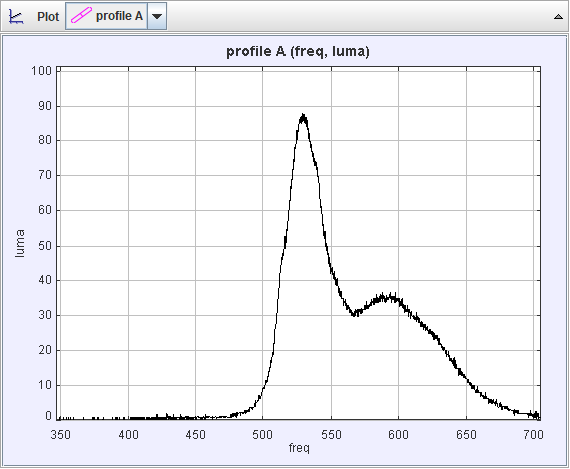
Measurements/Calibration/outputs/luma/37QMamber-green.png
