appletonN/FYP/Measurements/Calibration/outputs/luma/39green-rblue.png

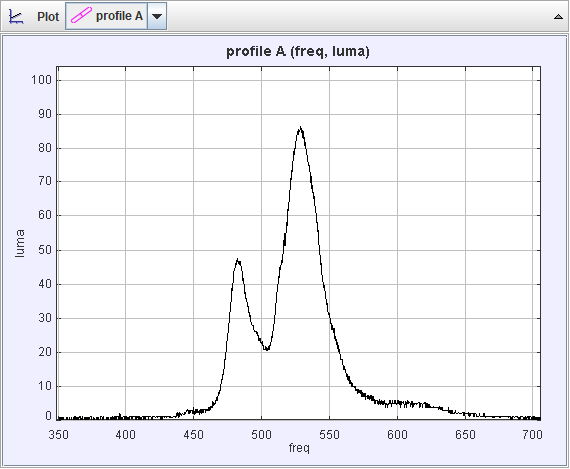
Measurements/Calibration/outputs/luma/39green-rblue.png
