appletonN/FYP/Measurements/Calibration/outputs/luma/AlarmLamp.png

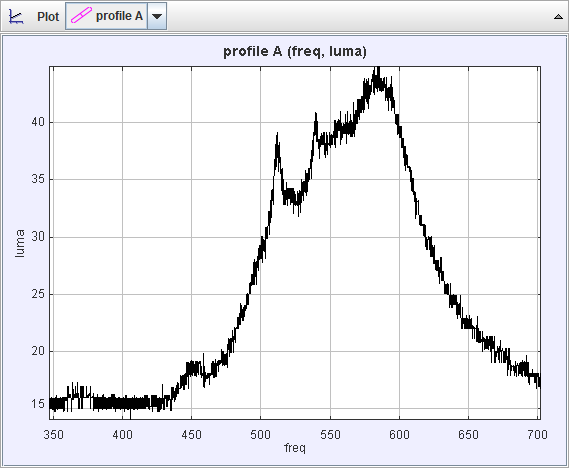
Measurements/Calibration/outputs/luma/AlarmLamp.png
