appletonN/FYP/Measurements/Calibration/outputs/luma/all-on.png

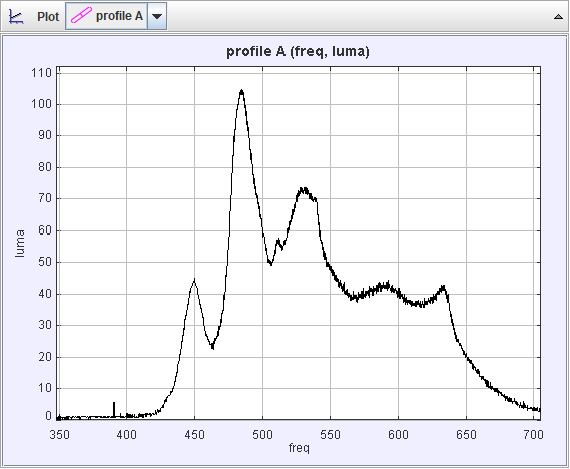
Measurements/Calibration/outputs/luma/all-on.png
