appletonN/FYP/Measurements/Desired/Measured/HighQuality/1.Morning.JPG

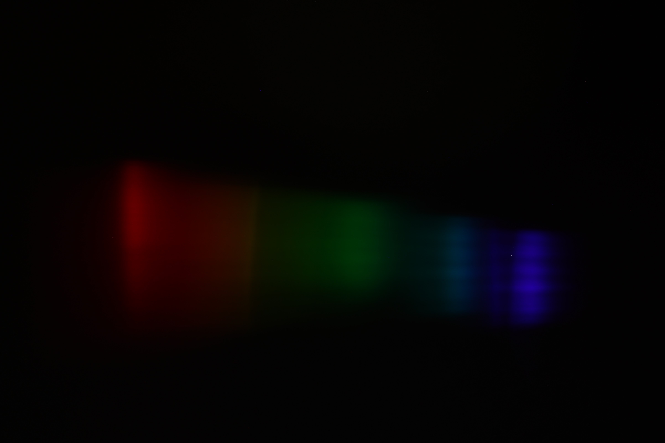
Measurements/Desired/Measured/HighQuality/1.Morning.JPG
