appletonN/FYP/Measurements/Desired/Measured/HighQuality/2.Afternoon.JPG

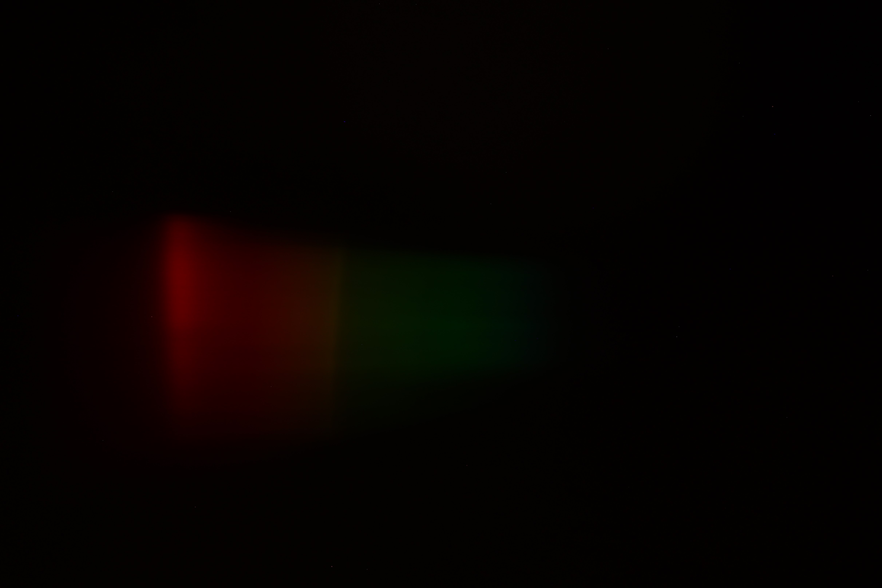
Measurements/Desired/Measured/HighQuality/2.Afternoon.JPG
