appletonN/FYP/Measurements/Desired/Measured/HighQuality/3.Evening.JPG

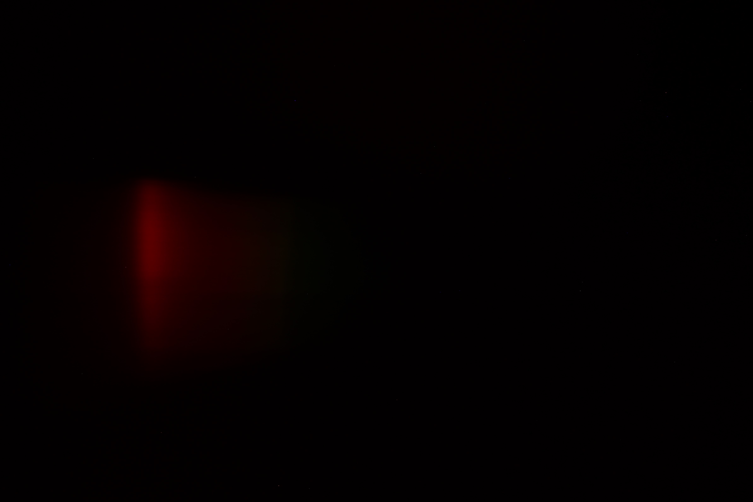
Measurements/Desired/Measured/HighQuality/3.Evening.JPG
