appletonN/FYP/Measurements/Desired/Measured/HighQuality/Calibrated.png

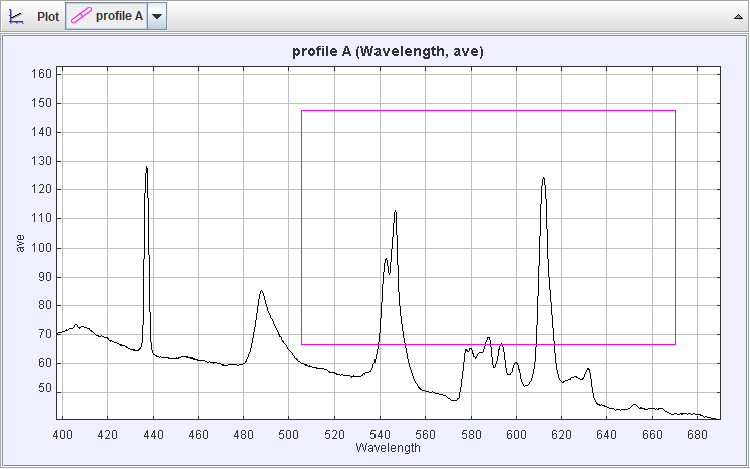
Measurements/Desired/Measured/HighQuality/Calibrated.png
