appletonN/FYP/Measurements/Desired/Measured/HighQuality/CFL1.jpg

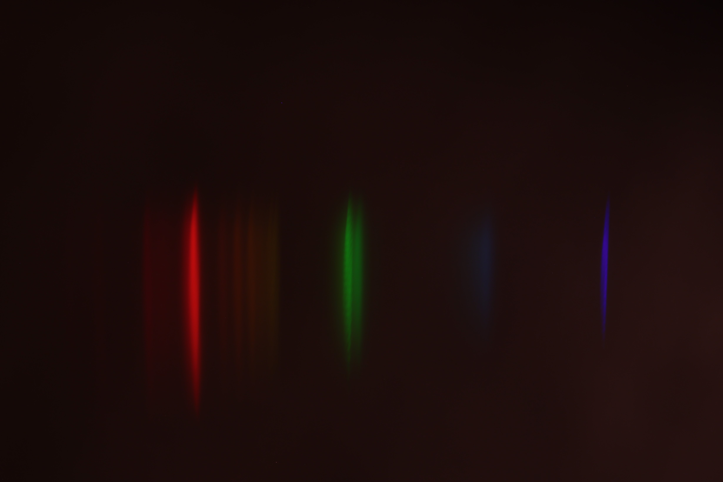
Measurements/Desired/Measured/HighQuality/CFL1.jpg
