appletonN/FYP/Measurements/Desired/Measured/HighQuality/CFL.JPG

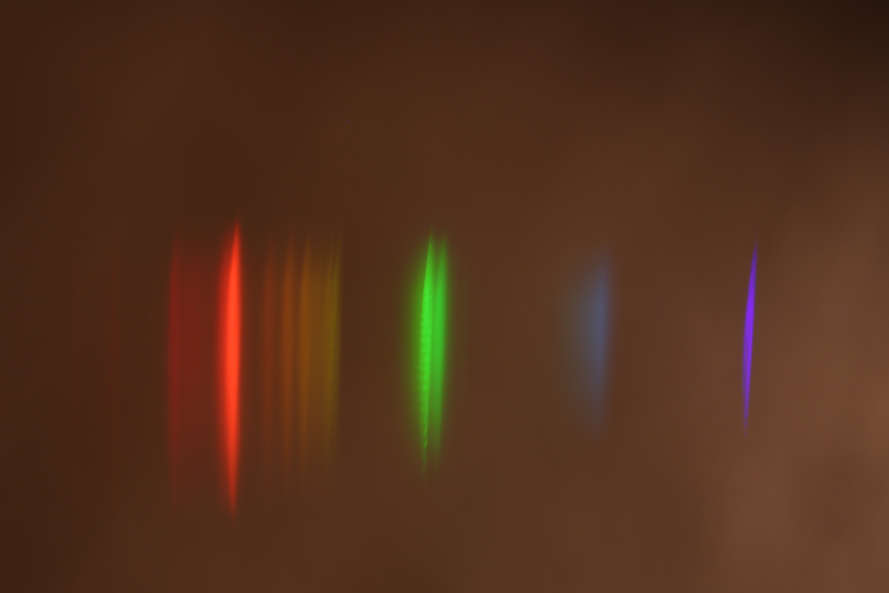
Measurements/Desired/Measured/HighQuality/CFL.JPG
