appletonN/FYP/Measurements/Desired/Measured/HighQuality/Output/1.Morning.JPG

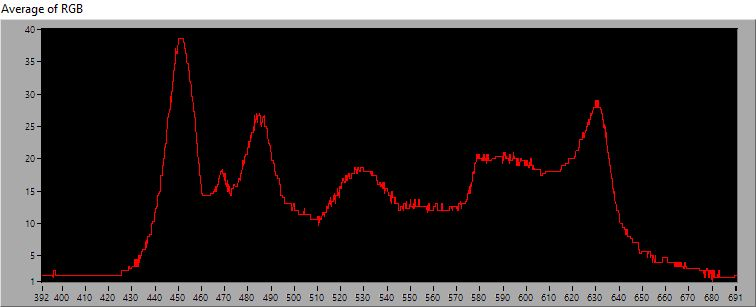
Measurements/Desired/Measured/HighQuality/Output/1.Morning.JPG
