appletonN/FYP/Measurements/Desired/Measured/HighQuality/Output/2.Afternoon.JPG

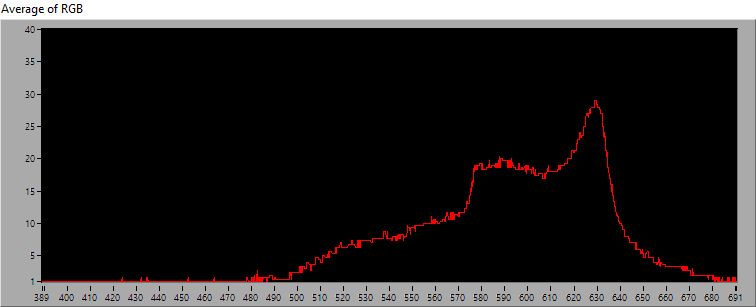
Measurements/Desired/Measured/HighQuality/Output/2.Afternoon.JPG
