appletonN/FYP/Measurements/Desired/Measured/HighQuality/Output/3.Evening.JPG

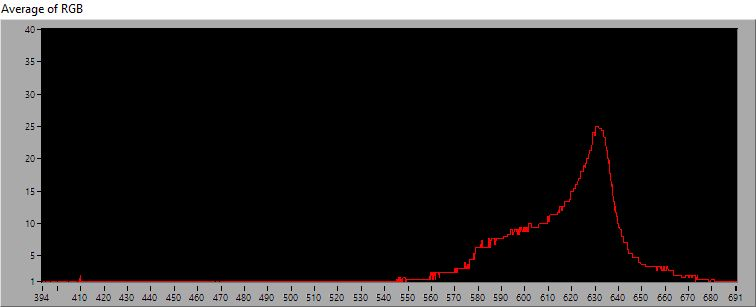
Measurements/Desired/Measured/HighQuality/Output/3.Evening.JPG
