appletonN/FYP/Measurements/Desired/Measured/HighQuality/Output/4.Night.JPG

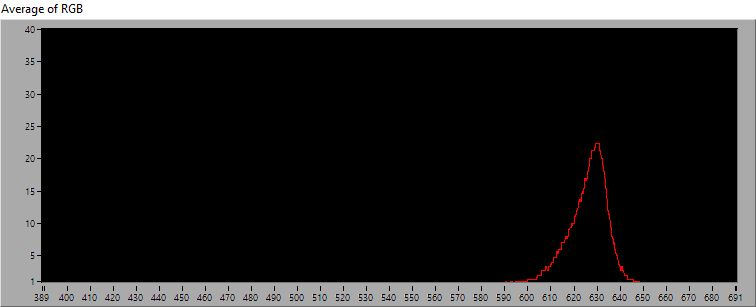
Measurements/Desired/Measured/HighQuality/Output/4.Night.JPG
