appletonN/FYP/Measurements/Desired/Measured/HighQuality/Output/CFL1.jpg

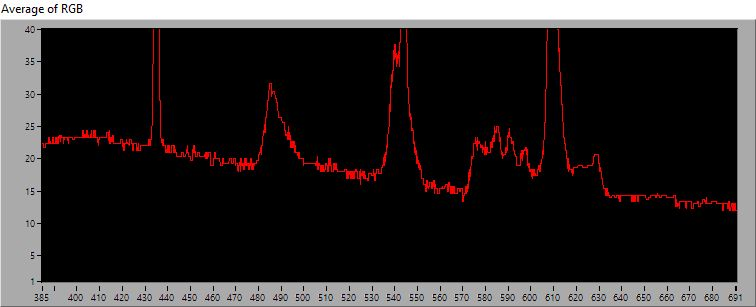
Measurements/Desired/Measured/HighQuality/Output/CFL1.jpg
