appletonN/FYP/Measurements/Desired/Measured/HighQuality/Output/CFL.JPG

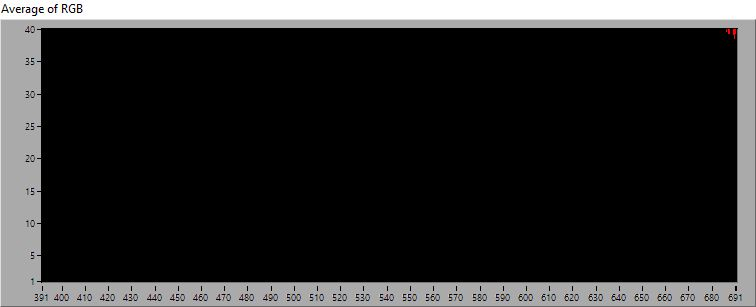
Measurements/Desired/Measured/HighQuality/Output/CFL.JPG
