appletonN/FYP/Measurements/Desired/Measured/LowQuality/IMG_1649.JPG

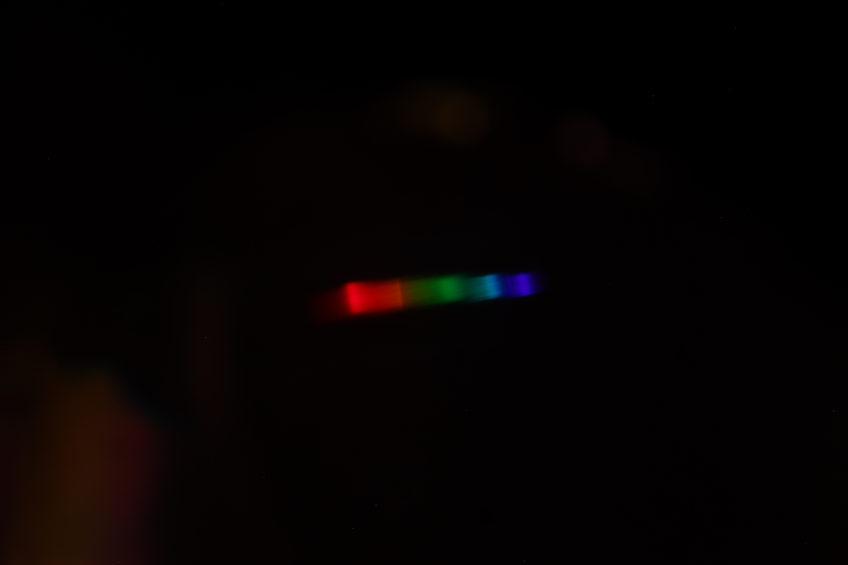
Measurements/Desired/Measured/LowQuality/IMG_1649.JPG
