appletonN/FYP/Measurements/Desired/Measured/LowQuality/IMG_1651.JPG

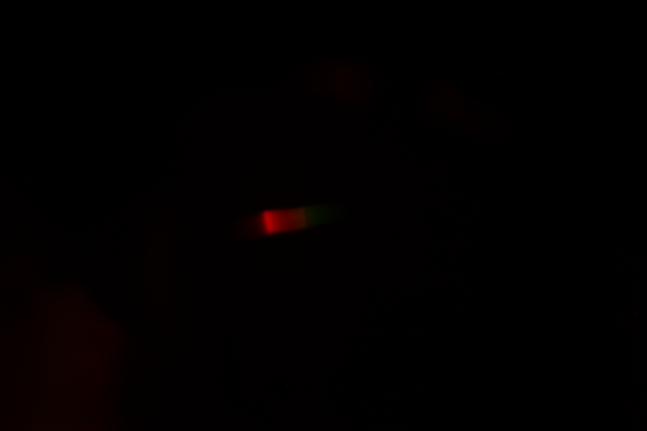
Measurements/Desired/Measured/LowQuality/IMG_1651.JPG
