appletonN/FYP/Measurements/Desired/Measured/LowQuality/IMG_1652.JPG

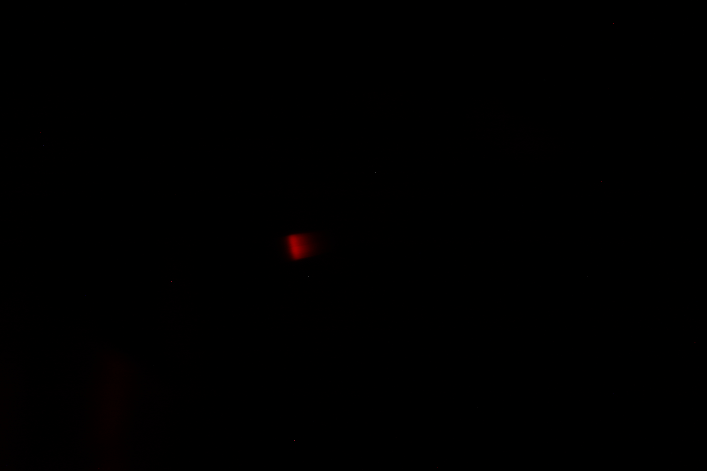
Measurements/Desired/Measured/LowQuality/IMG_1652.JPG
