appletonN/FYP/Measurements/Desired/Measured/LowQuality/IMG_1653.JPG

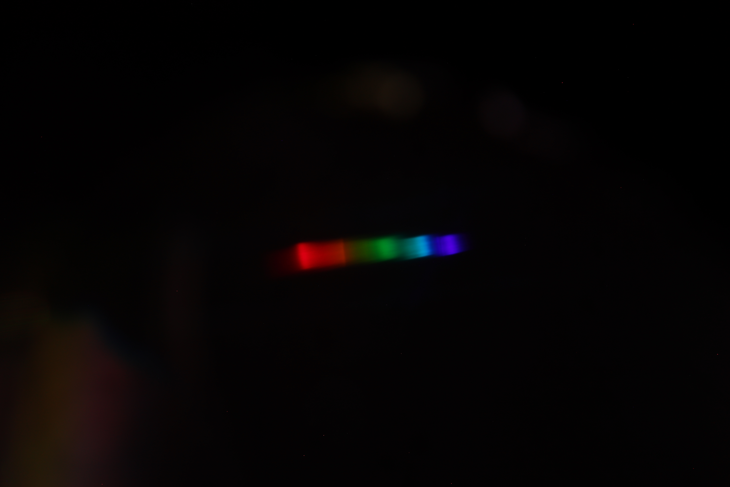
Measurements/Desired/Measured/LowQuality/IMG_1653.JPG
