appletonN/FYP/Measurements/Desired/Measured/LowQuality/IMG_1655.JPG

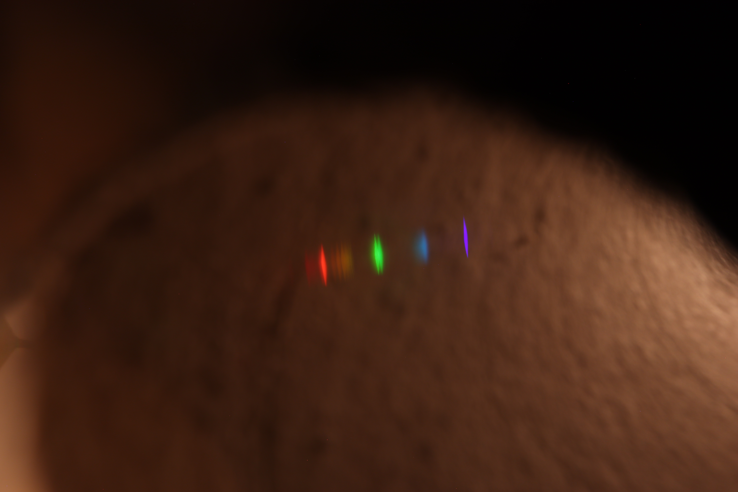
Measurements/Desired/Measured/LowQuality/IMG_1655.JPG
