appletonN/FYP/Measurements/Desired/Measured/Other/IMG_1638.JPG

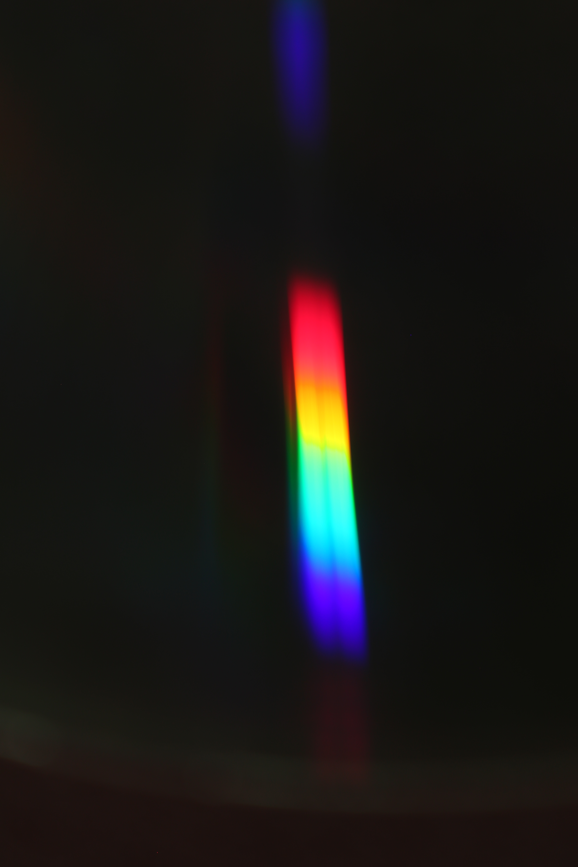
Measurements/Desired/Measured/Other/IMG_1638.JPG
