appletonN/FYP/Measurements/Desired/Measured/Other/IMG_1639.JPG

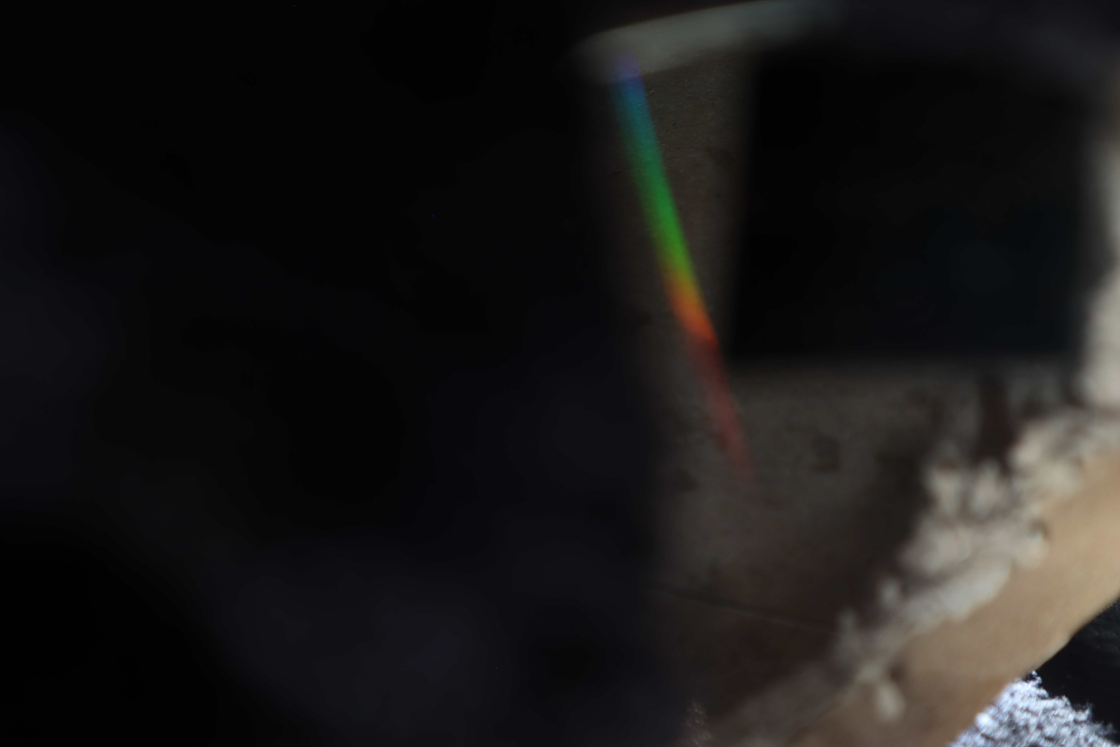
Measurements/Desired/Measured/Other/IMG_1639.JPG
