appletonN/FYP/Measurements/Desired/Measured/Other/IMG_1641.JPG

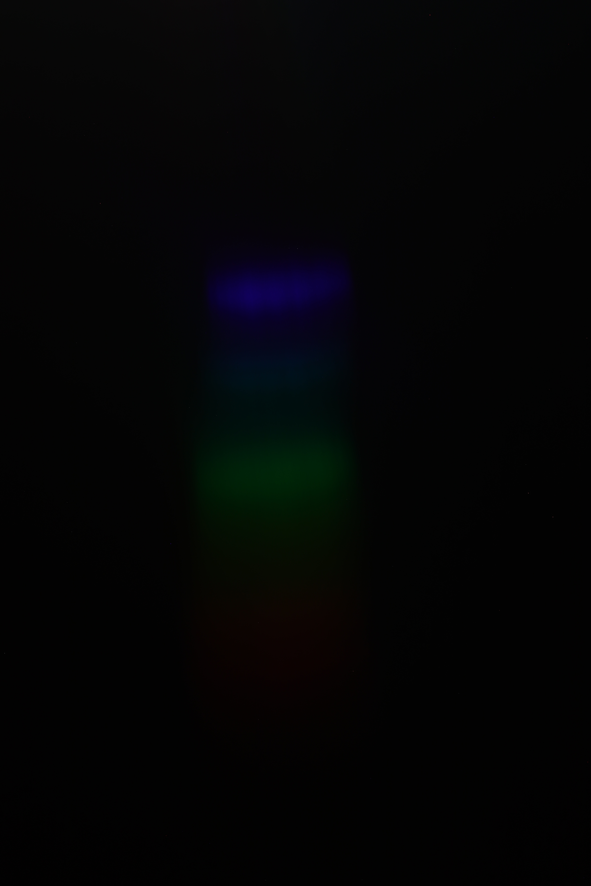
Measurements/Desired/Measured/Other/IMG_1641.JPG
