appletonN/FYP/Measurements/Desired/Measured/Other/IMG_1642.JPG

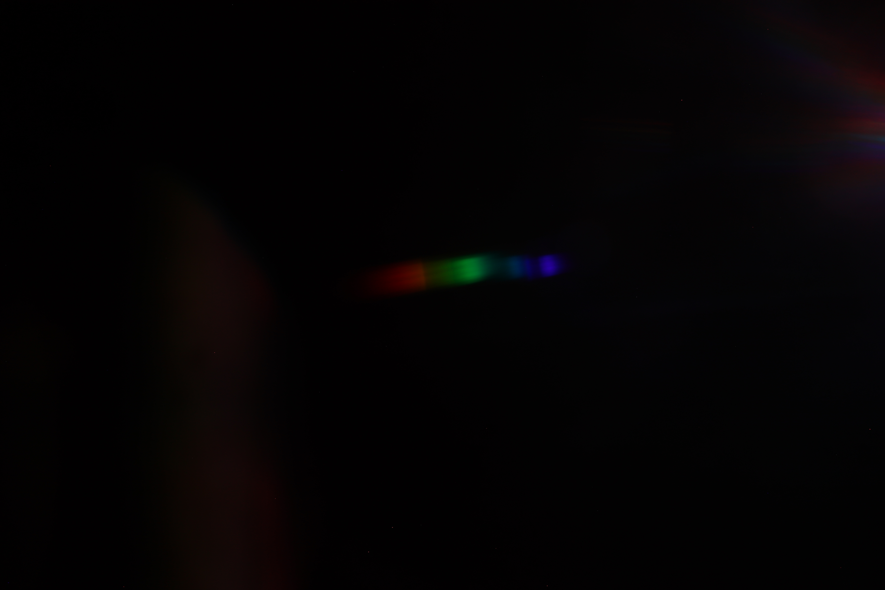
Measurements/Desired/Measured/Other/IMG_1642.JPG
