appletonN/FYP/Measurements/Desired/Measured/Other/IMG_1643.JPG

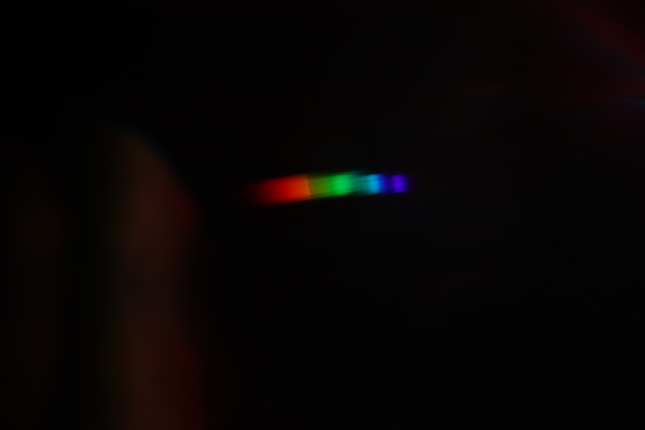
Measurements/Desired/Measured/Other/IMG_1643.JPG
