appletonN/FYP/Measurements/Desired/Measured/Other/IMG_1645.JPG

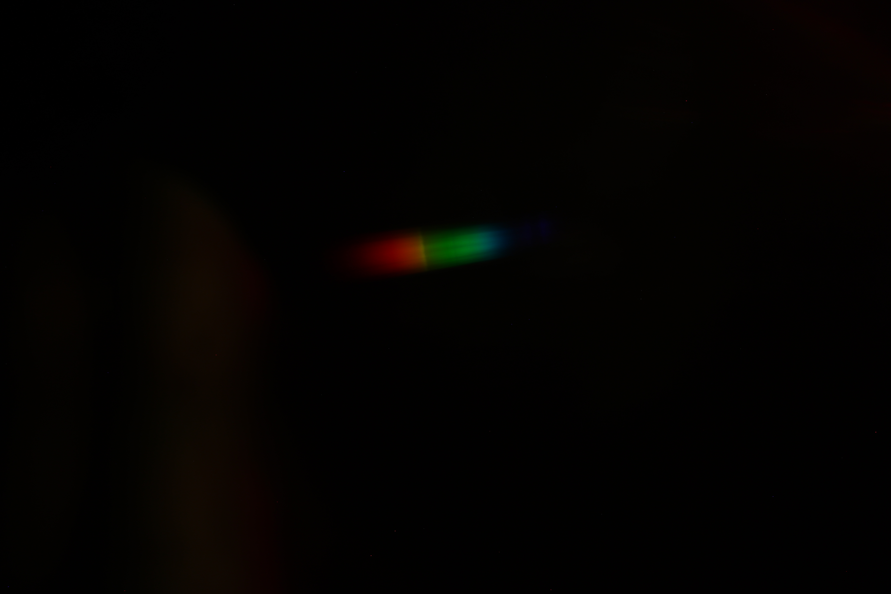
Measurements/Desired/Measured/Other/IMG_1645.JPG
