appletonN/FYP/Measurements/Desired/Measured/Other/IMG_1646.JPG

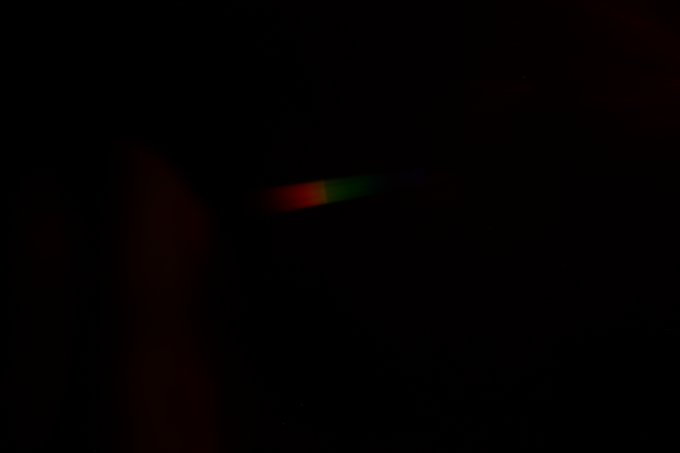
Measurements/Desired/Measured/Other/IMG_1646.JPG
