appletonN/FYP/Measurements/Desired/Measured/Other/IMG_1657.JPG

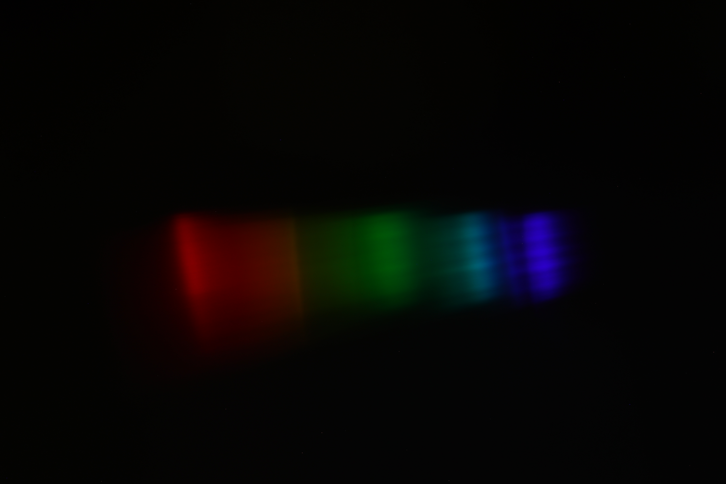
Measurements/Desired/Measured/Other/IMG_1657.JPG
