appletonN/FYP/Measurements/Desired/Measured/Other/IMG_1658.JPG

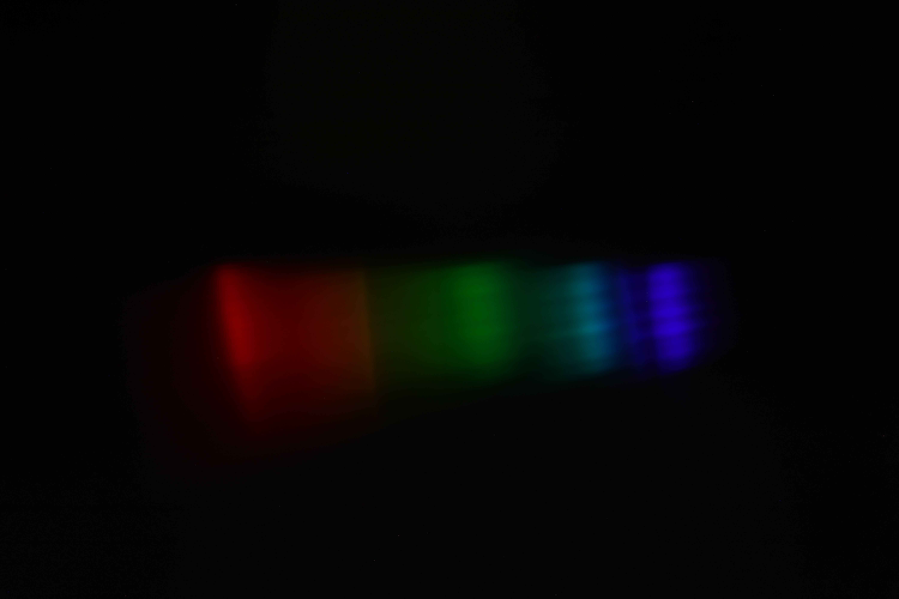
Measurements/Desired/Measured/Other/IMG_1658.JPG
