appletonN/FYP/Measurements/Desired/Measured/Other/IMG_1664.JPG

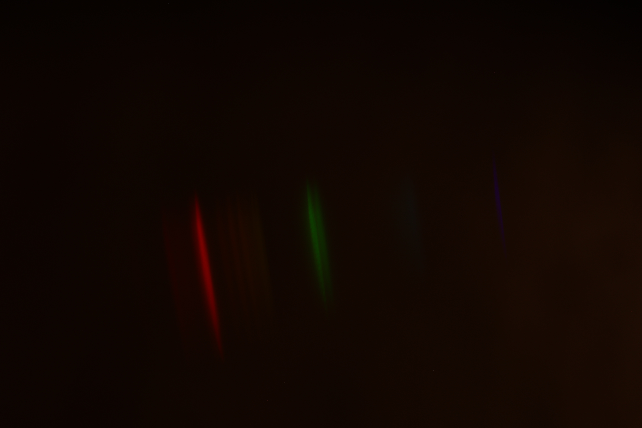
Measurements/Desired/Measured/Other/IMG_1664.JPG
