appletonN/FYP/Measurements/Desired/Measured/Other/IMG_1665.JPG

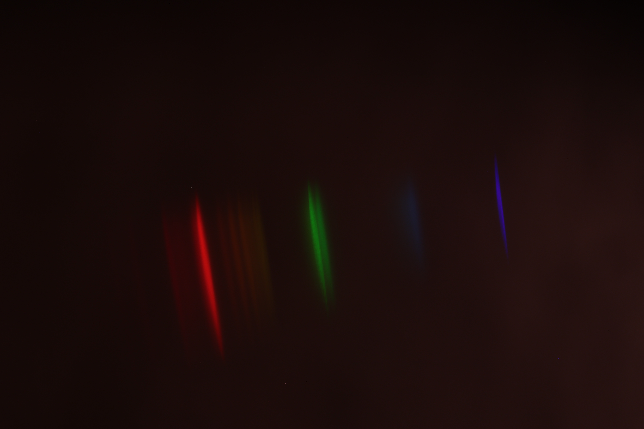
Measurements/Desired/Measured/Other/IMG_1665.JPG
