appletonN/FYP/Measurements/Desired/Measured/Other/IMG_1666.JPG

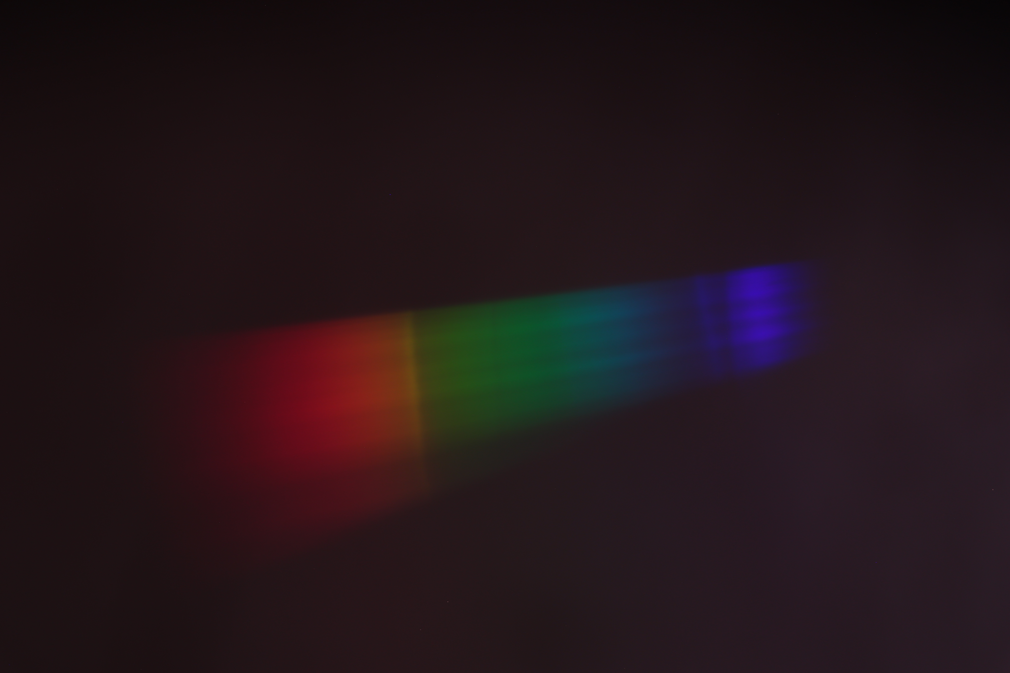
Measurements/Desired/Measured/Other/IMG_1666.JPG
