appletonN/FYP/Measurements/Desired/Measured/Other/IMG_1667.JPG

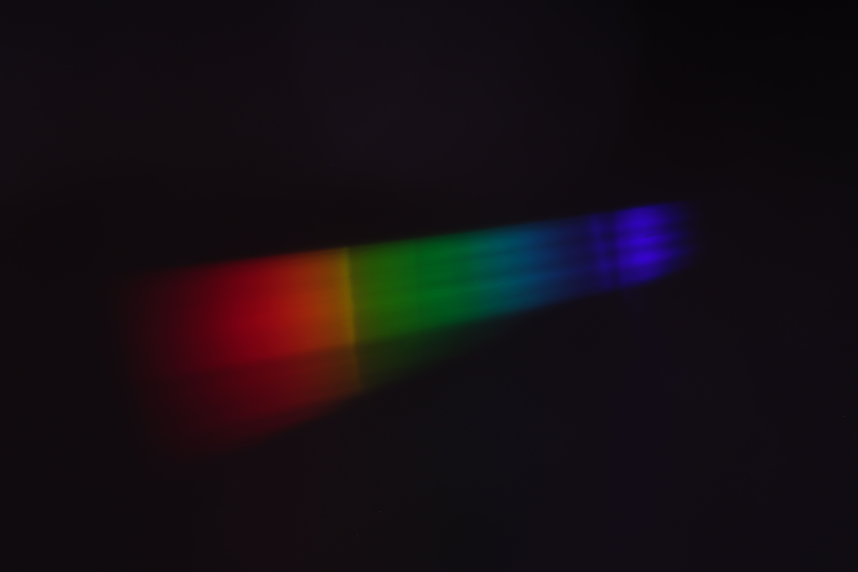
Measurements/Desired/Measured/Other/IMG_1667.JPG
