appletonN/FYP/Measurements/Desired/Measured/Other/IMG_1668.JPG

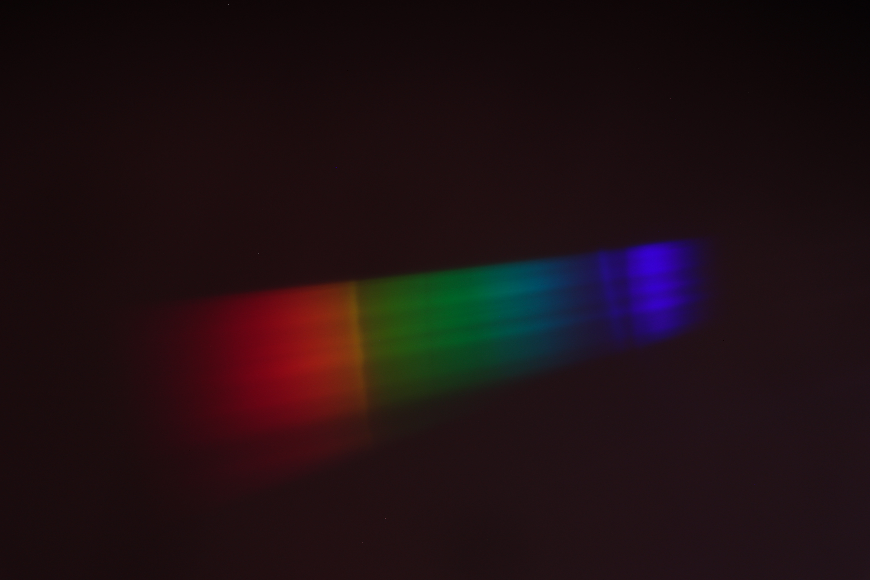
Measurements/Desired/Measured/Other/IMG_1668.JPG
