appletonN/FYP/Measurements/Desired/Simulated/Screenshot 2021-03-23 183917.png

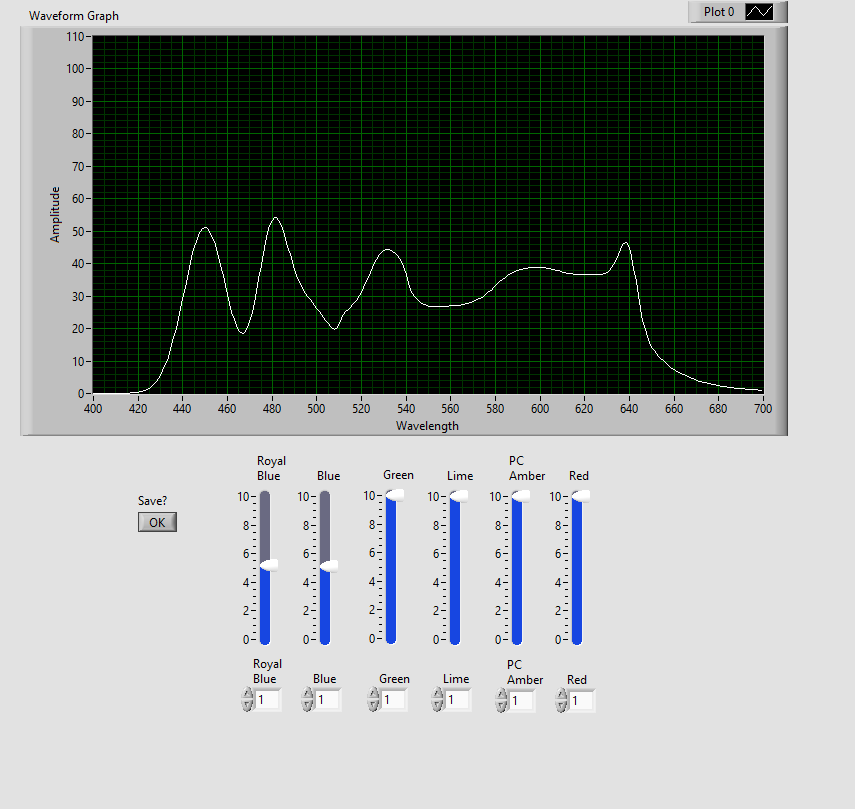
Measurements/Desired/Simulated/Screenshot 2021-03-23 183917.png
