appletonN/FYP/Measurements/Desired/Simulated/Screenshot 2021-03-23 184006.png

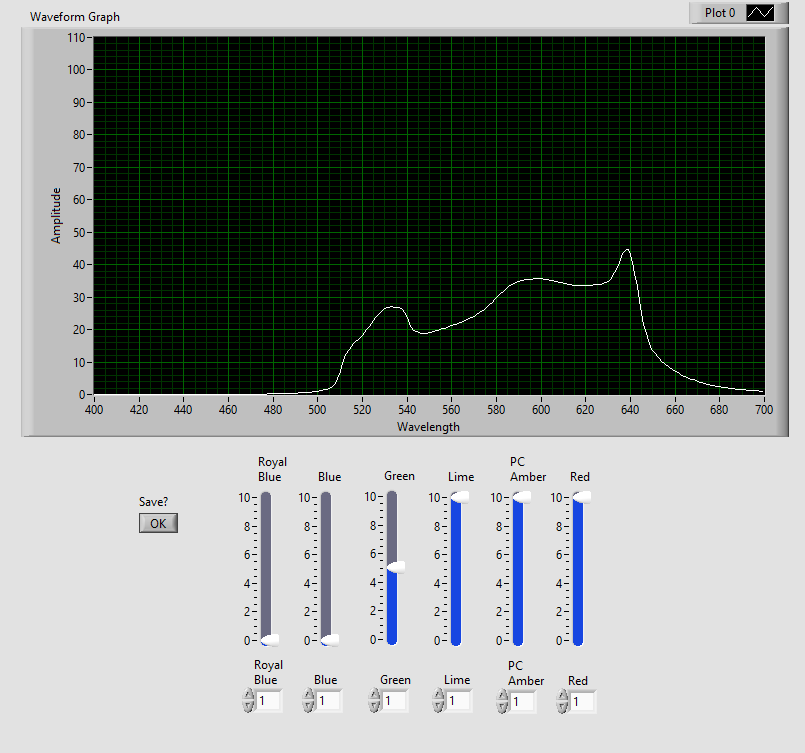
Measurements/Desired/Simulated/Screenshot 2021-03-23 184006.png
