appletonN/FYP/Measurements/Desired/Simulated/Screenshot 2021-03-23 184029.png

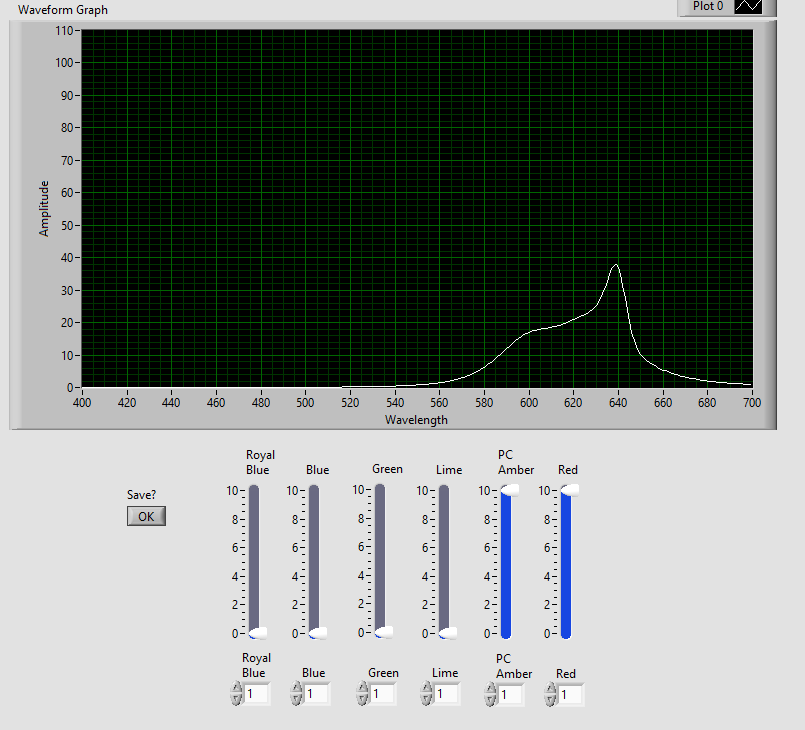
Measurements/Desired/Simulated/Screenshot 2021-03-23 184029.png
