appletonN/FYP/Measurements/IMG_1533.JPG

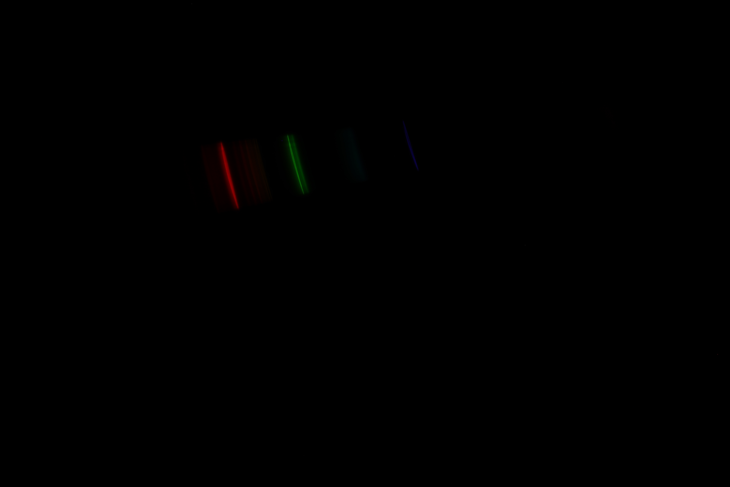
Measurements/IMG_1533.JPG
