appletonN/FYP/Measurements/IMG_1534.JPG

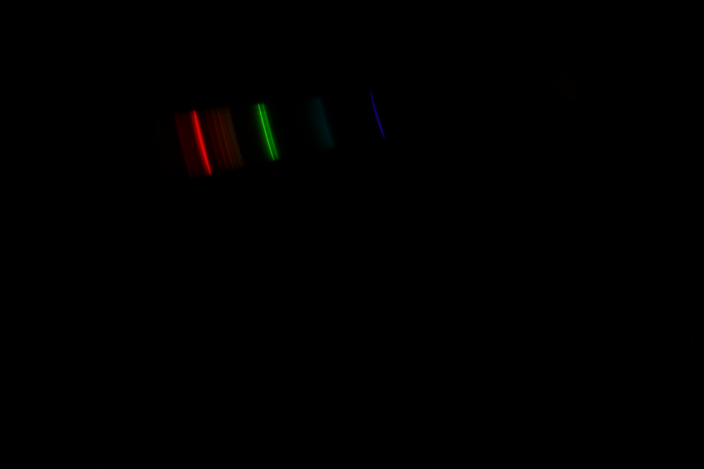
Measurements/IMG_1534.JPG
