appletonN/FYP/Measurements/IMG_1535.JPG

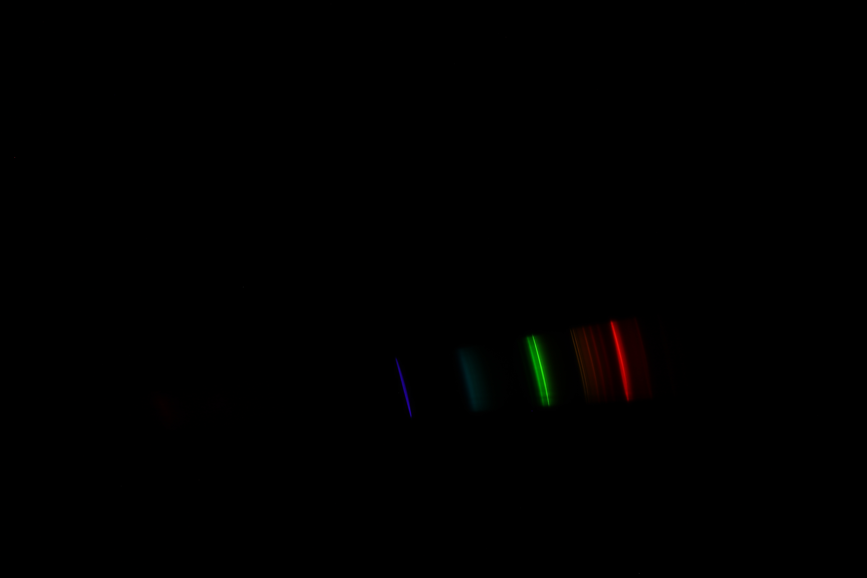
Measurements/IMG_1535.JPG
