appletonN/FYP/Measurements/IMG_1538.JPG

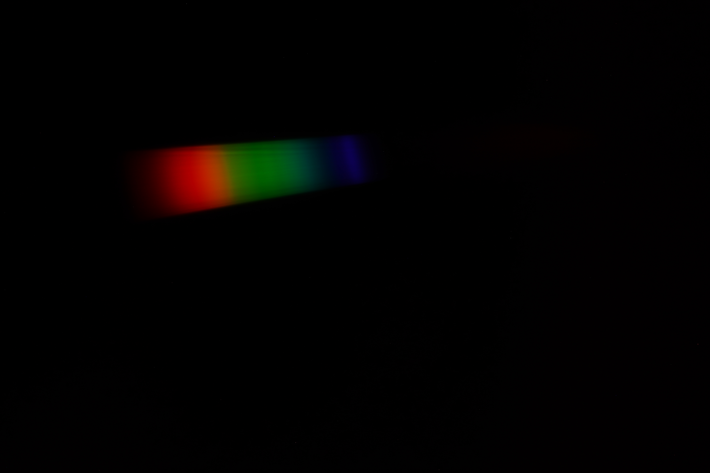
Measurements/IMG_1538.JPG
