appletonN/FYP/Measurements/IMG_1539.JPG

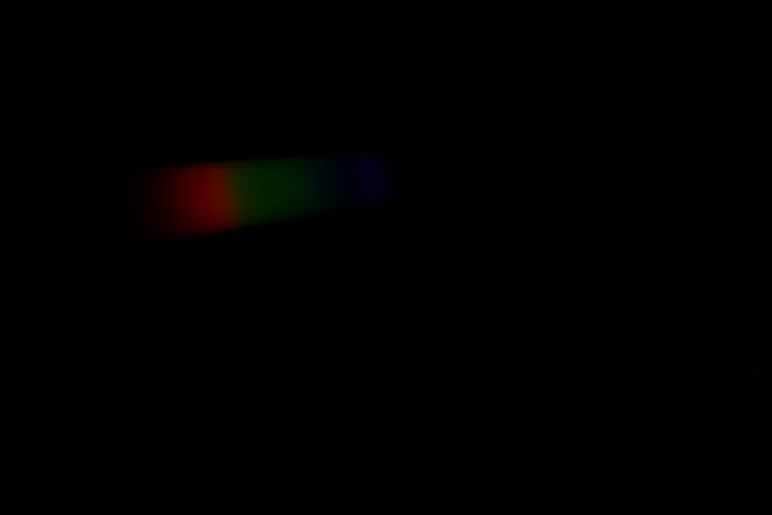
Measurements/IMG_1539.JPG
