appletonN/FYP/Measurements/IMG_1540.JPG

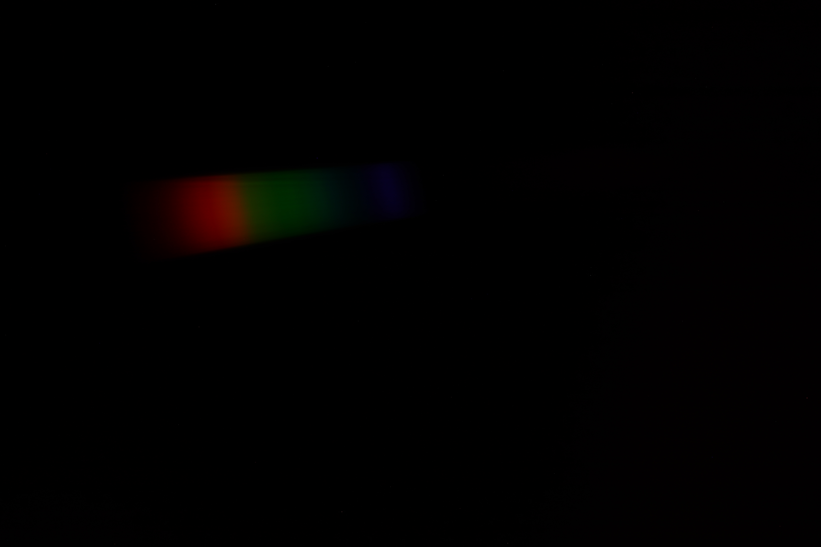
Measurements/IMG_1540.JPG
