appletonN/FYP/Measurements/IMG_1543.JPG

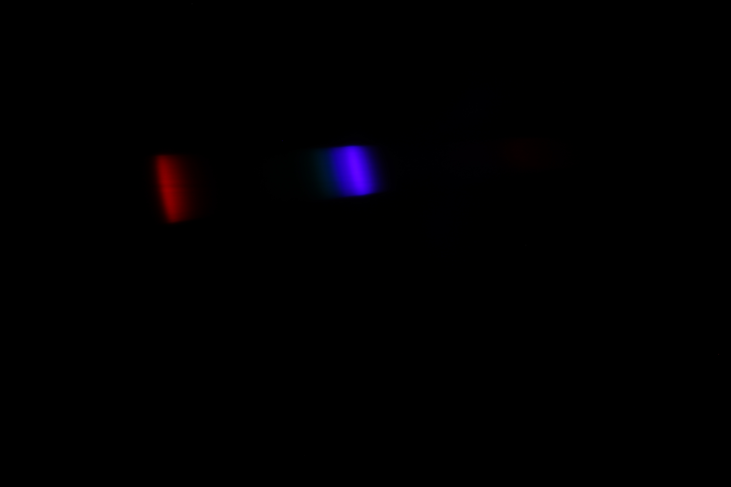
Measurements/IMG_1543.JPG
