appletonN/FYP/Measurements/Round 1/exampleResult.png

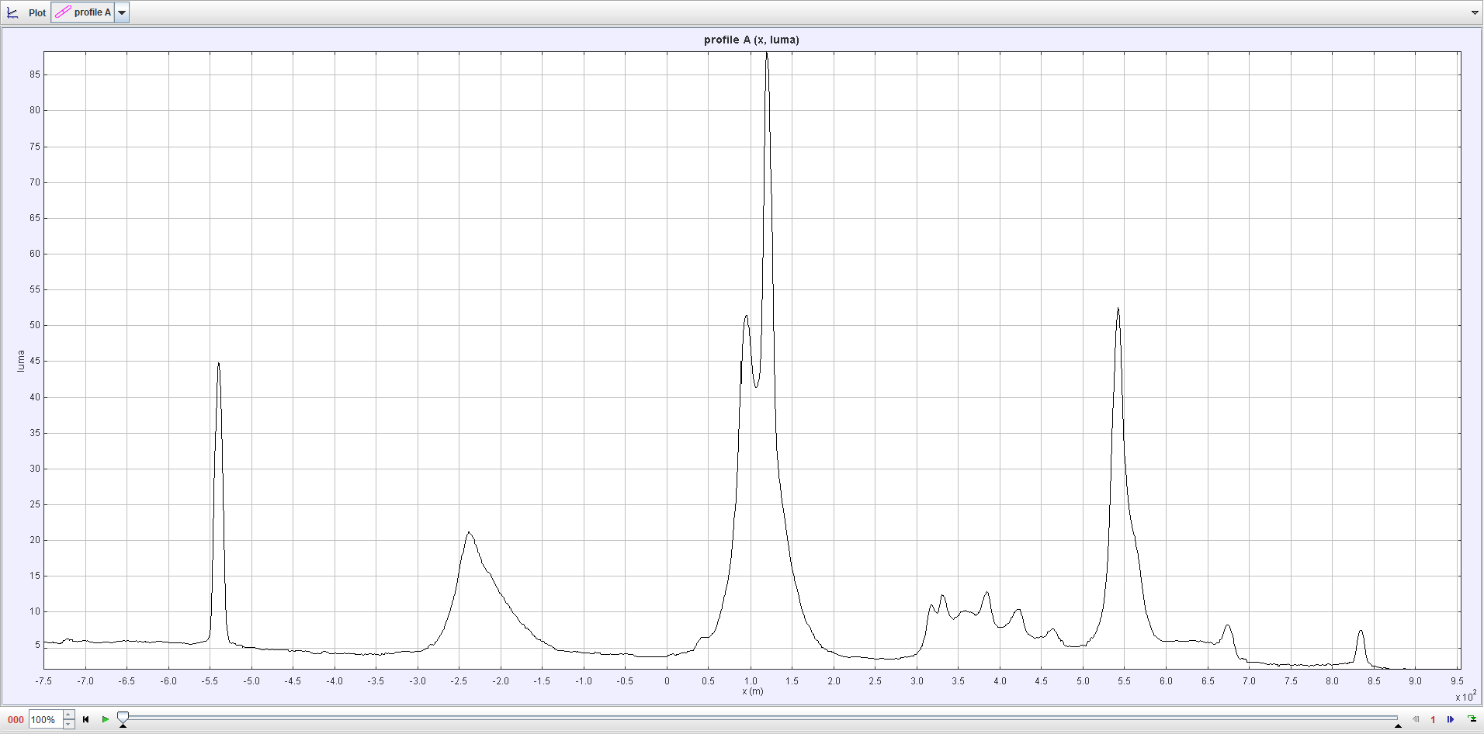
Measurements/Round 1/exampleResult.png
