appletonN/FYP/Measurements/Round 1/IMG_1389.JPG

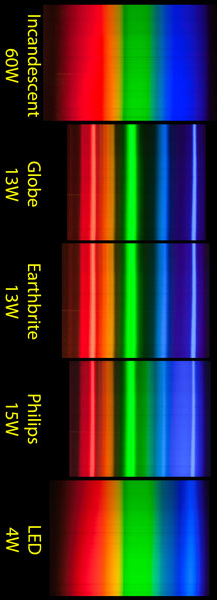
Measurements/Round 1/IMG_1389.JPG
