appletonN/FYP/Measurements/Round 1/IMG_1484.JPG

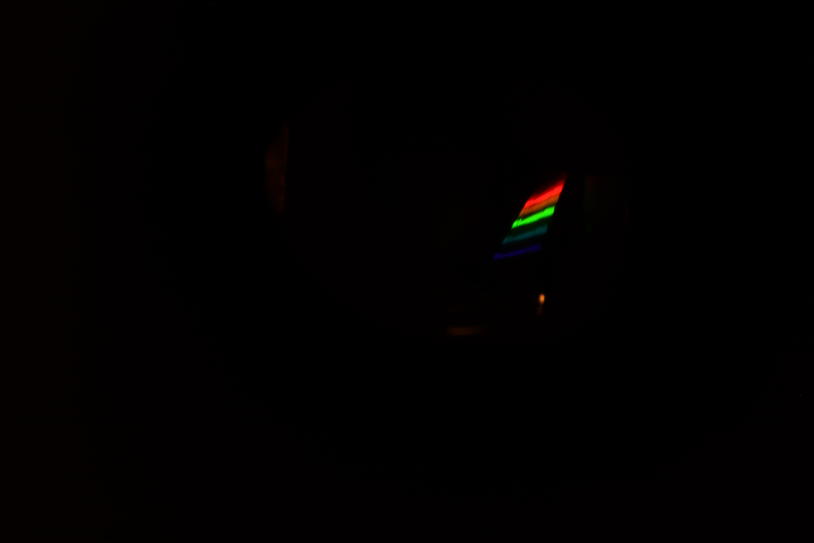
Measurements/Round 1/IMG_1484.JPG
