appletonN/FYP/Measurements/Round 1/IMG_1485.JPG

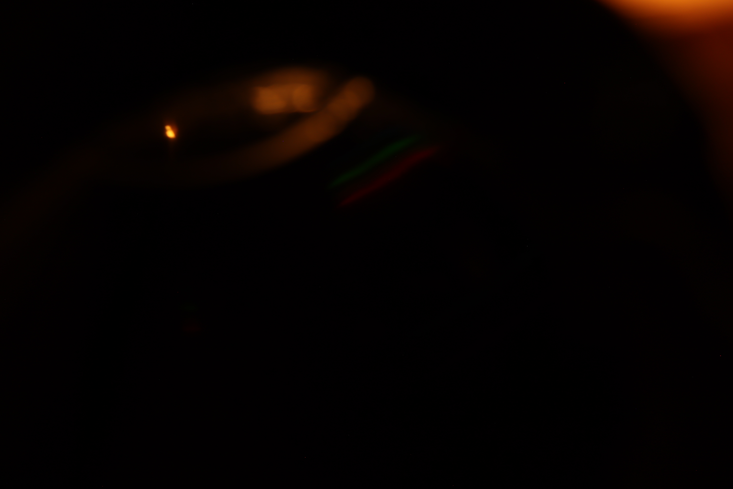
Measurements/Round 1/IMG_1485.JPG
