appletonN/FYP/Measurements/Round 1/IMG_1488.JPG

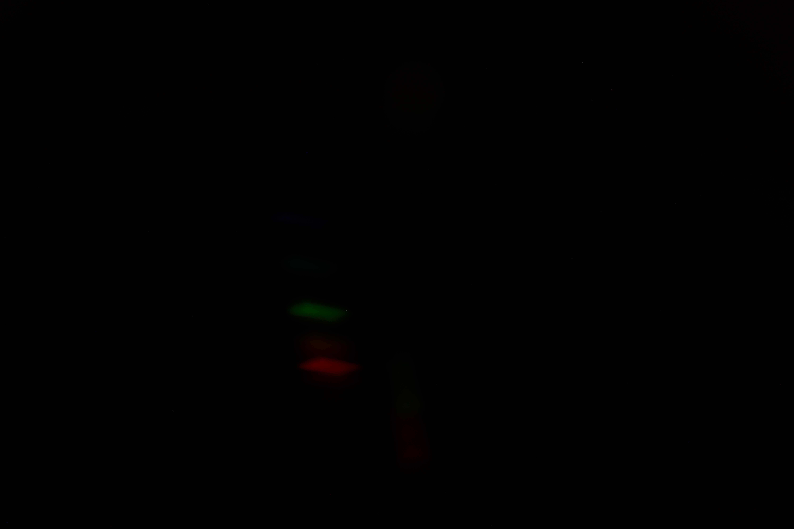
Measurements/Round 1/IMG_1488.JPG
