appletonN/FYP/Measurements/Round 1/IMG_1492.JPG

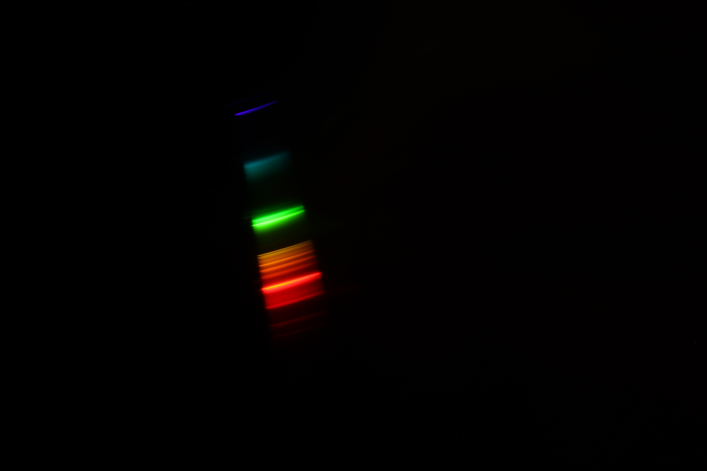
Measurements/Round 1/IMG_1492.JPG
