appletonN/FYP/Measurements/Round 1/IMG_1497.JPG

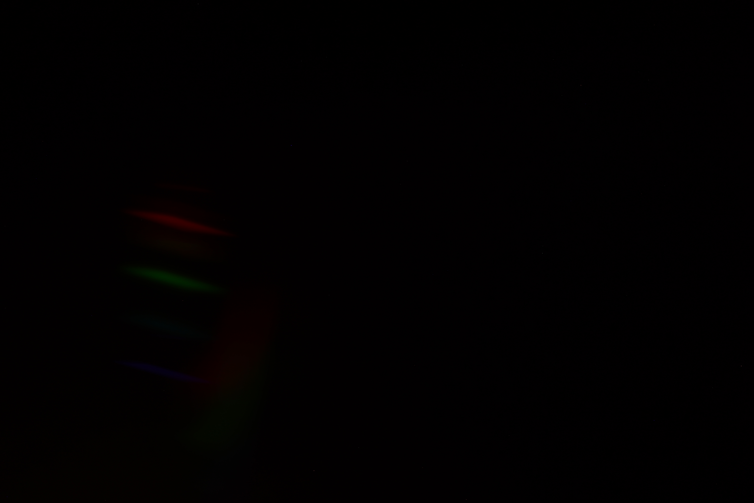
Measurements/Round 1/IMG_1497.JPG
