appletonN/FYP/Measurements/Round 1/IMG_1498.JPG

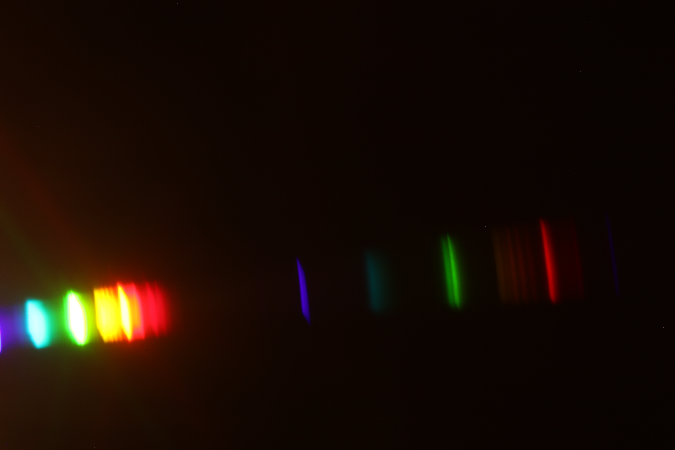
Measurements/Round 1/IMG_1498.JPG
