appletonN/FYP/Measurements/Round 1/IMG_1507.JPG

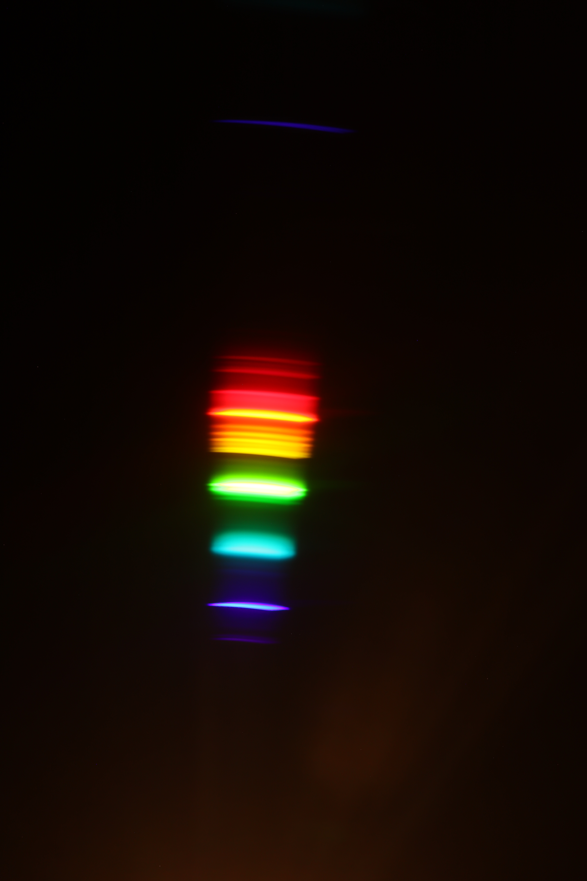
Measurements/Round 1/IMG_1507.JPG
