appletonN/FYP/Measurements/Round 1/IMG_1509.JPG

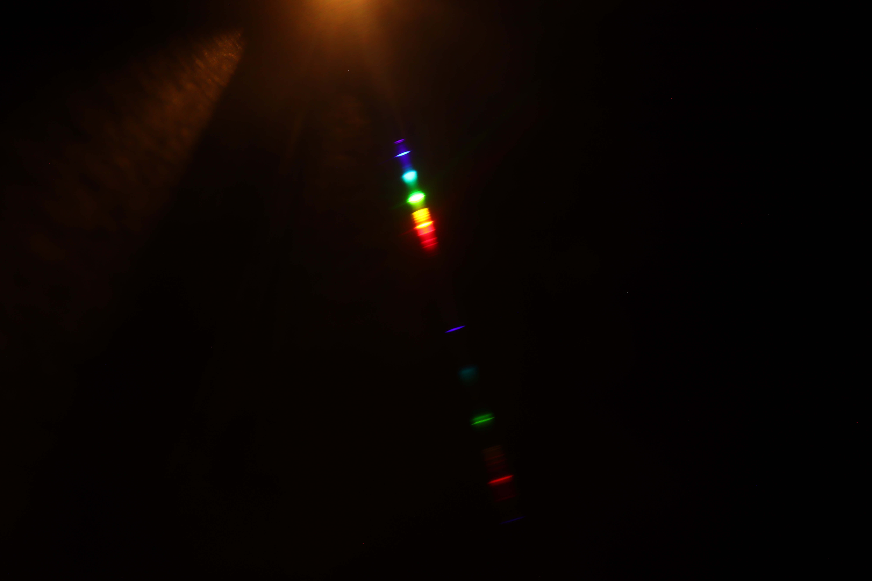
Measurements/Round 1/IMG_1509.JPG
