appletonN/FYP/Measurements/Round 1/IMG_15091.jpg

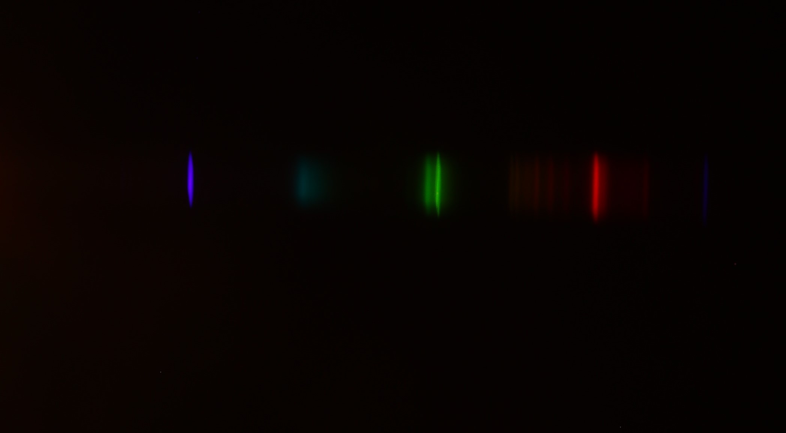
Measurements/Round 1/IMG_15091.jpg
