appletonN/FYP/documents/Final Report/PDFs/sch.pdf

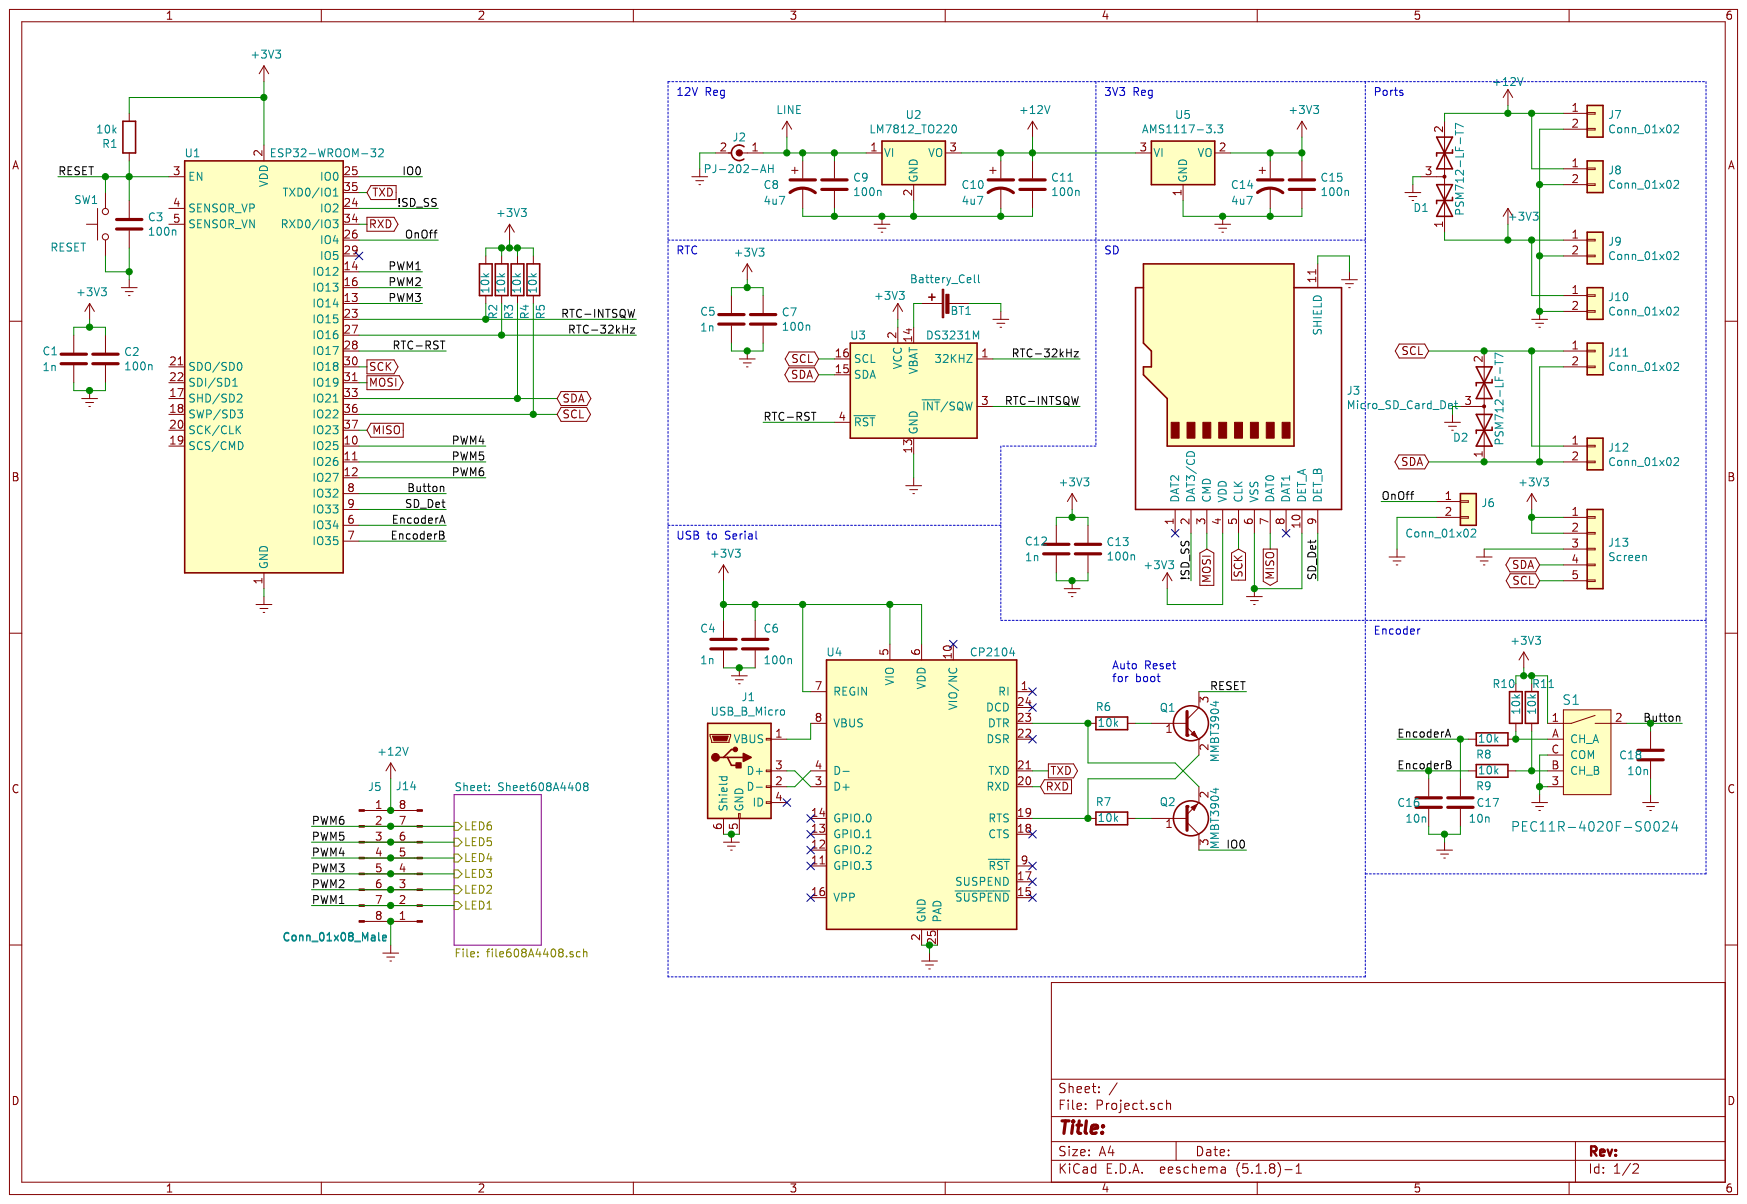
[picture p387: page 1]

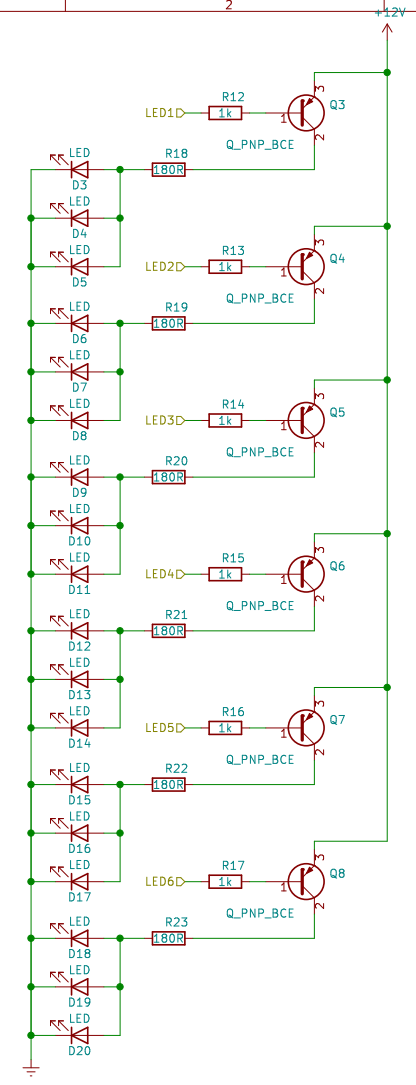
[picture p388: page 2]
