appletonN/FYP/documents/Final Report/PDFs/VI1.pdf

110

40

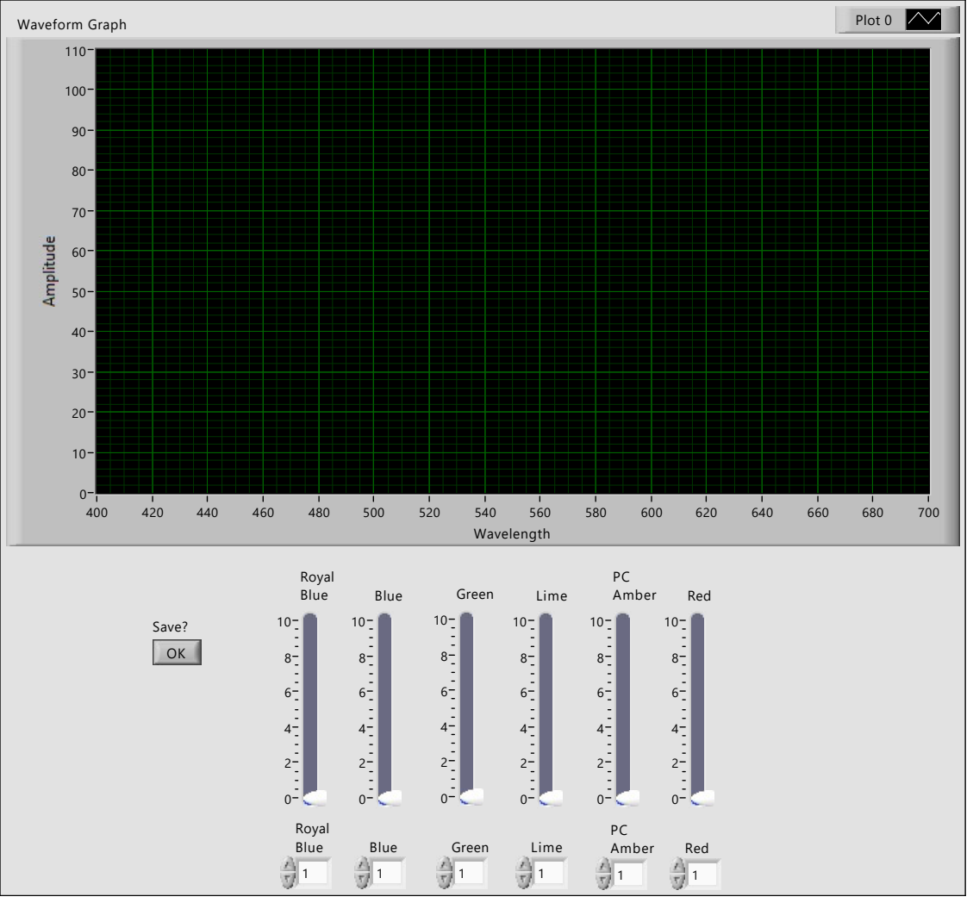
[picture p389: page 1]

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
# Wavelength

400 | 420 | 440 | 460 | 480 | 500 | 520 | 540 | 560 | 580 | 600 | 620 | 640 | 660 | 680 | 700
Waveform Graph | Plot 0

10

0

2

4

6

8

# Royal Blue

10

0

2

4

6

8

# Green

10

0

2

4

6

8

PC

# Amber

10

0

2

4

6

8

# Blue

10

0

2

4

6

8

# Lime

1

# Green

1

PC

# Amber

1

# Royal Blue

1

# Blue

1

# Lime

10

0

2

4

6

8

# Red

1

# Red

OK

# Save?

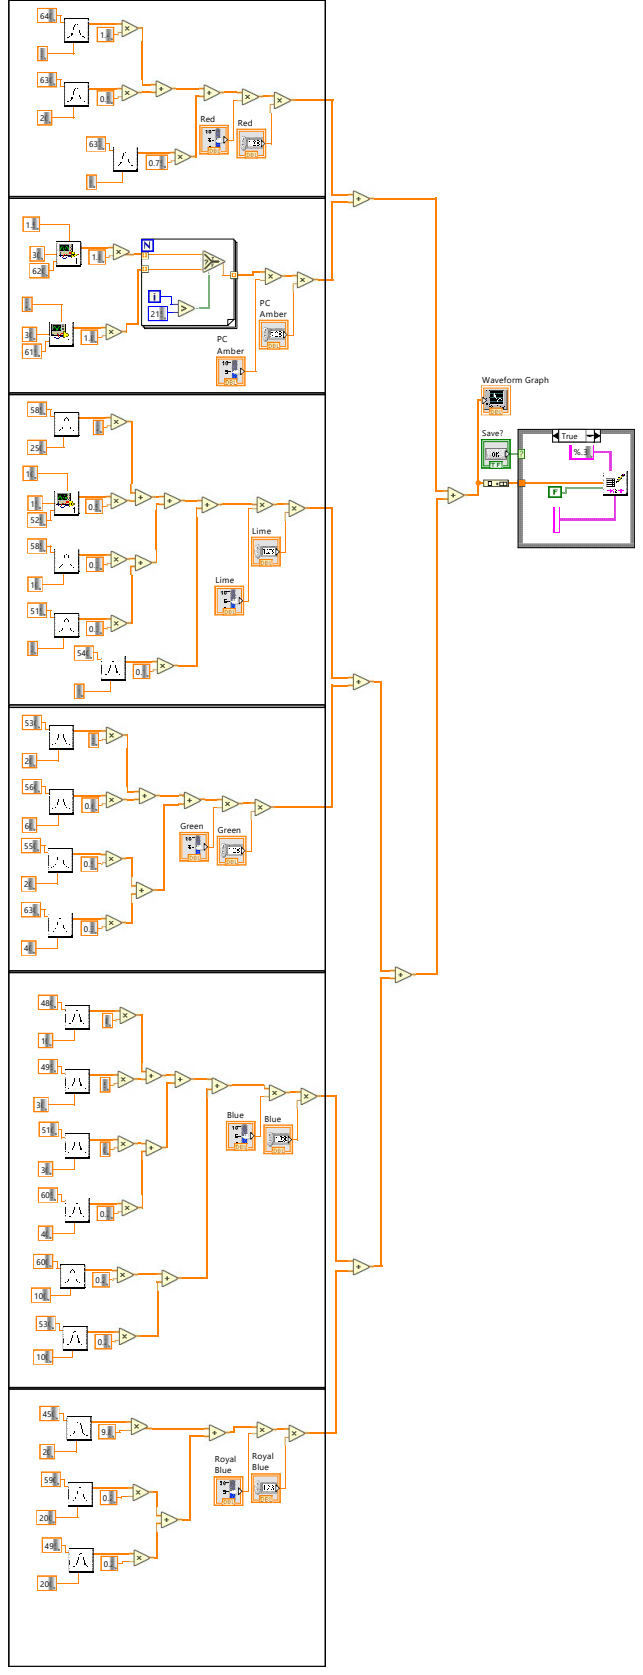
[picture p390: page 2]
Waveform Graph; Royal Blue; Green; PC Amber; Blue; Lime Green; Lime; Red; Save?; True
