appletonN/FYP/documents/Final Report/PDFs/back.pdf

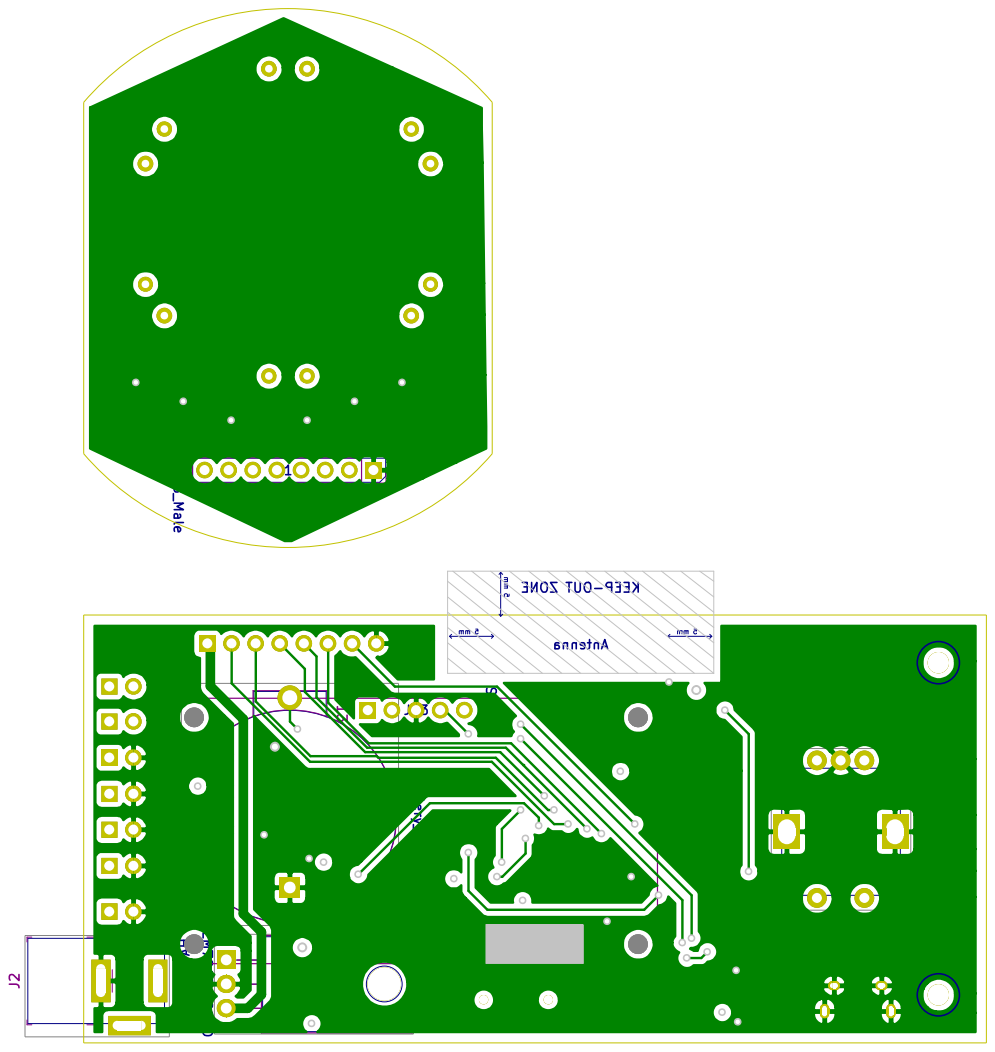
[picture p391: page 1]
