appletonN/FYP/documents/Final Report/PDFs/front.pdf

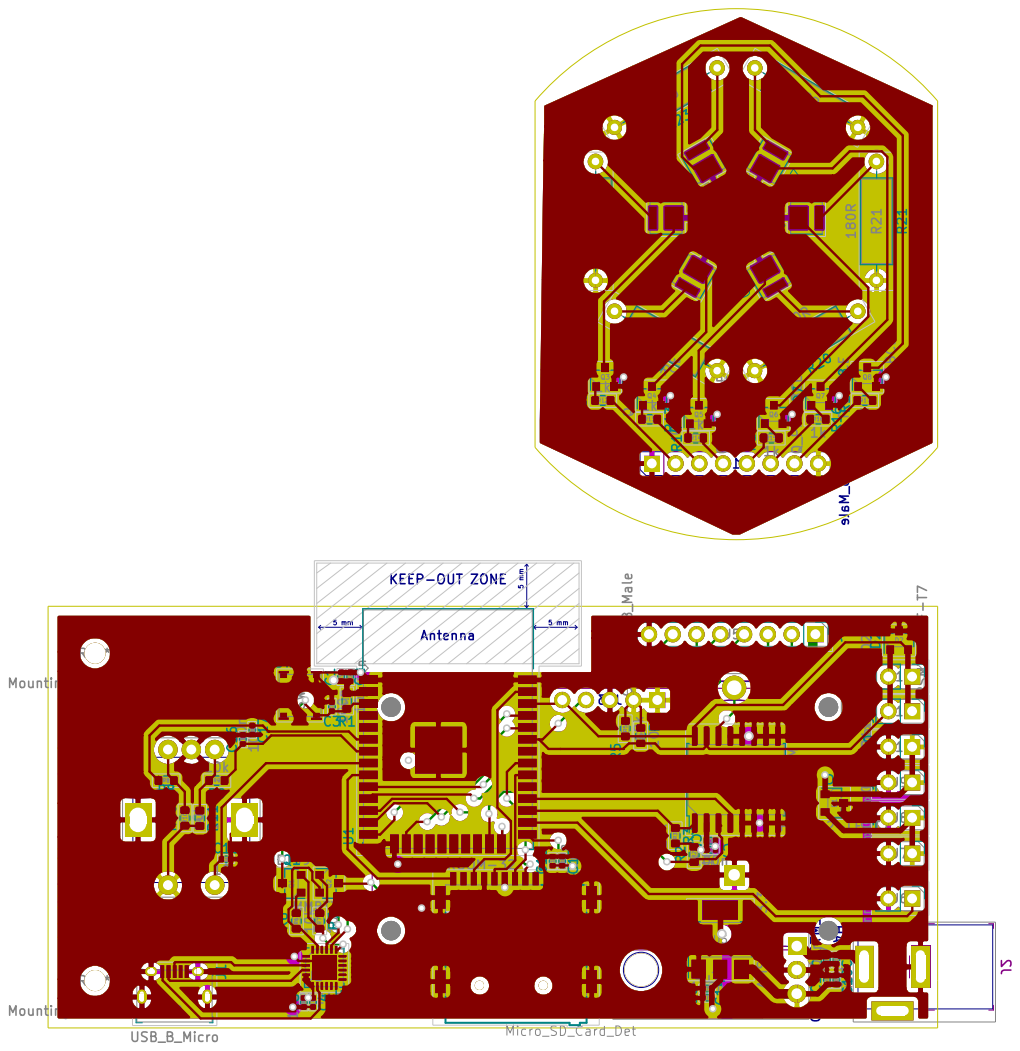
[picture p392: page 1]
