appletonN/FYP/Measurements/Calibration/Device/Output/automated.pdf

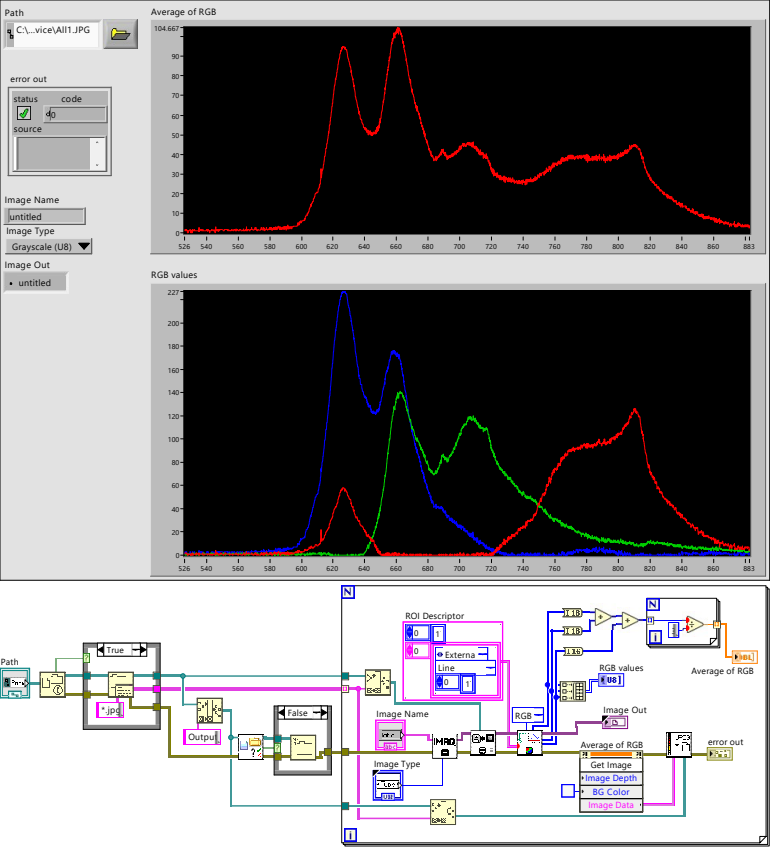
[picture p393: page 1]
status; code; source; error out; RGB values 227; untitled; Image Out; Image Name; Grayscale (U8); Image Type; C:\...vice\All1.JPG; Path; Externa Line 0 17; ROI Descriptor; RGB values; Image Out Image Name; RGB; Image Data; BG Color; Image Depth; Get Image; False *.jpg; True

Average of RGB

Average of RGB Output
