appletonN/FYP/Hardware/Project/Project.kicad_pcb

## KiCad design Hardware/Project/Project.kicad_pcb (2021-03-07)

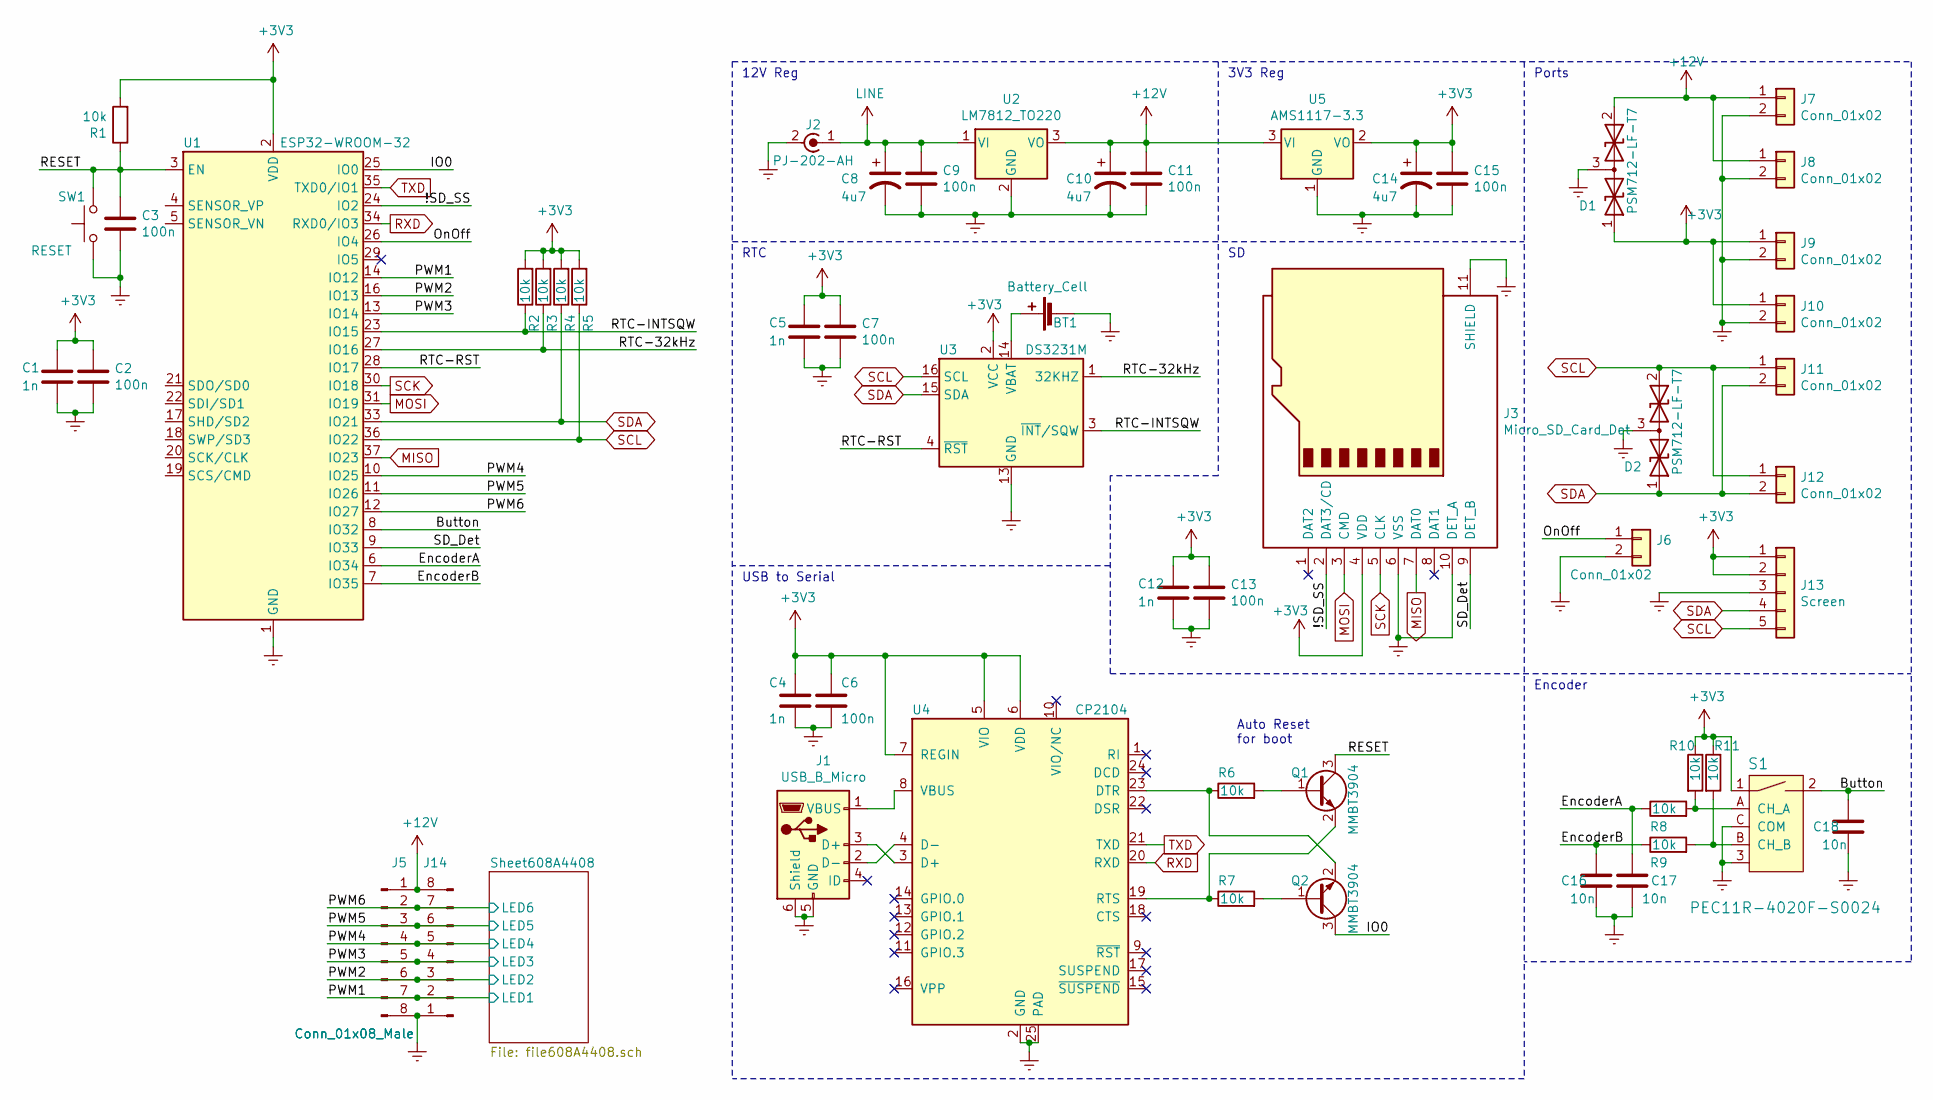
[picture p394: schematic Project.sch]

Parts:
BT1: Battery_Cell; Battery_Holder_Coin_2032_BS-7
C1, C4, C5, C12: 1n; C_0402_1005Metric
C2, C3, C6, C7, C9, C11, C13, C15: 100n; C_0402_1005Metric
C8, C10, C14: 4u7; C_0402_1005Metric
C16, C17, C18: 10n; C_0402_1005Metric
D1, D2: PSM712-LF-T7; SOT-23
J1: USB_B_Micro; USB_Micro_B_Female_10118194-0001LF
J2: PJ-202-AH; Barrel_Jack_5.5mmODx2.1mmID_PJ-202A
J3: Micro_SD_Card_Det; GCT_MEM2075-00-140-01-A
J5: Conn_01x08_Male; PinHeader_1x08_P2.54mm_Vertical
J6, J7, J8, J9, J10, J11, J12: Conn_01x02; PinHeader_1x02_P2.54mm_Vertical
J13: Screen; PinSocket_1x05_P2.54mm_Vertical
J14: Conn_01x08_Male; PinSocket_1x08_P2.54mm_Vertical
Q1, Q2: MMBT3904; SOT-23
R1, R2, R3, R4, R5, R6, R7, R8, R9, R10, R11: 10k; R_0603_1608Metric
S1: PEC11R-4020F-S0024; Rotary_Encoder_Switched_PEC11R; MPN PEC11R-4020F-S0024; Digi-Key_PN PEC11R-4020F-S0024-ND
SW1: RESET; Switch_Tactile_SMD_4.5x4.5mm_TL3315NF160Q
U1: ESP32-WROOM-32
U2: LM7812_TO220; TO-220-3_Horizontal_TabDown
U3: DS3231M; SOIC-16W_7.5x10.3mm_P1.27mm
U4: CP2104; QFN-24-1EP_4x4mm_P0.5mm_EP2.6x2.6mm
U5: AMS1117-3.3; SOT-223-3_TabPin2

Connections:
/!SD_SS: J3.2 (DAT3/CD), U1.24 (IO2)
/Button: C18.1, S1.2, U1.8 (IO32)
/EncoderA: C17.1, R8.1, U1.6 (IO34)
/EncoderB: C16.1, R9.1, U1.7 (IO35)
/IO0: Q2.3 (C), U1.25 (IO0)
/OnOff: J6.1, U1.26 (IO4)
/PWM1: J5.7, J14.2, U1.14 (IO12); also elsewhere on the board
/PWM2: J5.6, J14.3, U1.16 (IO13); also elsewhere on the board
/PWM3: J5.5, J14.4, U1.13 (IO14); also elsewhere on the board
/PWM4: J5.4, J14.5, U1.10 (IO25); also elsewhere on the board
/PWM5: J5.3, J14.6, U1.11 (IO26); also elsewhere on the board
/PWM6: J5.2, J14.7, U1.12 (IO27); also elsewhere on the board
/RESET: C3.1, Q1.3 (C), R1.1, SW1.2, U1.3 (EN)
/RTC-32kHz: R3.1, U1.27 (IO16), U3.1 (32KHZ)
/RTC-INTSQW: R2.1, U1.23 (IO15), U3.3 (~INT~/SQW)
/RTC-RST: U1.28 (IO17), U3.4 (~RST)
/SD_Det: J3.9 (DET_B), U1.9 (IO33)
Earth: BT1.2 (-), C1.2, C2.2, C3.2, C4.2, C5.2, C6.2, C7.2, C8.2, C9.2, C10.2, C11.2, C12.2, C13.2, C14.2, C15.2, C16.2, C17.2, C18.2, D1.3 (common), D2.3 (common), J1.5 (GND), J1.6 (Shield), J2.2 (Ext), J3.6 (VSS), J3.10 (DET_A), J3.11 (SHIELD), J5.8, J6.2, J7.2, J8.2, J9.2, J10.2, J13.3, J14.1, S1.3, S1.C (COM), SW1.1, U1.1 (GND), U1.15 (GND), U1.38 (GND), U1.39 (GND), U2.2 (GND), U3.5 (GND), U3.6 (GND), U3.7 (GND), U3.8 (GND), U3.9 (GND), U3.10 (GND), U3.11 (GND), U3.12 (GND), U3.13 (GND), U4.2 (GND), U4.25 (PAD), U5.1 (GND); also elsewhere on the board
LINE: C8.1, C9.1, J2.1 (In), U2.1 (VI)
MISO: J3.7 (DAT0), U1.37 (IO23)
MOSI: J3.3 (CMD), U1.31 (IO19)
unnamed: BT1.1 (+), U3.14 (VBAT)
unnamed: J1.1 (VBUS), U4.8 (VBUS)
unnamed: J1.2 (D-), U4.4 (D-)
unnamed: J1.3 (D+), U4.3 (D+)
unnamed: Q1.1 (B), R6.2
unnamed: Q1.2 (E), R7.1, U4.19 (RTS)
unnamed: Q2.1 (B), R7.2
unnamed: Q2.2 (E), R6.1, U4.23 (DTR)
unnamed: R8.2, R10.2, S1.A (CH_A)
unnamed: R9.2, R11.2, S1.B (CH_B)
RXD: U1.34 (RXD0/IO3), U4.20 (RXD)
SCK: J3.5 (CLK), U1.30 (IO18)
SCL: D2.2 (A2), J11.1, J12.1, J13.5, R5.1, U1.36 (IO22), U3.16 (SCL)
SDA: D2.1 (A1), J11.2, J12.2, J13.4, R4.1, U1.33 (IO21), U3.15 (SDA)
TXD: U1.35 (TXD0/IO1), U4.21 (TXD)

Notes on the sheet:
12V Reg
3V3 Reg
Ports
RTC
Auto Reset for boot
USB to Serial
Encoder

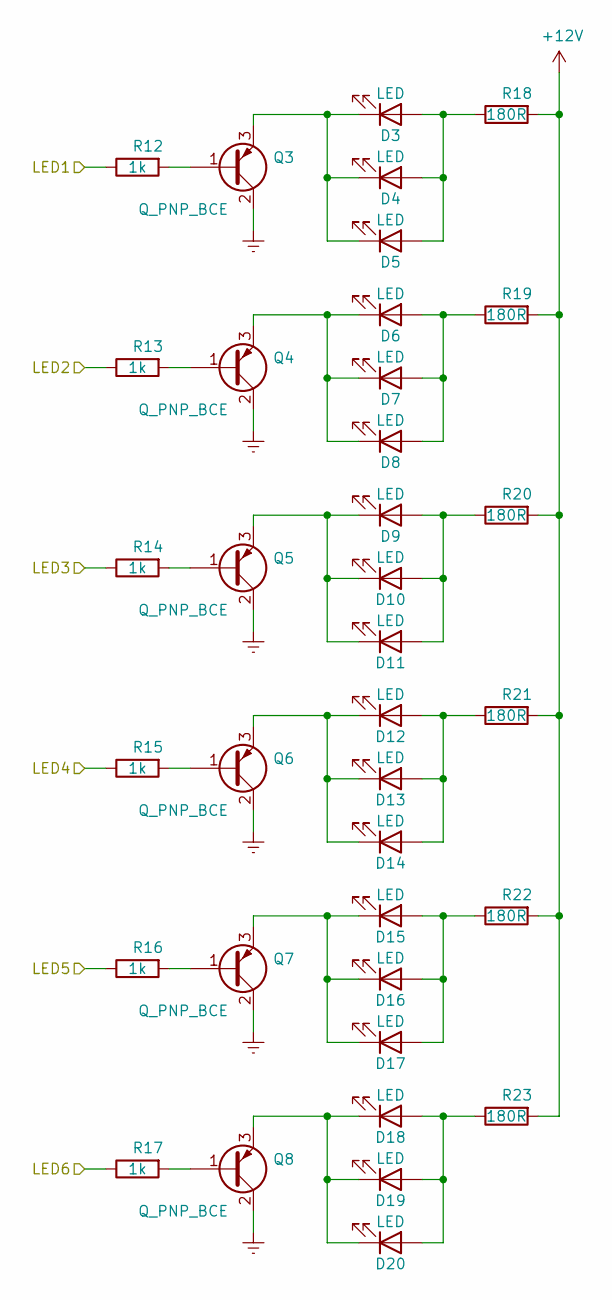
[picture p395: schematic file608A4408.sch]

Parts:
D3, D4, D5, D6, D7, D8, D9, D10, D11, D12, D13, D14, D15, D16, D17, D18, D19, D20: LED; LED_L135-A589003500000
Q3, Q4, Q5, Q6, Q7, Q8: Q_PNP_BCE; SOT-23
R12, R13, R14, R15, R16, R17: 1k; R_0603_1608Metric
R18, R19, R20, R21, R22, R23: 180R; R_Axial_DIN0309_L9.0mm_D3.2mm_P12.70mm_Horizontal

Connections:
/PWM1: R12.1; also elsewhere on the board
/PWM2: R13.1; also elsewhere on the board
/PWM3: R14.1; also elsewhere on the board
/PWM4: R15.1; also elsewhere on the board
/PWM5: R16.1; also elsewhere on the board
/PWM6: R17.1; also elsewhere on the board
Earth: Q3.2 (C), Q4.2 (C), Q5.2 (C), Q6.2 (C), Q7.2 (C), Q8.2 (C); also elsewhere on the board
unnamed: D3.1 (K), D4.1 (K), D5.1 (K), Q3.3 (E)
unnamed: D3.2 (A), D4.2 (A), D5.2 (A), R18.1
unnamed: D6.1 (K), D7.1 (K), D8.1 (K), Q4.3 (E)
unnamed: D6.2 (A), D7.2 (A), D8.2 (A), R19.1
unnamed: D9.1 (K), D10.1 (K), D11.1 (K), Q5.3 (E)
unnamed: D9.2 (A), D10.2 (A), D11.2 (A), R20.1
unnamed: D12.1 (K), D13.1 (K), D14.1 (K), Q6.3 (E)
unnamed: D12.2 (A), D13.2 (A), D14.2 (A), R21.1
unnamed: D15.1 (K), D16.1 (K), D17.1 (K), Q7.3 (E)
unnamed: D15.2 (A), D16.2 (A), D17.2 (A), R22.1
unnamed: D18.1 (K), D19.1 (K), D20.1 (K), Q8.3 (E)
unnamed: D18.2 (A), D19.2 (A), D20.2 (A), R23.1
unnamed: Q3.1 (B), R12.2
unnamed: Q4.1 (B), R13.2
unnamed: Q5.1 (B), R14.2
unnamed: Q6.1 (B), R15.2
unnamed: Q7.1 (B), R16.2
unnamed: Q8.1 (B), R17.2

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
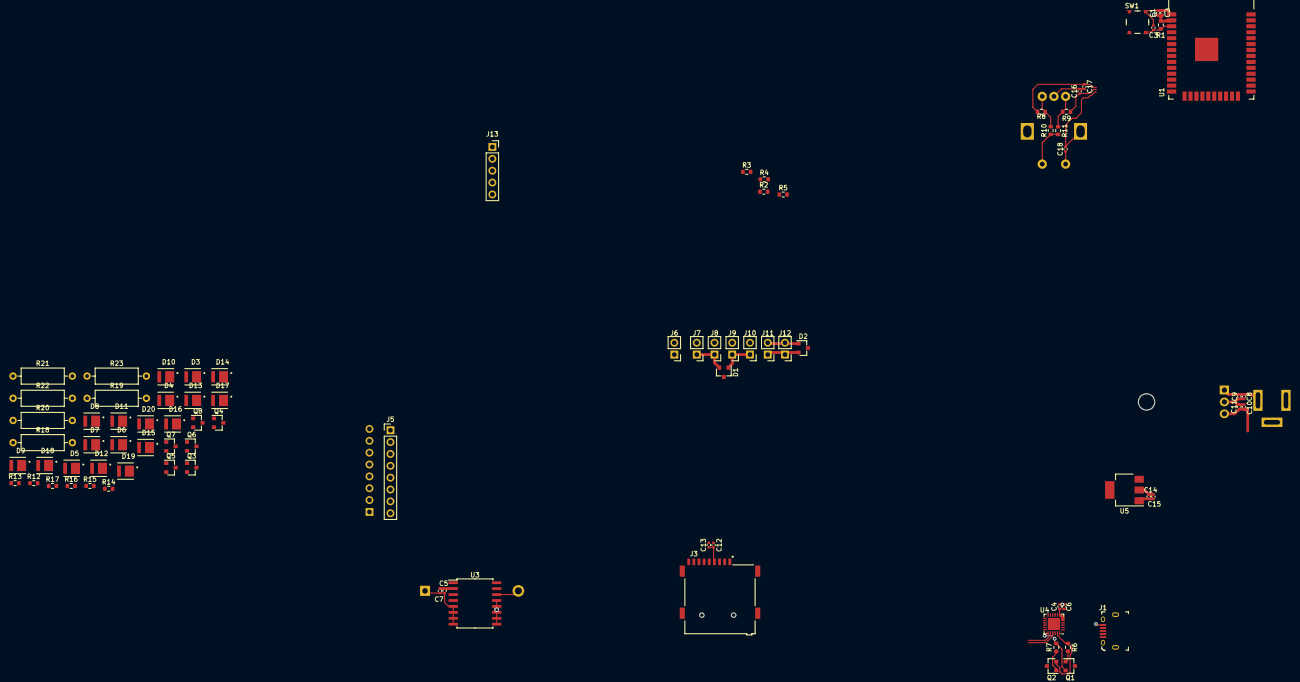
[picture p396: board Project.kicad_pcb from above]

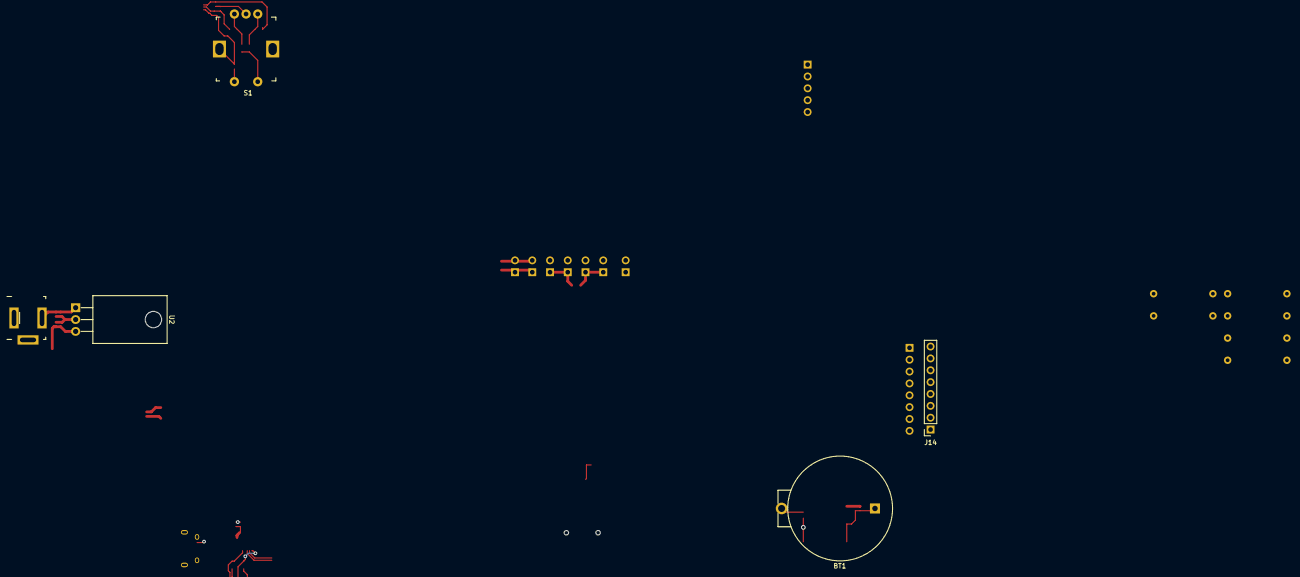
[picture p397: board Project.kicad_pcb from below]

Board: 4 copper layers, 90 parts (5 on the bottom side), 56 nets.
