appletonN/FYP/Hardware/Project/Project_2_smaller.kicad_pcb

## KiCad design Hardware/Project/Project_2_smaller.kicad_pcb (2021-03-21)

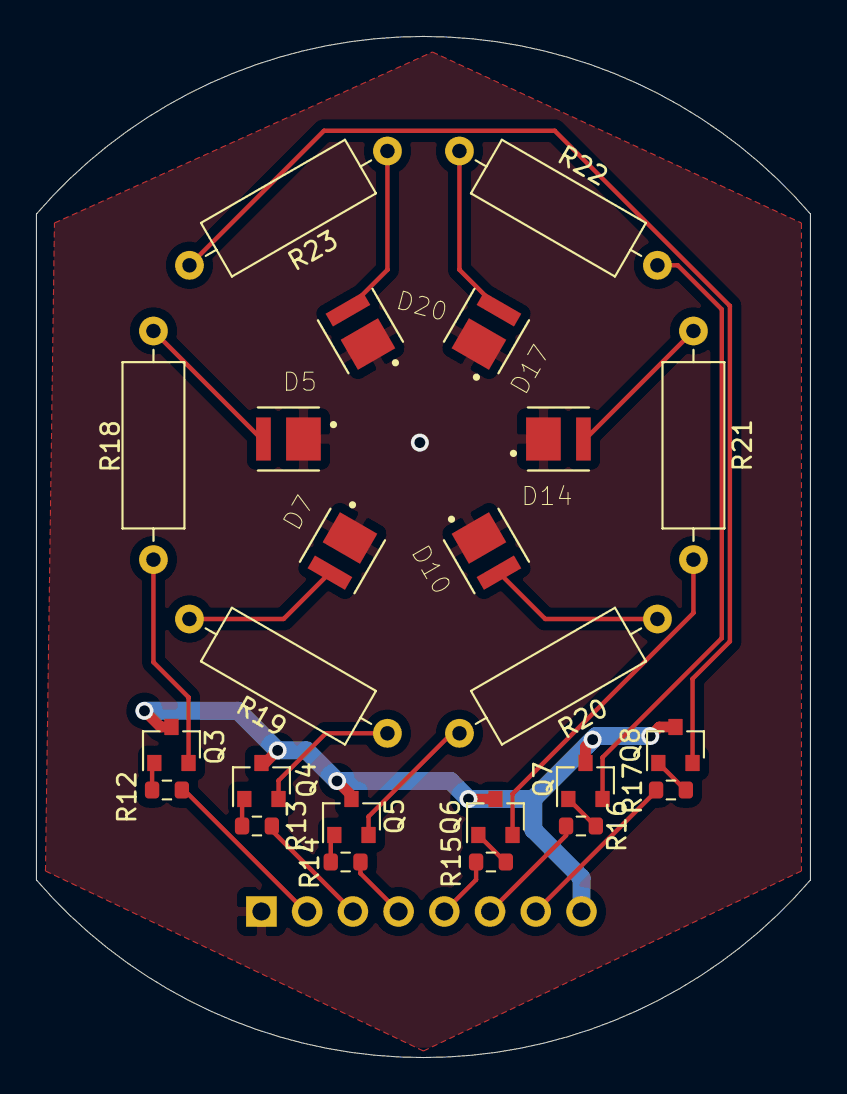
[picture p398: board Project_2_smaller.kicad_pcb from above]

Board: 4 copper layers, 43.0 x 56.7 mm, 25 parts (1 on the bottom side), 26 nets.

Parts:
D5, D7, D10, D14, D17, D20: LED; LED_L135-A589003500000
J14: Conn_01x08_Male; PinSocket_1x08_P2.54mm_Vertical
Q3, Q4, Q5, Q6, Q7, Q8: Q_PNP_BCE; SOT-23
R12, R13, R14, R15, R16, R17: 1k; R_0603_1608Metric
R18, R19, R20, R21, R22, R23: 180R; R_Axial_DIN0309_L9.0mm_D3.2mm_P12.70mm_Horizontal

Connections:
+12V: J14.8, Q3.3, Q4.3, Q5.3, Q6.3, Q7.3, Q8.3
/PWM1: J14.2, R12.1
/PWM2: J14.3, R13.1
/PWM3: J14.4, R14.1
/PWM4: J14.5, R15.1
/PWM5: J14.6, R16.1
/PWM6: J14.7, R17.1
Earth: D5.1, D7.1, D10.1, D14.1, D17.1, D20.1, J14.1
unnamed: D5.2, R18.1
unnamed: D7.2, R19.1
unnamed: D10.2, R20.1
unnamed: D14.2, R21.1
unnamed: D17.2, R22.1
unnamed: D20.2, R23.1
unnamed: Q3.1, R12.2
unnamed: Q3.2, R18.2
unnamed: Q4.1, R13.2
unnamed: Q4.2, R19.2
unnamed: Q5.1, R14.2
unnamed: Q5.2, R20.2
unnamed: Q6.1, R15.2
unnamed: Q6.2, R21.2
unnamed: Q7.1, R16.2
unnamed: Q7.2, R22.2
unnamed: Q8.1, R17.2
unnamed: Q8.2, R23.2
