appletonN/FYP/(commit log)

2021-03-21 update 21-03-21
    [BOM.xlsx, Calibration.xlsx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]
2021-04-08 First 2 Chapters
    [Calibration.xlsx, Final Report Marking Criteria 20-21(2).xlsx, Progress Review and Oral Presentation marking scheme 2021.xlsx, allOn.csv]
2021-04-20 added first part of methodology
    [Outdoors.csv, day.csv]
2021-04-21 finished Methodology
    [day.csv]
2021-04-27 finished Conclusion
    [Afternoon.csv, CFL.csv, Morning.csv, Philips Hue.csv, all.xlsx, day.csv, evening.csv, lights.csv]
