appletonN/FYP/Measurements/Desired/Measured/Other/IMG_1637.JPG

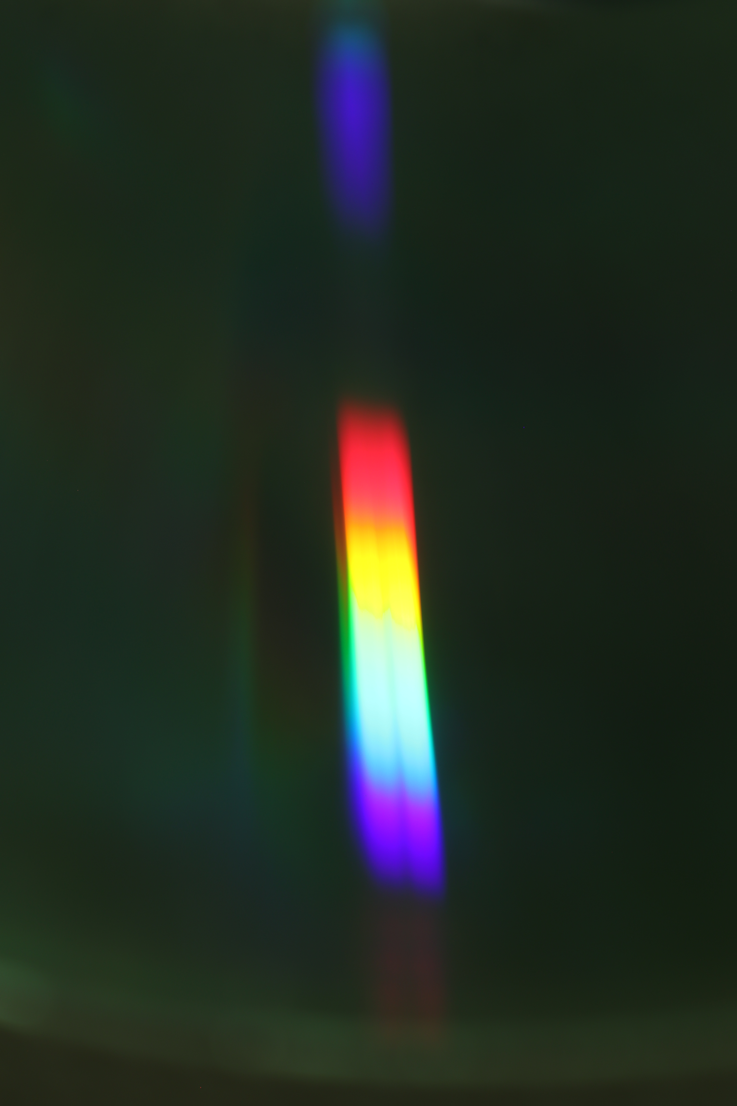
Measurements/Desired/Measured/Other/IMG_1637.JPG
